masonandrewmann/drum_machine/documentation:todo/Drum Machine Footprints.xlsx

Part | Footprint | LCSC
47u
1u
10u
4u7
220u
