masonandrewmann/drum_machine/harware_design/DrumMachineControlBoard/borderSVG2n/inPXXX__TEST2__DrumMachineControlBoard-brd_.dxf

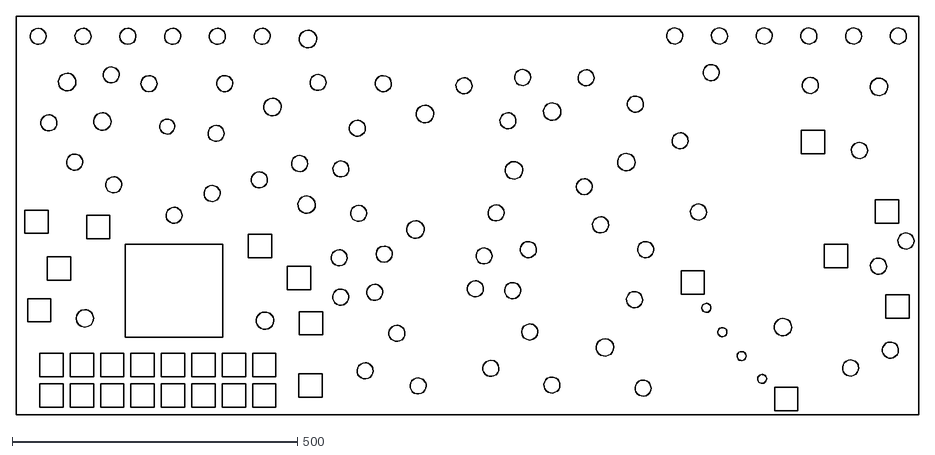
[picture p1: CAD file, 2023-01-13]
harware_design/DrumMachineControlBoard/borderSVG2n/inPXXX__TEST2__DrumMachineControlBoard-brd_.dxf
1582.3 x 697.9
