masonandrewmann/drum_machine/harware_design/DrumMachineControlBoard/borderSVG2n/TEST3__DrumMachineControlBoard-brd_.dxf

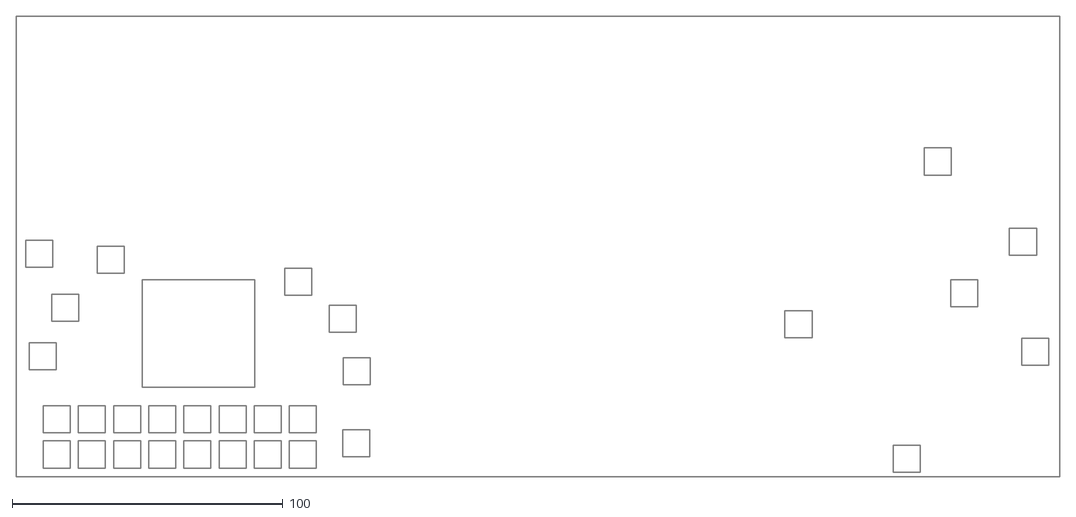
[picture p2: CAD file, 2023-01-13]
harware_design/DrumMachineControlBoard/borderSVG2n/TEST3__DrumMachineControlBoard-brd_.dxf
385.8 x 170.2
