masonandrewmann/drum_machine/harware_design/DrumMachineControlBoard/borderSVG2n/PXXX__TEST2__DrumMachineControlBoard-brd_.dxf

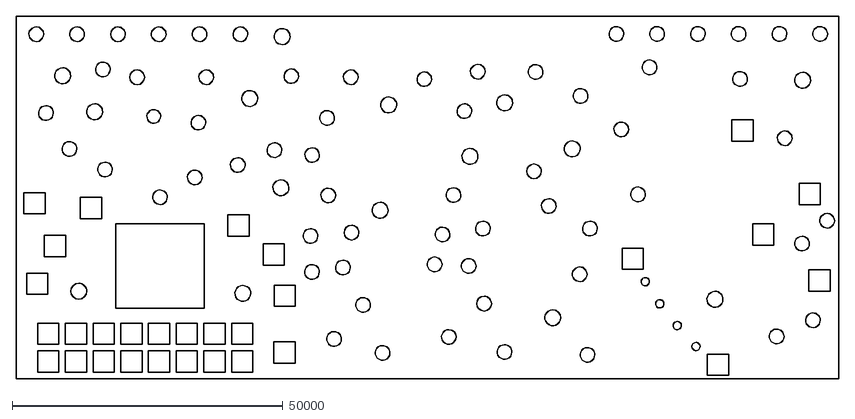
[picture p3: CAD file, 2023-01-13]
harware_design/DrumMachineControlBoard/borderSVG2n/PXXX__TEST2__DrumMachineControlBoard-brd_.dxf
151900.0 x 67003.0
