masonandrewmann/drum_machine/harware_design/DrumMachineControlBoard/borderSVG2n/mmmmTEST2__DrumMachineControlBoard-brd_.dxf

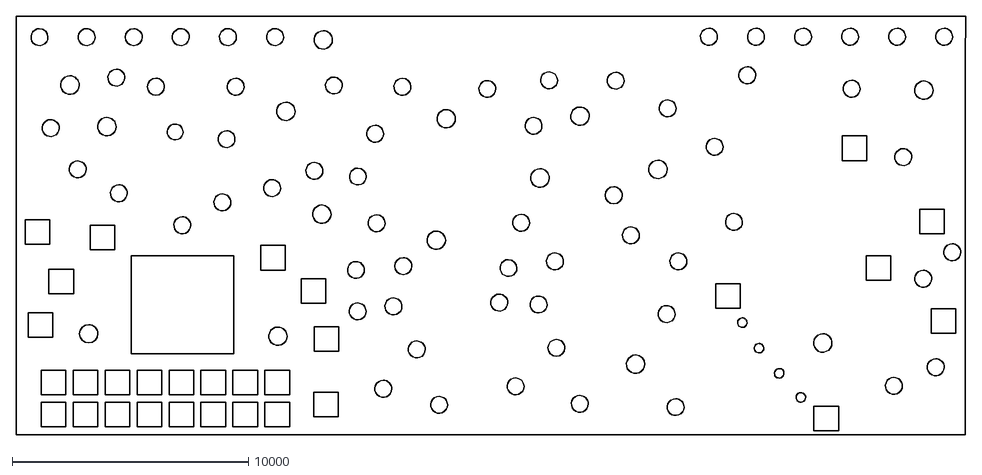
[picture p4: CAD file, 2023-01-13]
harware_design/DrumMachineControlBoard/borderSVG2n/mmmmTEST2__DrumMachineControlBoard-brd_.dxf
40190.2 x 17727.9
