masonandrewmann/drum_machine/harware_design/DrumMachineControlBoard/borderSVG2n/cmPXXX__TEST2__DrumMachineControlBoard-brd_.dxf

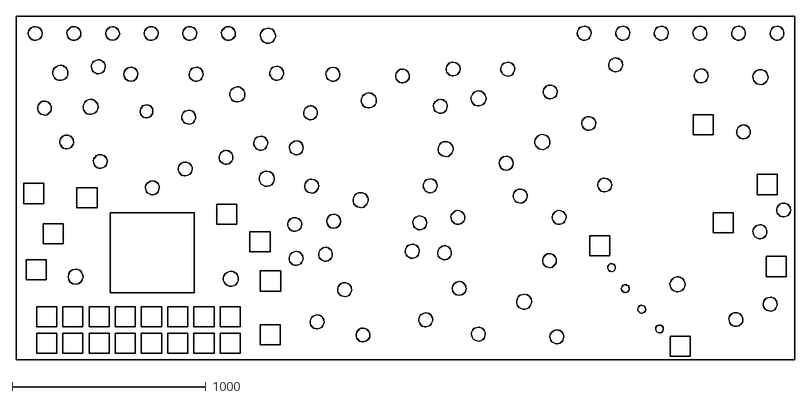
[picture p6: CAD file, 2023-01-13]
harware_design/DrumMachineControlBoard/borderSVG2n/cmPXXX__TEST2__DrumMachineControlBoard-brd_.dxf
4019.0 x 1772.8
