masonandrewmann/drum_machine/(list of files, cad)

Other CAD files:
harware_design/BassDrum_TR909/borderSVG/BassDrum_TR909-B_Mask.dxf
harware_design/TR909 Snare Drum/borderSVG/TR909 Snare Drum-B_Mask.dxf
harware_design/Triple Waveshaper - CGS/borderSVG/Triple Waveshaper - CGS-B_Mask.dxf
