masonandrewmann/drum_machine/documentation:todo/DRUM MACHINE KLUDGES AND ASSEMBLY NOTES .rtf

DRUM MACHINE KLUDGES AND ASSEMBLY NOTES

LCD SCREEN LED PIN IS WRONG - should be connected to GND rather than +3.3v
remove R177 and short pin 1 and 2 on the LCD pin header

LCD Screen mounting holes are too small for M3 screws
either use smaller screws or drill the holes bigger on the LCD screen board and control board

Pinout for 2N7000 mosfets in trigger output level shifters is wrong. pins 1 and 2 should be flipped
-just flip the mosfets upside down and bend their pins down when soldering

Trigger inputs are floating
-add 1M pulldown resistor soldered directly to jack pins

Getting audio output from shield
-need to solder wires from shield line out to input of mixer section

MIDI input
-theres capacitance in the line so pullup needs to be lower. replace R162 with a 220Ohm resistor
-optocoupler needs to pull up to 3.3v instead of 5v
-cut trace to 5v on R162 and addd a jumper to the closest 3.3v pad on the pot below it (square pad))

SNARE CONNECTIONS
-short pins W and 3 on tone pot

All volume knobs are baackwards
