masonandrewmann/drum_machine/documentation:todo/DRUM MACHINE CONTROL BOARD NOTES.rtf

DRUM MACHINE CONTROL BOARD NOTES

all trimmer style potentiometers have wrong footprint
-holes for side tabs are too small
-tabs on pots can be cut to size relatively easily

power connector next to barrel jack is wrong
-just solder it in backwards so tabs are to right on kicad board view
