masonandrewmann/drum_machine/documentation:todo/jumpers.rtf

cynare jumpers
noise/shim::: L - noise R - shim M - noise/shim
damper:::: harwire it ! - no pot - REMOVE
Decay::: L - dec1 R /M- dec23
env::: L-env3 M-env2 R-env1
freq::: L:-12 M-freqw R:+12
res:::: L-res1 M/R-res23
imp::: not doing anything maybe remove it?
switch: LP - top right HP - bottom left BP-bottomrightt COM-midleft

snare jumpers
level:::: L-lvl1 M/R-lvl3w
tune::: L-tune3 M-tuneW R-tune1
snap:::: L-snap1 MR-snap3w
tone:::: idk if its working

bass
volume:::: L-out1W MR-out3
atk:::: LM- atk1w R-atk3
dec:::: L-depth1 M-depthW R-depth3
tuneDep:::: L-tune MR-GND
tuneDec:::: LM-dec1W R-dec3
Dist::: LM-dist1W R-dist3
pitch:::: LM-pitch1W R-pitch3
