masonandrewmann/drum_machine/harware_design/Triple Waveshaper - CGS/tws.pdf

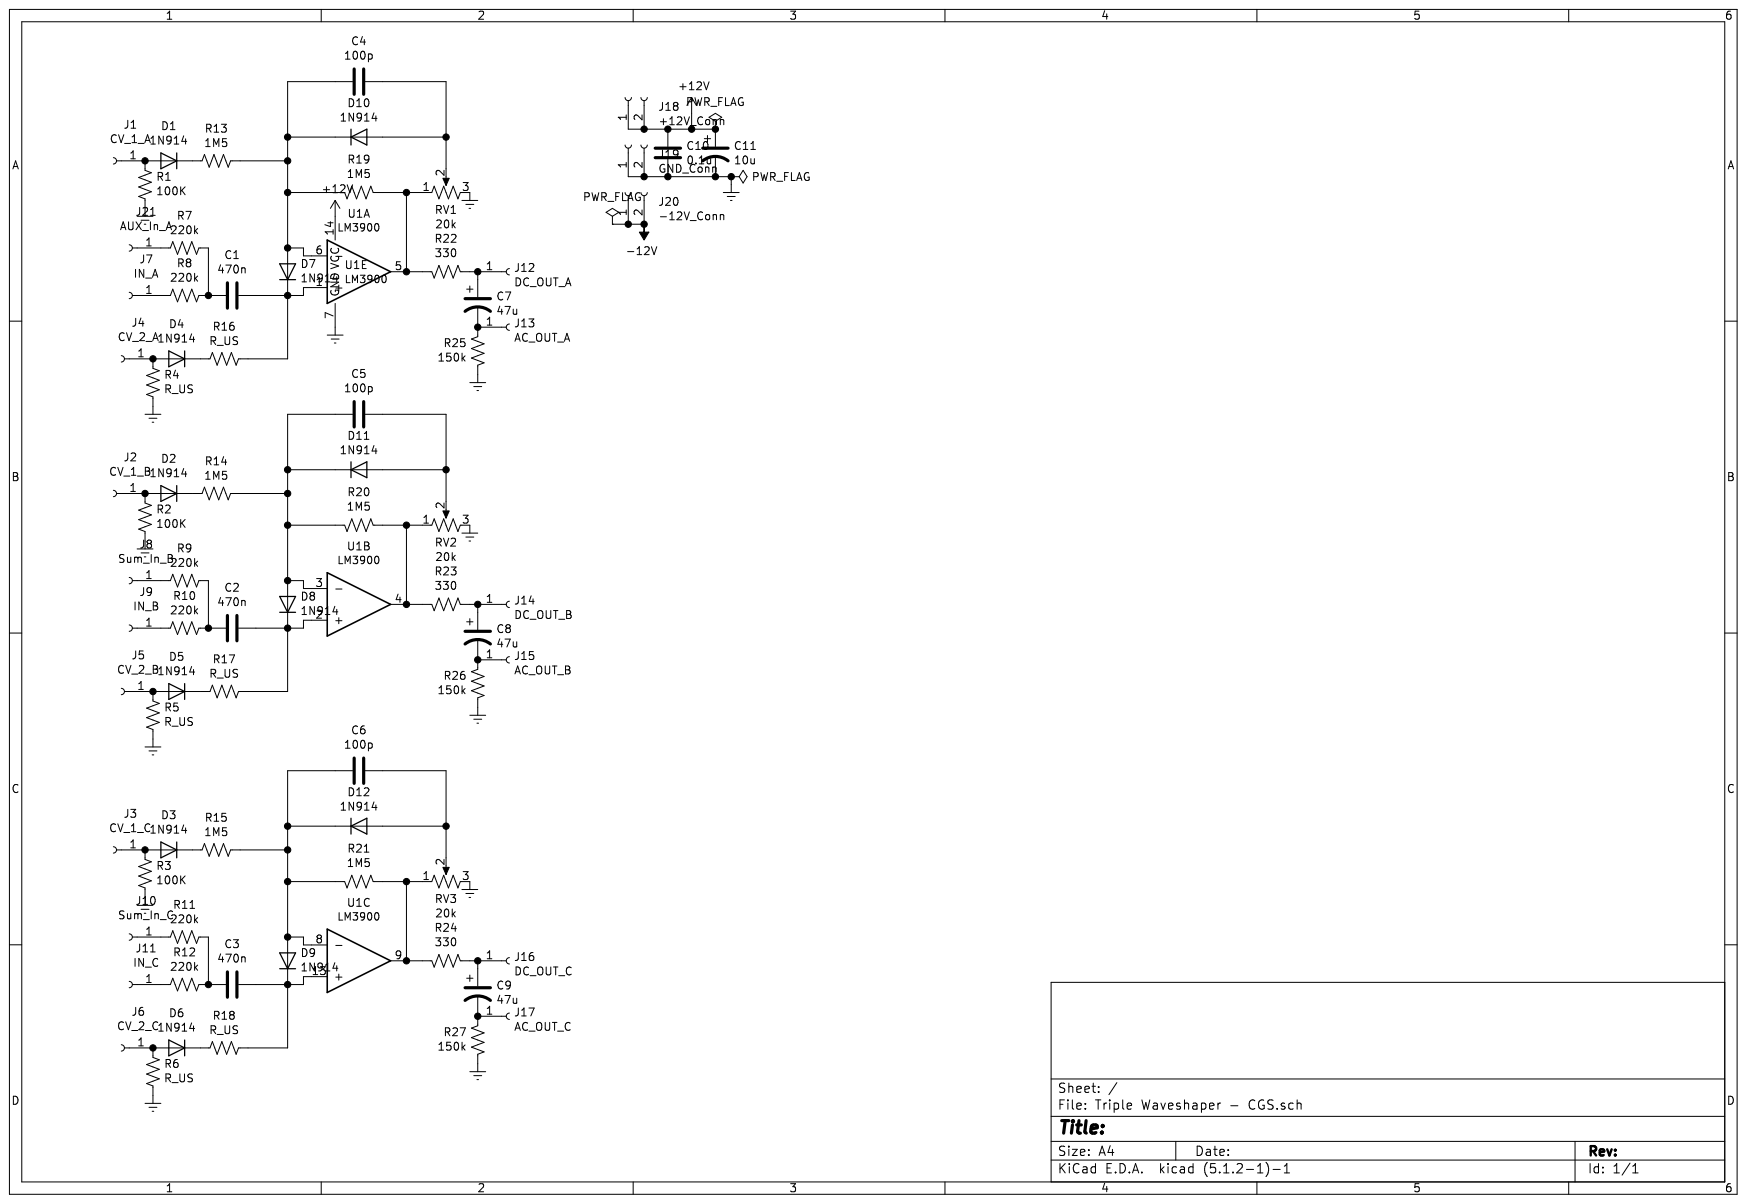
[picture p7: page 1]
