masonandrewmann/drum_machine/harware_design/ALTERNATEDrumMachinePower/borderSVG2/eeeeeffffff.pdf

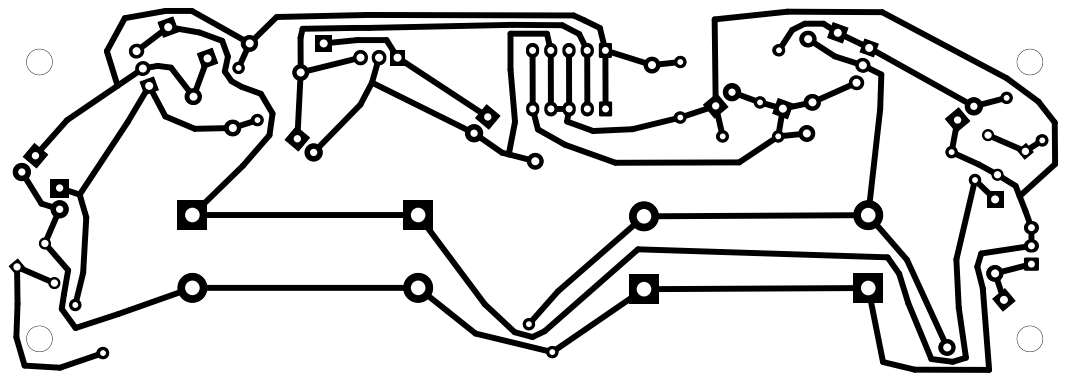
[picture p8: page 1]
