masonandrewmann/drum_machine/harware_design/TR909 Snare Drum/TR909 Snare Drum.kicad_pcb

## KiCad design harware_design/TR909 Snare Drum/TR909 Snare Drum.kicad_pcb (2023-02-01)

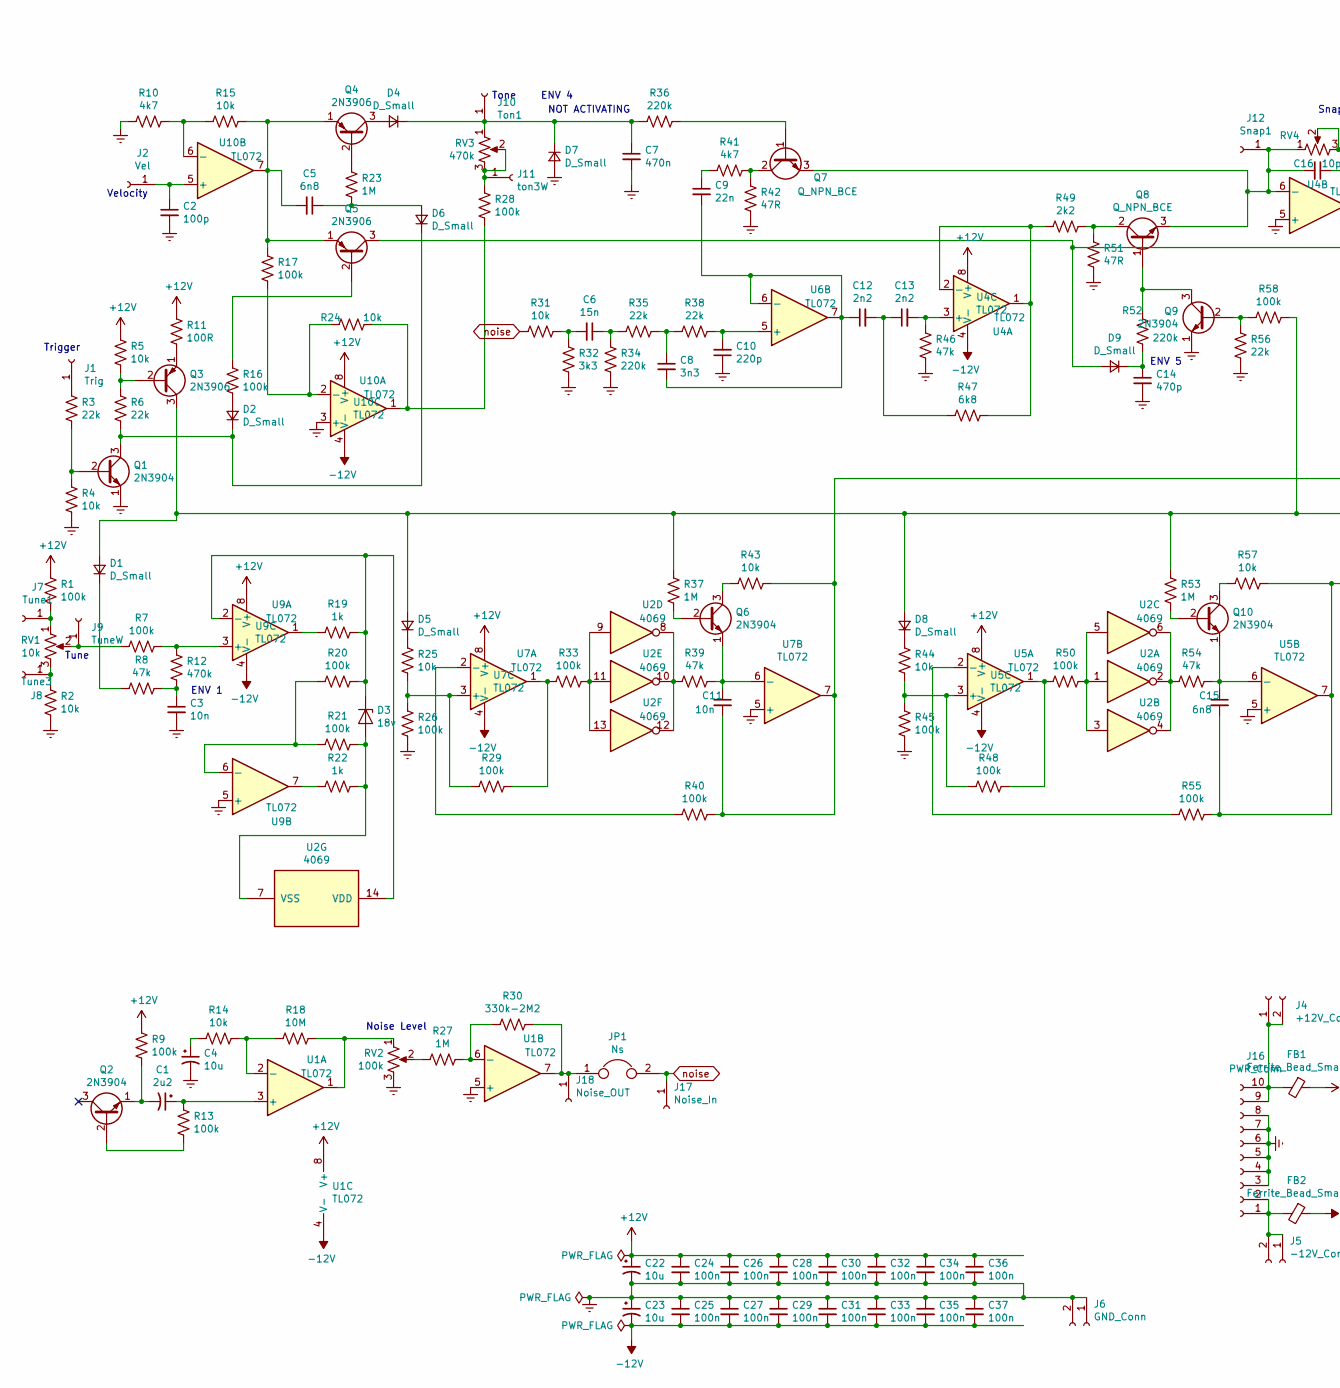
[picture p9: schematic TR909 Snare Drum.sch, part in row 1, column 1]

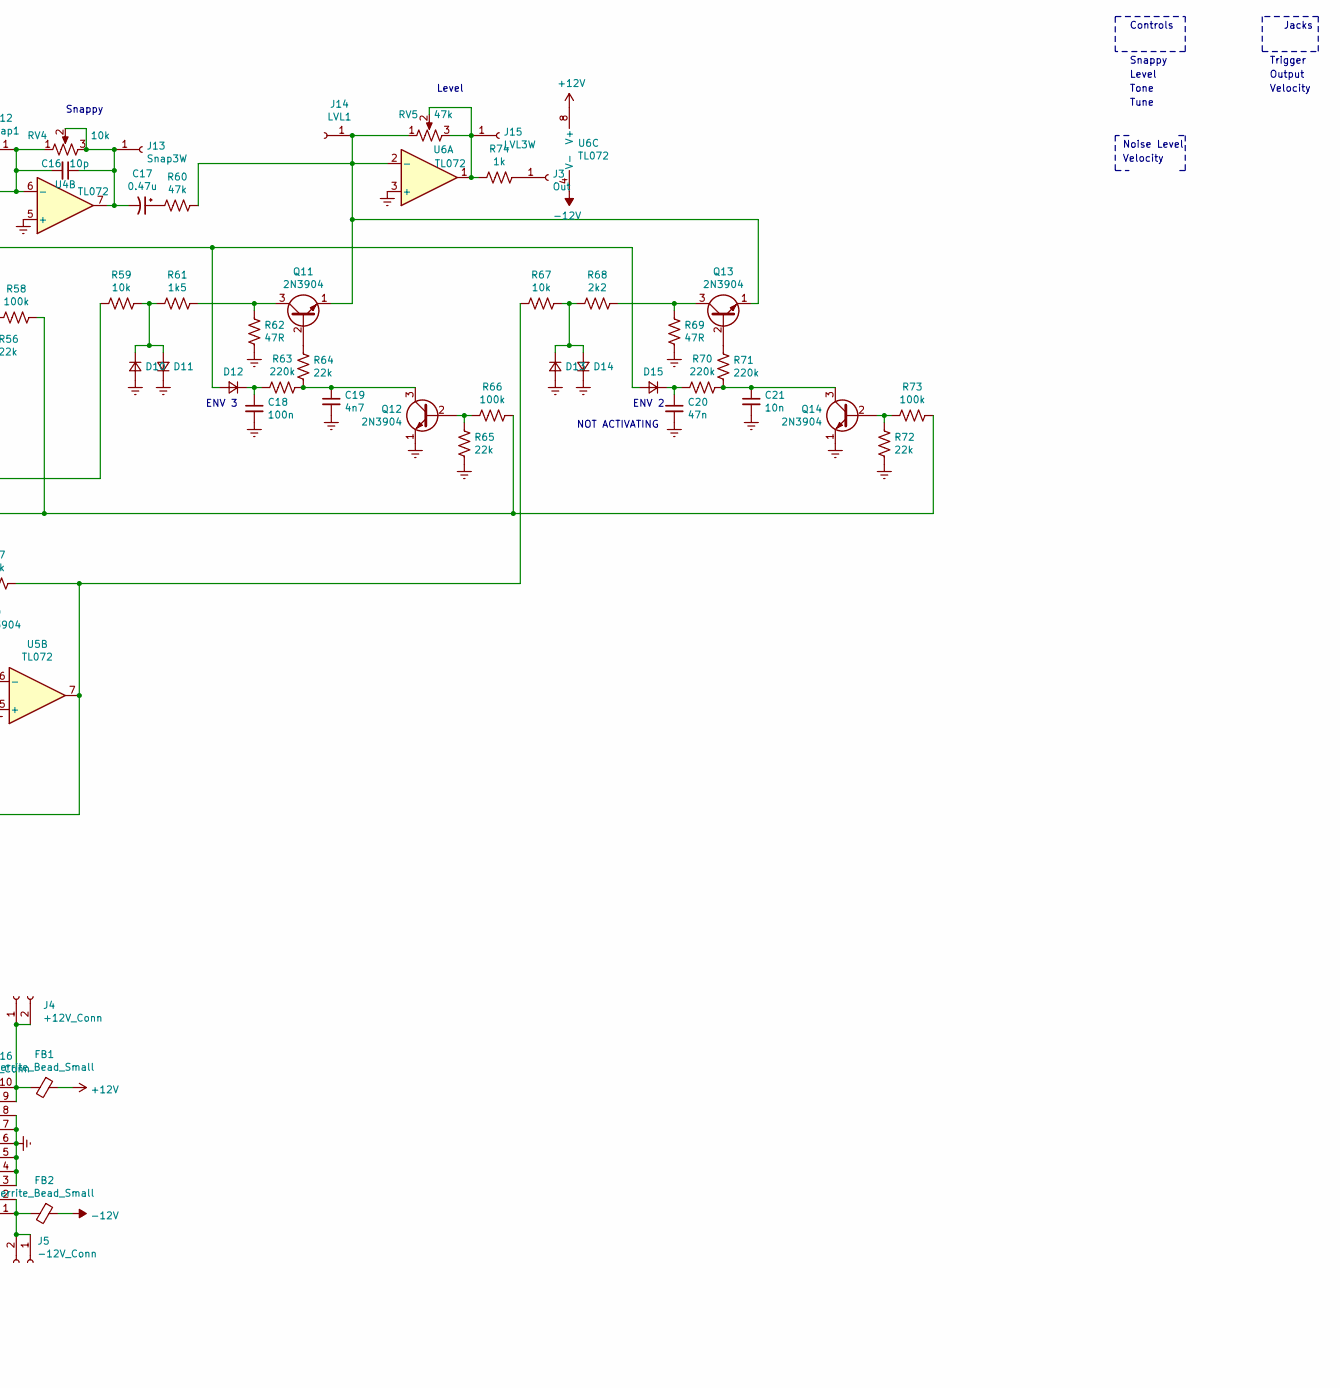
[picture p10: schematic TR909 Snare Drum.sch, part in row 1, column 2]

Parts:
C1: 2u2; C_0805_2012Metric_Pad1.15x1.40mm_HandSolder
C2: 100p; C_0603_1608Metric_Pad1.05x0.95mm_HandSolder
C3, C11, C21: 10n; C_0603_1608Metric_Pad1.05x0.95mm_HandSolder
C4, C22, C23: 10u; CP_Elec_5x5.4
C5, C15: 6n8; C_0603_1608Metric_Pad1.05x0.95mm_HandSolder
C6: 15n; C_0603_1608Metric_Pad1.05x0.95mm_HandSolder
C7: 470n; C_0603_1608Metric_Pad1.05x0.95mm_HandSolder
C8: 3n3; C_0603_1608Metric_Pad1.05x0.95mm_HandSolder
C9: 22n; C_0603_1608Metric_Pad1.05x0.95mm_HandSolder
C10: 220p; C_0603_1608Metric_Pad1.05x0.95mm_HandSolder
C12, C13: 2n2; C_0603_1608Metric_Pad1.05x0.95mm_HandSolder
C14: 470p; C_0603_1608Metric_Pad1.05x0.95mm_HandSolder
C16: 10p; C_0603_1608Metric_Pad1.05x0.95mm_HandSolder
C17: 0.47u; C_0603_1608Metric_Pad1.05x0.95mm_HandSolder
C18, C24, C25, C26, C27, C28, C29, C30, C31, C32, C33, C34, C35, C36, C37: 100n; C_0603_1608Metric_Pad1.05x0.95mm_HandSolder
C19: 4n7; C_0603_1608Metric_Pad1.05x0.95mm_HandSolder
C20: 47n; C_0603_1608Metric_Pad1.05x0.95mm_HandSolder
D1, D2, D4, D5, D6, D7, D8, D9, D10, D11, D12, D13, D14, D15: D_Small; D_SOD-323_HandSoldering
D3: 18v; D_T-1_P5.08mm_Horizontal
FB1, FB2: Ferrite_Bead_Small; L_Axial_L7.0mm_D3.3mm_P2.54mm_Vertical_Fastron_MICC
J1: Trig; SolderWirePad_1x01_Drill1mm
J2: Vel; SolderWirePad_1x01_Drill1mm
J3: Out; SolderWirePad_1x01_Drill1mm
J4: +12V_Conn; SolderWirePad_1x02_P3.81mm_Drill1mm
J5: -12V_Conn; SolderWirePad_1x02_P3.81mm_Drill1mm
J6: GND_Conn; SolderWirePad_1x02_P3.81mm_Drill1mm
J7: Tune1; SolderWirePad_1x01_Drill1mm
J8: Tune3; SolderWirePad_1x01_Drill1mm
J9: TuneW; SolderWirePad_1x01_Drill1mm
J10: Ton1; SolderWirePad_1x01_Drill1mm
J11: ton3W; SolderWirePad_1x01_Drill1mm
J12: Snap1; SolderWirePad_1x01_Drill1mm
J13: Snap3W; SolderWirePad_1x01_Drill1mm
J14: LVL1; SolderWirePad_1x01_Drill1mm
J15: LVL3W; SolderWirePad_1x01_Drill1mm
J16: PWR_Conn; IDC-Header_2x05_P2.54mm_Vertical
J17: Noise_In; SolderWirePad_1x01_Drill1mm
J18: Noise_OUT; SolderWirePad_1x01_Drill1mm
JP1: Ns; SolderJumper-2_P1.3mm_Open_RoundedPad1.0x1.5mm
Q1, Q2, Q6, Q9, Q10, Q11, Q12, Q13, Q14: 2N3904; TSOT-23_HandSoldering
Q3, Q4, Q5: 2N3906; TSOT-23_HandSoldering
Q7, Q8: Q_NPN_BCE; SolderWirePad_1x03_P3.81mm_Drill1.2mm
R1, R7, R9, R13, R16, R17, R20, R21, R26, R28, R29, R33, R40, R45, R48, R50, R55, R58, R66, R73: 100k; R_0603_1608Metric_Pad1.05x0.95mm_HandSolder
R2, R4, R5, R14, R15, R24, R25, R31, R43, R44, R57, R59, R67: 10k; R_0603_1608Metric_Pad1.05x0.95mm_HandSolder
R3, R6, R35, R38, R56, R64, R65, R72: 22k; R_0603_1608Metric_Pad1.05x0.95mm_HandSolder
R8, R39, R46, R54, R60: 47k; R_0603_1608Metric_Pad1.05x0.95mm_HandSolder
R10, R41: 4k7; R_0603_1608Metric_Pad1.05x0.95mm_HandSolder
R11: 100R; R_0603_1608Metric_Pad1.05x0.95mm_HandSolder
R12: 470k; R_0603_1608Metric_Pad1.05x0.95mm_HandSolder
R18: 10M; R_0603_1608Metric_Pad1.05x0.95mm_HandSolder
R19, R22, R74: 1k; R_0603_1608Metric_Pad1.05x0.95mm_HandSolder
R23, R27, R37, R53: 1M; R_0603_1608Metric_Pad1.05x0.95mm_HandSolder
R30: 330k-2M2; R_Axial_DIN0207_L6.3mm_D2.5mm_P7.62mm_Horizontal
R32: 3k3; R_0603_1608Metric_Pad1.05x0.95mm_HandSolder
R34, R36, R52, R63, R70, R71: 220k; R_0603_1608Metric_Pad1.05x0.95mm_HandSolder
R42, R51, R62, R69: 47R; R_0603_1608Metric_Pad1.05x0.95mm_HandSolder
R47: 6k8; R_0603_1608Metric_Pad1.05x0.95mm_HandSolder
R49, R68: 2k2; R_0603_1608Metric_Pad1.05x0.95mm_HandSolder
R61: 1k5; R_0603_1608Metric_Pad1.05x0.95mm_HandSolder
RV1, RV4: 10k; Potentiometer_Runtron_RM-065_Vertical
RV2: 100k; Potentiometer_Runtron_RM-065_Vertical
RV3: 470k; Potentiometer_Runtron_RM-065_Vertical
RV5: 47k; Potentiometer_Runtron_RM-065_Vertical
U1, U4, U5, U6, U7, U9, U10: TL072; SOIC-8_3.9x4.9mm_P1.27mm
U2: 4069; SOIC-14_3.9x8.7mm_P1.27mm

Connections:
+12V: C22.1, C24.1, C26.1, C28.1, C30.1, C32.1, C34.1, C36.1, FB1.1, R1.1, R5.2, R9.1, R11.2, U1.8 (V+), U4.8 (V+), U5.8 (V+), U6.8 (V+), U7.8 (V+), U9.8 (V+), U10.8 (V+)
-12V: C23.2, C25.2, C27.2, C29.2, C31.2, C33.2, C35.2, C37.2, FB2.1, U1.4 (V-), U4.4 (V-), U5.4 (V-), U6.4 (V-), U7.4 (V-), U9.4 (V-), U10.4 (V-)
Earth: C2.2, C3.2, C4.2, C7.2, C10.1, C14.2, C18.2, C19.2, C20.2, C21.2, C22.2, C23.1, C24.2, C25.1, C26.2, C27.1, C28.2, C29.1, C30.2, C31.1, C32.2, C33.1, C34.2, C35.1, C36.2, C37.1, D7.2 (A), D10.2 (A), D11.1 (K), D13.2 (A), D14.1 (K), J6.1, J6.2, J16.3, J16.4, J16.5, J16.6, J16.7, J16.8, Q1.1 (E), Q9.1 (E), Q12.1 (E), Q14.1 (E), R2.2, R4.1, R10.2, R26.2, R32.1, R34.1, R42.2, R45.2, R46.2, R51.1, R56.1, R62.2, R65.2, R69.2, R72.2, RV2.3, U1.5 (+), U4.5 (+), U5.5 (+), U6.3 (+), U7.5 (+), U9.5 (+), U10.3 (+)
unnamed: C1.1, R13.1, U1.3 (+)
unnamed: C1.2, Q2.1 (E), R9.2
unnamed: C2.1, J2.1, U10.5 (+)
unnamed: C3.1, R8.2, R12.2
unnamed: C4.1, R14.2
unnamed: C5.1, D6.2 (A), R23.1
unnamed: C5.2, Q4.1 (E), Q5.1 (E), R15.1, R17.2, U10.7
unnamed: C6.1, R34.2, R35.1
unnamed: C6.2, R31.1, R32.2
unnamed: C7.1, D4.1 (K), D7.1 (K), J10.1, R36.1, RV3.1
unnamed: C8.1, R35.2, R38.1
unnamed: C9.1, R41.1
unnamed: C10.2, R38.2, U6.5 (+)
unnamed: C11.1, Q6.1 (E), R39.2, U7.6 (-)
unnamed: C11.2, R40.2, R43.1, R59.1, U7.7
unnamed: C8.2, C9.2, C12.1, U6.6 (-), U6.7
unnamed: C12.2, C13.1, R47.1
unnamed: C13.2, R46.1, U4.3 (+)
unnamed: C14.1, D9.1 (K), R52.1
unnamed: C15.1, Q10.1 (E), R54.2, U5.6 (-)
unnamed: C15.2, R55.2, R57.1, R67.1, U5.7
unnamed: C16.1, C17.2, J13.1, RV4.2, RV4.3, U4.7
unnamed: C16.2, J12.1, Q7.3 (E), Q8.3 (E), RV4.1, U4.6 (-)
unnamed: C17.1, R60.2
unnamed: C18.1, D12.1 (K), R63.2
unnamed: C19.1, Q12.3 (C), R63.1, R64.2
unnamed: C20.1, D15.1 (K), R70.2
unnamed: C21.1, Q14.3 (C), R70.1, R71.2
unnamed: D1.1 (K), R8.1
unnamed: D1.2 (A), D5.2 (A), D8.2 (A), Q3.3 (C), R37.1, R53.1, R58.2, R66.1, R73.1
unnamed: D2.1 (K), D6.1 (K), Q1.3 (C), R6.1
unnamed: D2.2 (A), R16.1
unnamed: D3.1 (K), R19.2, R20.2, U2.14 (VDD), U9.2 (-)
unnamed: D3.2 (A), R21.2, R22.2, U2.7 (VSS)
unnamed: D4.2 (A), Q4.3 (C)
unnamed: D5.1 (K), R25.1
unnamed: D8.1 (K), R44.1
unnamed: D10.1 (K), D11.2 (A), R59.2, R61.1
unnamed: D9.2 (A), D12.2 (A), D15.2 (A), Q5.3 (C)
unnamed: D13.1 (K), D14.2 (A), R67.2, R68.1
unnamed: FB1.2, J4.1, J4.2, J16.9, J16.10
unnamed: FB2.2, J5.1, J5.2, J16.1, J16.2
unnamed: J1.1, R3.2
unnamed: J3.1, R74.2
unnamed: J7.1, R1.2, RV1.1
unnamed: J8.1, R2.1, RV1.3
unnamed: J9.1, R7.1, RV1.2
unnamed: J11.1, R28.2, RV3.2, RV3.3
unnamed: J14.1, Q11.1 (E), Q13.1 (E), R60.1, RV5.1, U6.2 (-)
unnamed: J15.1, R74.1, RV5.2, RV5.3, U6.1
unnamed: J18.1, JP1.1, R30.1, U1.7
unnamed: Q1.2 (B), R3.1, R4.2
unnamed: Q2.2 (B), R13.2
unnamed: Q3.1 (E), R11.1
unnamed: Q3.2 (B), R5.1, R6.2
unnamed: Q4.2 (B), R23.2
unnamed: Q5.2 (B), R16.2
unnamed: Q6.2 (B), R37.2
unnamed: Q6.3 (C), R43.2
unnamed: Q7.1 (B), R36.2
unnamed: Q7.2 (C), R41.2, R42.1
unnamed: Q8.1 (B), Q9.3 (C), R52.2
unnamed: Q8.2 (C), R49.1, R51.2
unnamed: Q9.2 (B), R56.2, R58.1
unnamed: Q10.2 (B), R53.2
unnamed: Q10.3 (C), R57.2
unnamed: Q11.2 (B), R64.1
unnamed: Q11.3 (C), R61.2, R62.1
unnamed: Q12.2 (B), R65.1, R66.2
unnamed: Q13.2 (B), R71.1
unnamed: Q13.3 (C), R68.2, R69.1
unnamed: Q14.2 (B), R72.1, R73.2
unnamed: R10.1, R15.2, U10.6 (-)
unnamed: R7.2, R12.1, U9.3 (+)
unnamed: R14.1, R18.2, U1.2 (-)
unnamed: R17.1, R24.1, U10.2 (-)
unnamed: R18.1, RV2.1, U1.1
unnamed: R19.1, U9.1
unnamed: R20.1, R21.1, U9.6 (-)
unnamed: R22.1, U9.7
unnamed: R24.2, R28.1, U10.1
unnamed: R25.2, R26.1, R29.1, U7.3 (+)
unnamed: R27.1, R30.2, U1.6 (-)
unnamed: R27.2, RV2.2
unnamed: R29.2, R33.1, U7.1
unnamed: R33.2, U2.9, U2.11, U2.13
unnamed: R39.1, U2.8, U2.10, U2.12
unnamed: R40.1, U7.2 (-)
unnamed: R44.2, R45.1, R48.1, U5.3 (+)
unnamed: R47.2, R49.2, U4.1, U4.2 (-)
unnamed: R48.2, R50.1, U5.1
unnamed: R50.2, U2.1, U2.3, U2.5
unnamed: R54.1, U2.2, U2.4, U2.6
unnamed: R55.1, U5.2 (-)
noise: J17.1, JP1.2, R31.2

Notes on the sheet:
Velocity
Trigger
Tone
Noise Level
Tune
Snappy
Level
Controls
Jacks
Output
ENV 4
ENV 1
ENV 5
ENV 3
ENV 2
NOT ACTIVATING

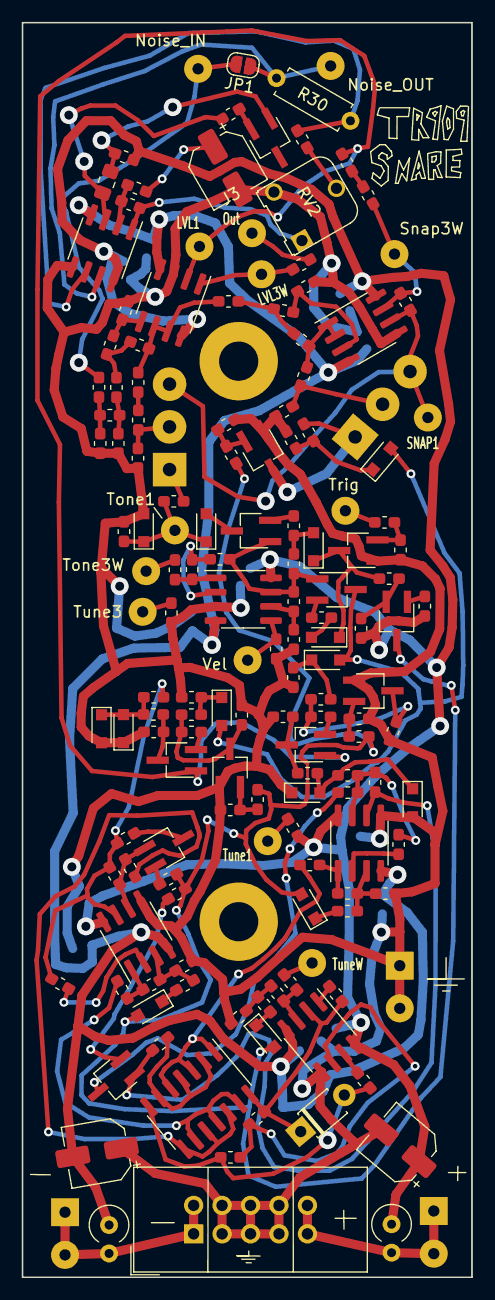
[picture p11: board TR909 Snare Drum.kicad_pcb from above]

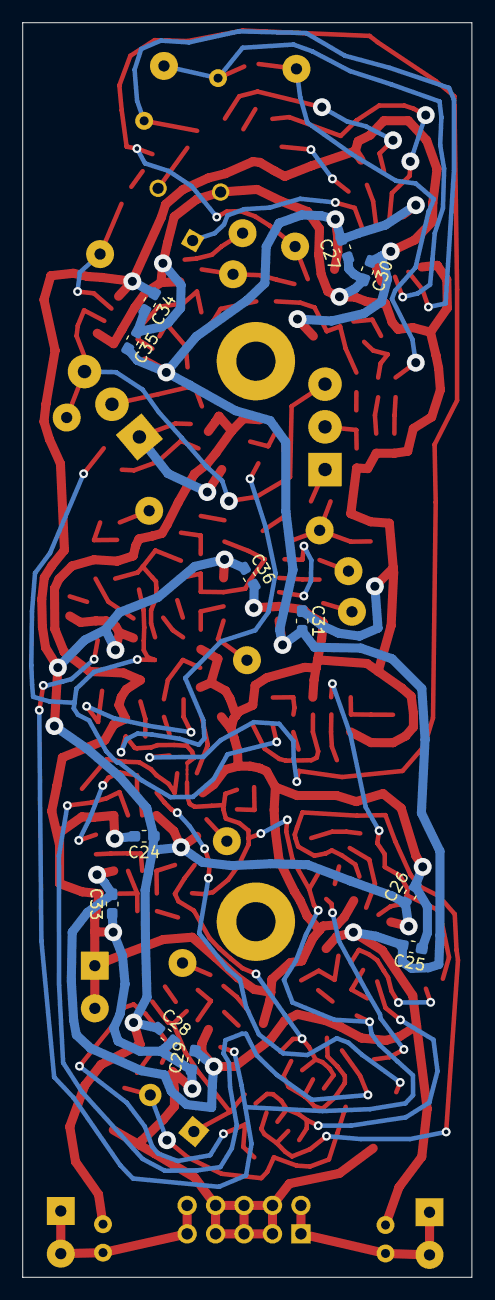
[picture p12: board TR909 Snare Drum.kicad_pcb from below]

Board: 2 copper layers, 40.1 x 112.0 mm, 168 parts (12 on the bottom side), 98 nets.
