masonandrewmann/drum_machine/harware_design/BassDrum_TR909/BassDrum_TR909.kicad_pcb

## KiCad design harware_design/BassDrum_TR909/BassDrum_TR909.kicad_pcb (2023-02-01)

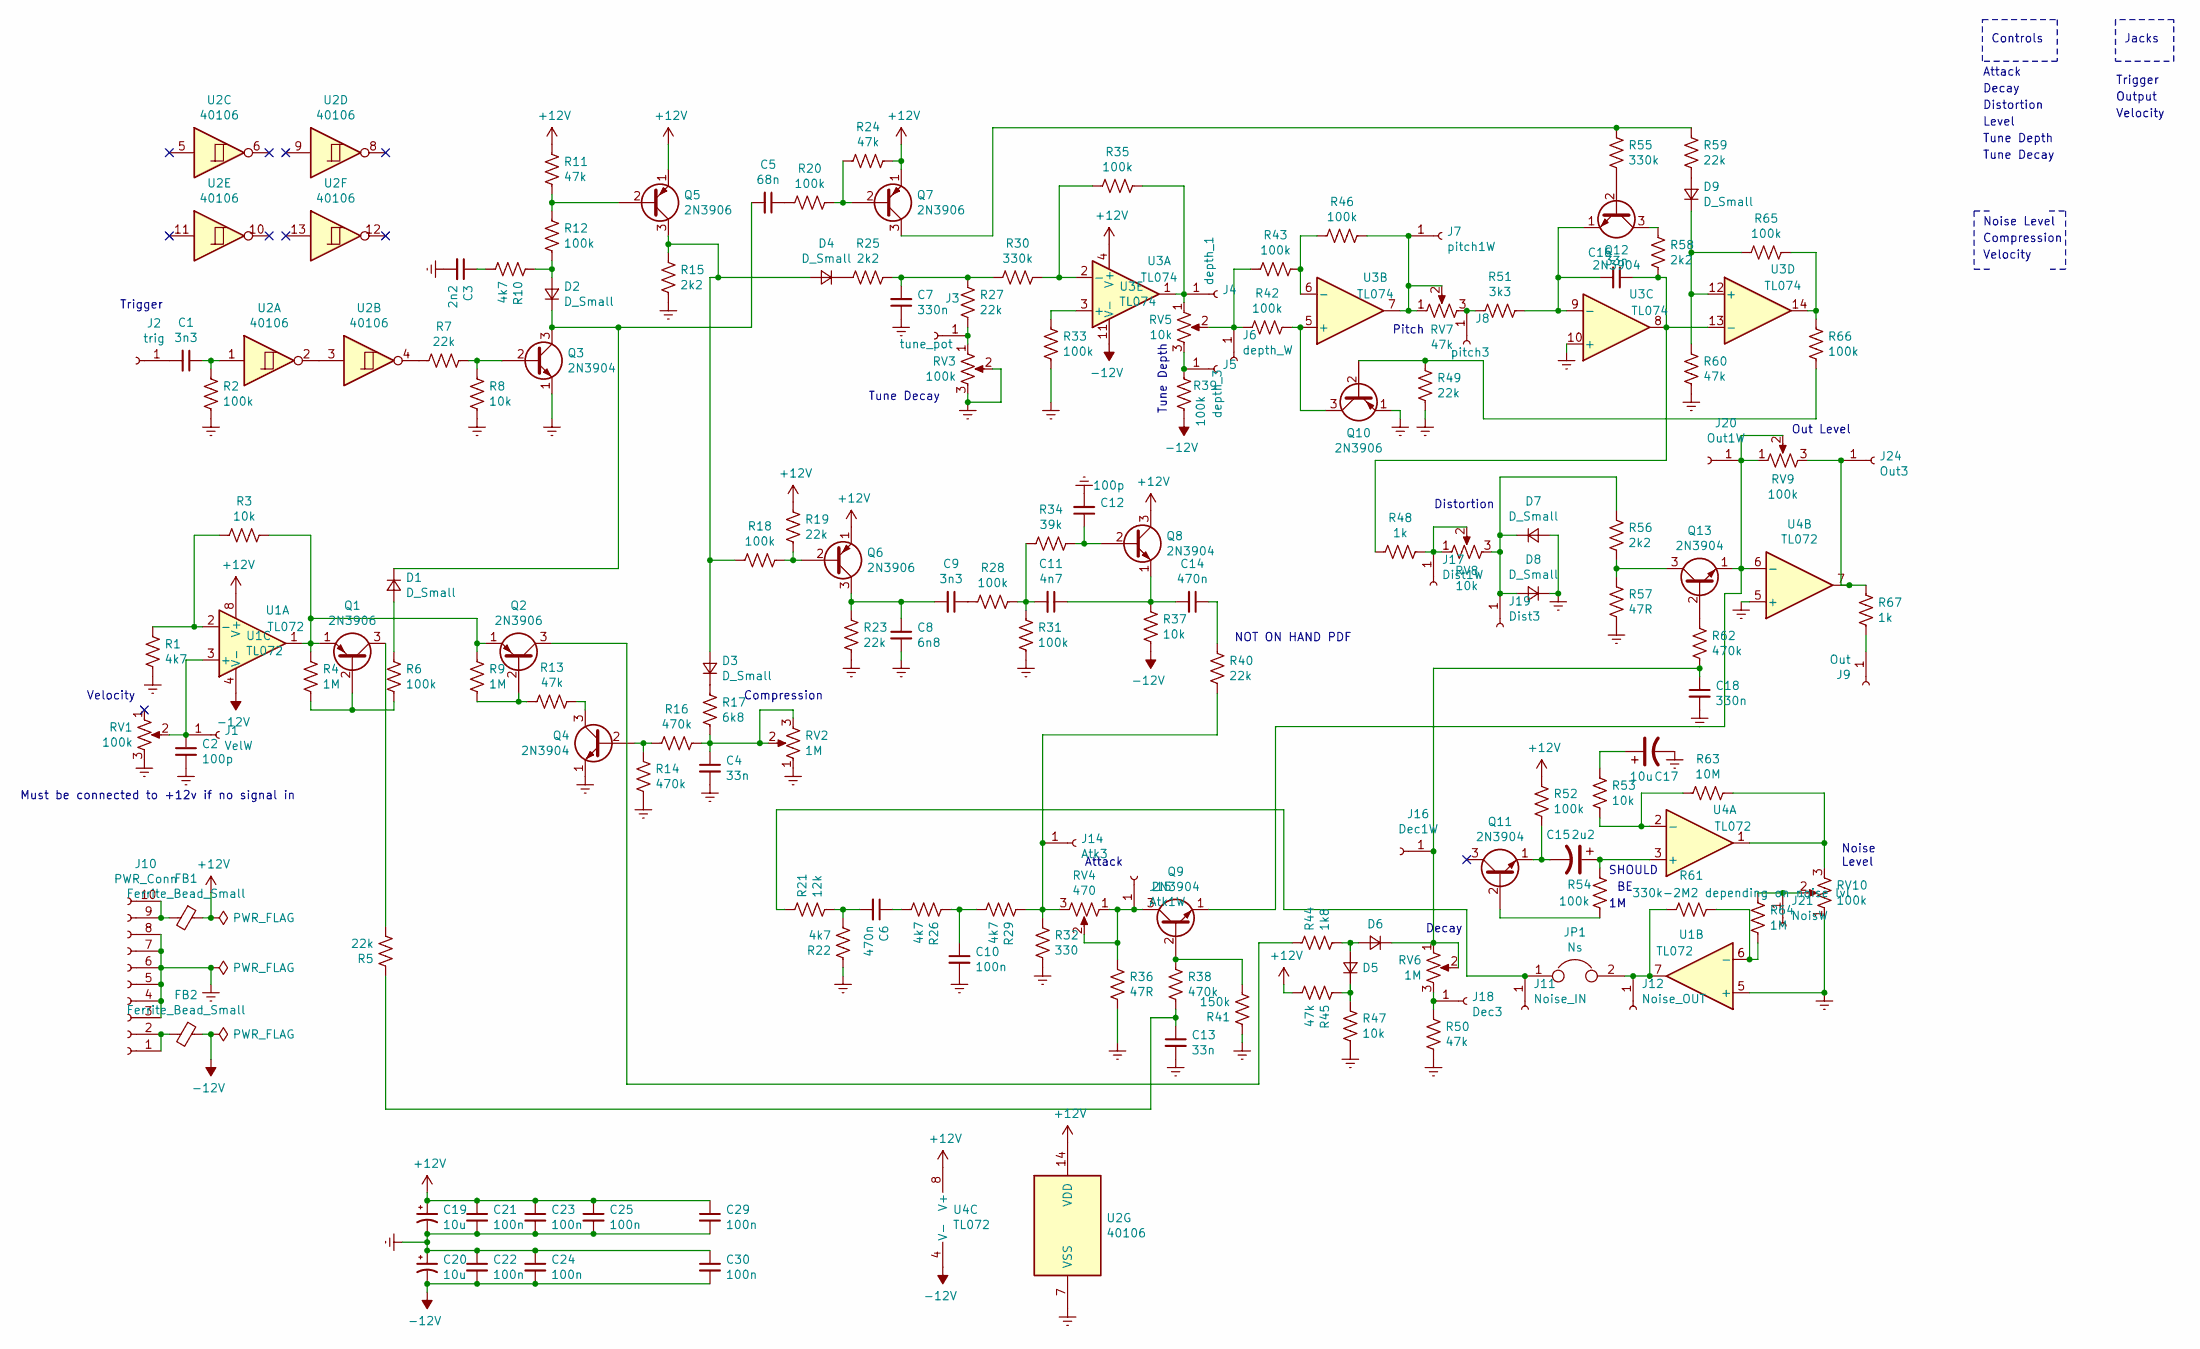
[picture p13: schematic BassDrum_TR909.sch]

Parts:
C1, C9: 3n3; C_0603_1608Metric_Pad1.05x0.95mm_HandSolder
C2, C12: 100p; C_0603_1608Metric_Pad1.05x0.95mm_HandSolder
C3: 2n2; C_0603_1608Metric_Pad1.05x0.95mm_HandSolder
C4, C13, C16: 33n; C_0603_1608Metric_Pad1.05x0.95mm_HandSolder
C5: 68n; C_0603_1608Metric_Pad1.05x0.95mm_HandSolder
C6, C14: 470n; C_0603_1608Metric_Pad1.05x0.95mm_HandSolder
C7, C18: 330n; C_0603_1608Metric_Pad1.05x0.95mm_HandSolder
C8: 6n8; C_0603_1608Metric_Pad1.05x0.95mm_HandSolder
C10, C21, C22, C23, C24, C25, C29, C30: 100n; C_0603_1608Metric_Pad1.05x0.95mm_HandSolder
C11: 4n7; C_0603_1608Metric_Pad1.05x0.95mm_HandSolder
C15: 2u2; C_0603_1608Metric_Pad1.05x0.95mm_HandSolder
C17, C19, C20: 10u; CP_Elec_5x5.4
D1, D2, D3, D4, D5, D6, D7, D8, D9: D_Small; D_SOD-323
FB1, FB2: Ferrite_Bead_Small; L_Axial_L7.0mm_D3.3mm_P2.54mm_Vertical_Fastron_MICC
J1: VelW; SolderWirePad_1x01_Drill1mm
J2: trig; SolderWirePad_1x01_Drill1mm
J3: tune_pot; SolderWirePad_1x01_Drill1mm
J4: depth_1; SolderWirePad_1x01_Drill1mm
J5: depth_3; SolderWirePad_1x01_Drill1mm
J6: depth_W; SolderWirePad_1x01_Drill1mm
J7: pitch1W; SolderWirePad_1x01_Drill1mm
J8: pitch3; SolderWirePad_1x01_Drill1mm
J9: Out; SolderWirePad_1x01_Drill1mm
J10: PWR_Conn; IDC-Header_2x05_P2.54mm_Vertical
J11: Noise_IN; SolderWirePad_1x01_Drill1mm
J12: Noise_OUT; SolderWirePad_1x01_Drill1mm
J14: Atk3; SolderWirePad_1x01_Drill1mm
J15: Atk1W; SolderWirePad_1x01_Drill1mm
J16: Dec1W; SolderWirePad_1x01_Drill1mm
J17: Dist1W; SolderWirePad_1x01_Drill1mm
J18: Dec3; SolderWirePad_1x01_Drill1mm
J19: Dist3; SolderWirePad_1x01_Drill1mm
J20: Out1W; SolderWirePad_1x01_Drill1mm
J21: NoisW; SolderWirePad_1x01_Drill1mm
J24: Out3; SolderWirePad_1x01_Drill1mm
JP1: Ns; SolderJumper-2_P1.3mm_Open_RoundedPad1.0x1.5mm
Q1, Q2, Q5, Q6, Q7, Q10: 2N3906; TSOT-23_HandSoldering
Q3, Q4, Q8, Q9, Q11, Q12, Q13: 2N3904; TSOT-23_HandSoldering
R1, R10, R22, R26, R29: 4k7; R_0603_1608Metric_Pad1.05x0.95mm_HandSolder
R2, R6, R12, R18, R20, R28, R31, R33, R35, R39, R42, R43, R46, R52, R54, R65, R66: 100k; R_0603_1608Metric_Pad1.05x0.95mm_HandSolder
R3, R8, R37, R47, R53: 10k; R_0603_1608Metric_Pad1.05x0.95mm_HandSolder
R4, R9, R64: 1M; R_0603_1608Metric_Pad1.05x0.95mm_HandSolder
R5, R7, R19, R23, R27, R40, R49, R59: 22k; R_0603_1608Metric_Pad1.05x0.95mm_HandSolder
R11, R13, R24, R45, R50, R60: 47k; R_0603_1608Metric_Pad1.05x0.95mm_HandSolder
R14, R16, R38, R62: 470k; R_0603_1608Metric_Pad1.05x0.95mm_HandSolder
R15, R25, R56, R58: 2k2; R_0603_1608Metric_Pad1.05x0.95mm_HandSolder
R17: 6k8; R_0603_1608Metric_Pad1.05x0.95mm_HandSolder
R21: 12k; R_0603_1608Metric_Pad1.05x0.95mm_HandSolder
R30, R55: 330k; R_0603_1608Metric_Pad1.05x0.95mm_HandSolder
R32: 330; R_0603_1608Metric_Pad1.05x0.95mm_HandSolder
R34: 39k; R_0603_1608Metric_Pad1.05x0.95mm_HandSolder
R36, R57: 47R; R_0603_1608Metric_Pad1.05x0.95mm_HandSolder
R41: 150k; R_0603_1608Metric_Pad1.05x0.95mm_HandSolder
R44: 1k8; R_0603_1608Metric_Pad1.05x0.95mm_HandSolder
R48, R67: 1k; R_0603_1608Metric_Pad1.05x0.95mm_HandSolder
R51: 3k3; R_0603_1608Metric_Pad1.05x0.95mm_HandSolder
R61: 330k-2M2 depending on noise lvl; R_Axial_DIN0207_L6.3mm_D2.5mm_P7.62mm_Horizontal
R63: 10M; R_0603_1608Metric_Pad1.05x0.95mm_HandSolder
RV1, RV3, RV9: 100k
RV2: 1M; Potentiometer_Runtron_RM-065_Vertical
RV4: 470
RV5, RV8: 10k
RV6: 1M
RV7: 47k
RV10: 100k; Potentiometer_Runtron_RM-065_Vertical
U1, U4: TL072; SOIC-8_3.9x4.9mm_P1.27mm
U2: 40106; SOIC-14_3.9x8.7mm_P1.27mm
U3: TL074; SOIC-14_3.9x8.7mm_P1.27mm

Connections:
+12V: C19.1, C21.1, C23.1, C25.1, C29.1, FB1.1, Q5.1 (E), Q6.1 (E), Q7.1 (E), Q8.3 (C), R11.2, R19.2, R24.2, R45.2, R52.2, U1.8 (V+), U2.14 (VDD), U3.4 (V+), U4.8 (V+)
-12V: C20.2, C22.2, C24.2, C30.2, FB2.1, R37.2, R39.1, U1.4 (V-), U3.11 (V-), U4.4 (V-)
Earth: C2.2, C3.2, C4.2, C7.1, C8.2, C10.2, C12.2, C13.2, C17.2, C18.2, C19.2, C20.1, C21.2, C22.1, C23.2, C24.1, C25.2, C29.2, C30.1, D7.2 (A), D8.1 (K), J10.3, J10.4, J10.5, J10.6, J10.7, J10.8, Q3.1 (E), Q4.1 (E), Q10.1 (E), R1.1, R2.1, R8.1, R14.2, R15.1, R22.1, R23.1, R31.2, R32.2, R33.1, R36.2, R41.1, R47.2, R49.2, R50.2, R57.2, R60.2, RV1.3, RV2.1, RV3.2, RV3.3, RV10.1, U1.5 (+), U2.7 (VSS), U3.10 (+), U4.5 (+)
unnamed: C1.1, R2.2, U2.1
unnamed: C1.2, J2.1
unnamed: C2.1, J1.1, RV1.2, U1.3 (+)
unnamed: C3.1, R10.1
unnamed: C4.1, R16.1, R17.1, RV2.2, RV2.3
unnamed: C5.1, R20.1
unnamed: C5.2, D1.1 (K), D2.1 (K), Q3.3 (C)
unnamed: C6.1, R26.2
unnamed: C6.2, R21.2, R22.2
unnamed: C7.2, R25.2, R27.1, R30.2
unnamed: C8.1, C9.2, Q6.3 (C), R23.2
unnamed: C9.1, R28.1
unnamed: C10.1, R26.1, R29.2
unnamed: C11.1, C14.2, Q8.1 (E), R37.1
unnamed: C11.2, R28.2, R31.1, R34.1
unnamed: C12.1, Q8.2 (B), R34.2
unnamed: C13.1, R5.1, R38.2
unnamed: C14.1, R40.1
unnamed: C15.1, R54.2, U4.3 (+)
unnamed: C15.2, Q11.1 (E), R52.1
unnamed: C16.1, R48.1, R58.2, U3.8, U3.13 (-)
unnamed: C16.2, Q12.1 (E), R51.2, U3.9 (-)
unnamed: C17.1, R53.2
unnamed: C18.1, D6.1 (K), J16.1, R62.2, RV6.1, RV6.2
unnamed: D1.2 (A), R6.2
unnamed: D2.2 (A), R10.2, R12.1
unnamed: D3.1 (K), R17.2
unnamed: D3.2 (A), D4.2 (A), Q5.3 (C), R15.2, R18.2
unnamed: D4.1 (K), R25.1
unnamed: D5.1 (K), R45.1, R47.1
unnamed: D5.2 (A), D6.2 (A), R44.2
unnamed: D7.1 (K), D8.2 (A), J19.1, R56.1, RV8.3
unnamed: D9.1 (K), R60.1, R65.2, U3.12 (+)
unnamed: D9.2 (A), R59.2
unnamed: FB1.2, J10.9, J10.10
unnamed: FB2.2, J10.1, J10.2
unnamed: J3.1, R27.2, RV3.1
unnamed: J4.1, R35.1, RV5.1, U3.1
unnamed: J5.1, R39.2, RV5.3
unnamed: J6.1, R42.1, R43.1, RV5.2
unnamed: J7.1, R46.2, RV7.1, RV7.2, U3.7
unnamed: J8.1, R51.1, RV7.3
unnamed: J9.1, R67.2
unnamed: J11.1, JP1.1, R21.1
unnamed: J12.1, JP1.2, R61.1, U1.7
unnamed: J14.1, R29.1, R32.1, R40.2, RV4.3
unnamed: J15.1, Q9.3 (C), R36.1, RV4.1, RV4.2
unnamed: J17.1, R48.2, RV8.1, RV8.2
unnamed: J18.1, R50.1, RV6.3
unnamed: J20.1, Q9.1 (E), Q13.1 (E), RV9.1, RV9.2, U4.6 (-)
unnamed: J21.1, R64.2, RV10.2
unnamed: J24.1, R67.1, RV9.3, U4.7
unnamed: Q1.1 (E), Q2.1 (E), R3.1, R4.2, R9.2, U1.1
unnamed: Q1.2 (B), R4.1, R6.1
unnamed: Q1.3 (C), R5.2
unnamed: Q2.2 (B), R9.1, R13.1
unnamed: Q2.3 (C), R44.1
unnamed: Q3.2 (B), R7.1, R8.2
unnamed: Q4.2 (B), R14.1, R16.2
unnamed: Q4.3 (C), R13.2
unnamed: Q5.2 (B), R11.1, R12.2
unnamed: Q6.2 (B), R18.1, R19.1
unnamed: Q7.2 (B), R20.2, R24.1
unnamed: Q7.3 (C), R55.1, R59.1
unnamed: Q9.2 (B), R38.1, R41.2
unnamed: Q10.2 (B), R49.1, R66.1
unnamed: Q10.3 (C), R42.2, U3.5 (+)
unnamed: Q11.2 (B), R54.1
unnamed: Q12.2 (B), R55.2
unnamed: Q12.3 (C), R58.1
unnamed: Q13.2 (B), R62.1
unnamed: Q13.3 (C), R56.2, R57.1
unnamed: R1.2, R3.2, U1.2 (-)
unnamed: R7.2, U2.4
unnamed: R30.1, R35.2, U3.2 (-)
unnamed: R33.2, U3.3 (+)
unnamed: R43.2, R46.1, U3.6 (-)
unnamed: R53.1, R63.2, U4.2 (-)
unnamed: R61.2, R64.1, U1.6 (-)
unnamed: R63.1, RV10.3, U4.1
unnamed: R65.1, R66.2, U3.14
unnamed: U2.2, U2.3

Notes on the sheet:
Tune Decay
Tune Depth
Pitch
Distortion
Out Level
Compression
Attack
Decay
Noise Level
Velocity
Trigger
Must be connected to +12v if no signal in
NOT ON HAND PDF
Controls
Attack
Decay
Distortion
Level
Tune Decay
Noise Level
Jacks
Output
SHOULD

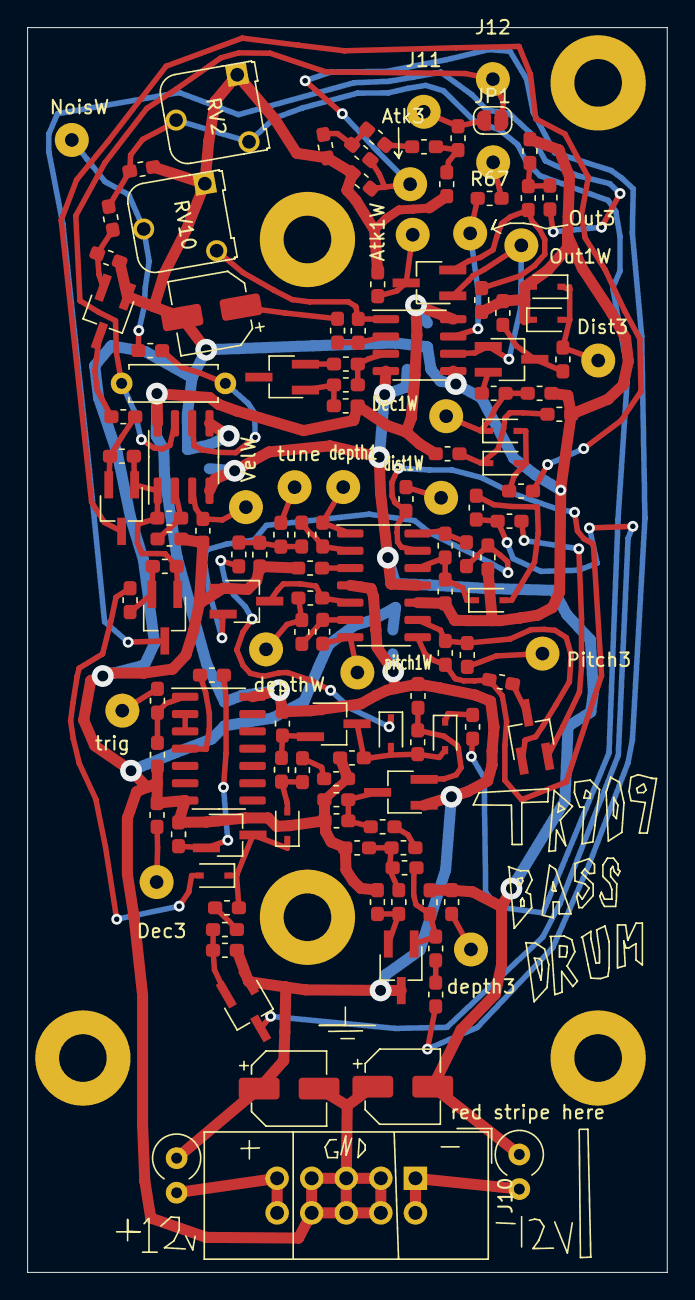
[picture p14: board BassDrum_TR909.kicad_pcb from above]

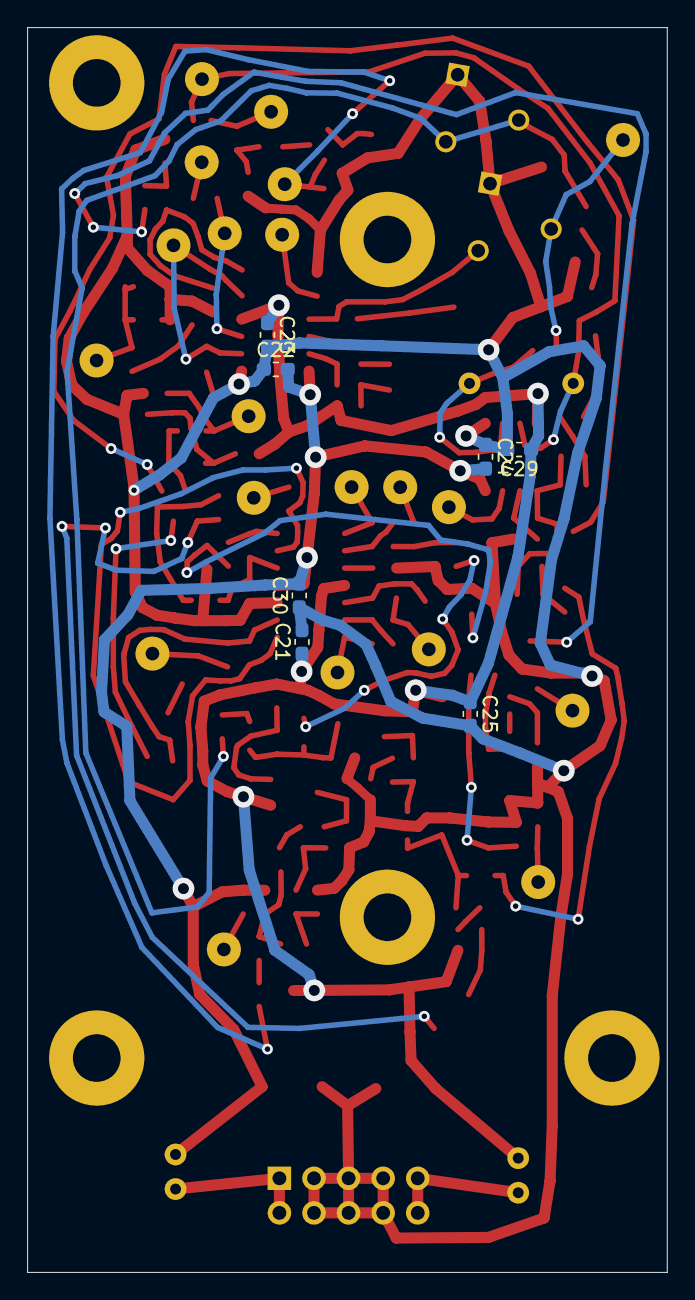
[picture p15: board BassDrum_TR909.kicad_pcb from below]

Board: 2 copper layers, 47.0 x 91.4 mm, 146 parts (7 on the bottom side), 85 nets.
