masonandrewmann/drum_machine/harware_design/Triple Waveshaper - CGS/Triple Waveshaper - CGS.kicad_pcb

## KiCad design harware_design/Triple Waveshaper - CGS/Triple Waveshaper - CGS.kicad_pcb (2023-02-01)

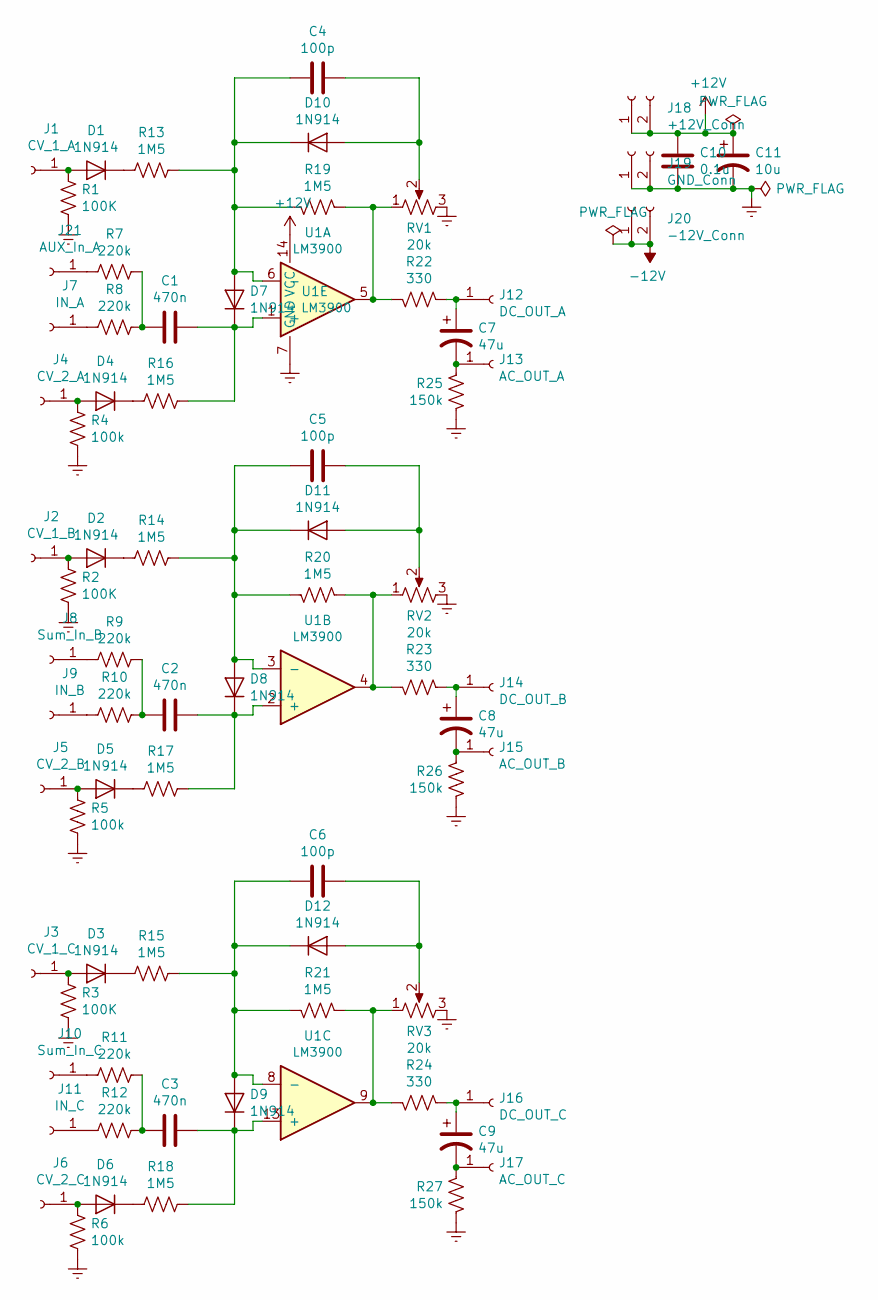
[picture p16: schematic Triple Waveshaper - CGS.sch]

Parts:
C1, C2, C3: 470n; C_Rect_L7.0mm_W2.5mm_P5.00mm
C4, C5, C6: 100p; C_Rect_L7.0mm_W2.5mm_P5.00mm
C7, C8, C9: 47u; CP_Radial_D4.0mm_P2.00mm
C10: 0.1u; C_Rect_L7.0mm_W2.5mm_P5.00mm
C11: 10u; CP_Radial_D4.0mm_P2.00mm
D1, D2, D3, D4, D5, D6, D7, D8, D9, D10, D11, D12: 1N914; D_T-1_P5.08mm_Horizontal
J1: CV_1_A; SolderWirePad_1x01_Drill1mm
J2: CV_1_B; SolderWirePad_1x01_Drill1mm
J3: CV_1_C; SolderWirePad_1x01_Drill1mm
J4: CV_2_A; SolderWirePad_1x01_Drill1mm
J5: CV_2_B; SolderWirePad_1x01_Drill1mm
J6: CV_2_C; SolderWirePad_1x01_Drill1mm
J7: IN_A; SolderWirePad_1x01_Drill1mm
J8: Sum_In_B; SolderWirePad_1x01_Drill1mm
J9: IN_B; SolderWirePad_1x01_Drill1mm
J10: Sum_In_C; SolderWirePad_1x01_Drill1mm
J11: IN_C; SolderWirePad_1x01_Drill1mm
J12: DC_OUT_A; SolderWirePad_1x01_Drill1mm
J13: AC_OUT_A; SolderWirePad_1x01_Drill1mm
J14: DC_OUT_B; SolderWirePad_1x01_Drill1mm
J15: AC_OUT_B; SolderWirePad_1x01_Drill1mm
J16: DC_OUT_C; SolderWirePad_1x01_Drill1mm
J17: AC_OUT_C; SolderWirePad_1x01_Drill1mm
J18: +12V_Conn; SolderWirePad_1x02_P3.81mm_Drill1mm
J19: GND_Conn; SolderWirePad_1x02_P3.81mm_Drill1mm
J20: -12V_Conn; SolderWirePad_1x02_P3.81mm_Drill1mm
J21: AUX_In_A; SolderWirePad_1x01_Drill1mm
R1, R2, R3: 100K; R_Axial_DIN0207_L6.3mm_D2.5mm_P7.62mm_Horizontal
R4, R5, R6: 100k; R_Axial_DIN0207_L6.3mm_D2.5mm_P7.62mm_Horizontal
R7, R8, R9, R10, R11, R12: 220k; R_Axial_DIN0207_L6.3mm_D2.5mm_P7.62mm_Horizontal
R13, R14, R15, R16, R17, R18, R19, R20, R21: 1M5; R_Axial_DIN0207_L6.3mm_D2.5mm_P7.62mm_Horizontal
R22, R23, R24: 330; R_Axial_DIN0207_L6.3mm_D2.5mm_P7.62mm_Horizontal
R25, R26, R27: 150k; R_Axial_DIN0207_L6.3mm_D2.5mm_P7.62mm_Horizontal
RV1, RV2, RV3: 20k; Potentiometer_Runtron_RM-065_Vertical
U1: LM3900; DIP-14_W7.62mm_Socket

Connections:
+12V: C10.1, C11.1, J18.1, J18.2, U1.14 (VCC)
-12V: J20.1, J20.2
Earth: C10.2, C11.2, J19.1, J19.2, R1.1, R2.1, R3.1, R4.1, R5.1, R6.1, R25.1, R26.1, R27.1, RV1.3, RV2.3, RV3.3, U1.7 (GND)
unnamed: C1.1, R7.1, R8.1
unnamed: C1.2, D7.1 (K), R16.1, U1.1 (+)
unnamed: C2.1, R9.1, R10.1
unnamed: C2.2, D8.1 (K), R17.1, U1.2 (+)
unnamed: C3.1, R11.1, R12.1
unnamed: C3.2, D9.1 (K), R18.1, U1.13 (+)
unnamed: C4.1, D7.2 (A), D10.1 (K), R13.1, R19.2, U1.6 (-)
unnamed: C4.2, D10.2 (A), RV1.2
unnamed: C5.1, D8.2 (A), D11.1 (K), R14.1, R20.2, U1.3 (-)
unnamed: C5.2, D11.2 (A), RV2.2
unnamed: C6.1, D9.2 (A), D12.1 (K), R15.1, R21.2, U1.8 (-)
unnamed: C6.2, D12.2 (A), RV3.2
unnamed: C7.1, J12.1, R22.1
unnamed: C7.2, J13.1, R25.2
unnamed: C8.1, J14.1, R23.1
unnamed: C8.2, J15.1, R26.2
unnamed: C9.1, J16.1, R24.1
unnamed: C9.2, J17.1, R27.2
unnamed: D1.1 (K), R13.2
unnamed: D1.2 (A), J1.1, R1.2
unnamed: D2.1 (K), R14.2
unnamed: D2.2 (A), J2.1, R2.2
unnamed: D3.1 (K), R15.2
unnamed: D3.2 (A), J3.1, R3.2
unnamed: D4.1 (K), R16.2
unnamed: D4.2 (A), J4.1, R4.2
unnamed: D5.1 (K), R17.2
unnamed: D5.2 (A), J5.1, R5.2
unnamed: D6.1 (K), R18.2
unnamed: D6.2 (A), J6.1, R6.2
unnamed: J7.1, R8.2
unnamed: J8.1, R9.2
unnamed: J9.1, R10.2
unnamed: J10.1, R11.2
unnamed: J11.1, R12.2
unnamed: J21.1, R7.2
unnamed: R19.1, R22.2, RV1.1, U1.5
unnamed: R20.1, R23.2, RV2.1, U1.4
unnamed: R21.1, R24.2, RV3.1, U1.9
