masonandrewmann/drum_machine/harware_design/Triple Waveshaper - CGS/Triple Waveshaper - CGS.kicad_pcb

## KiCad design harware_design/Triple Waveshaper - CGS/Triple Waveshaper - CGS.kicad_pcb (continued)

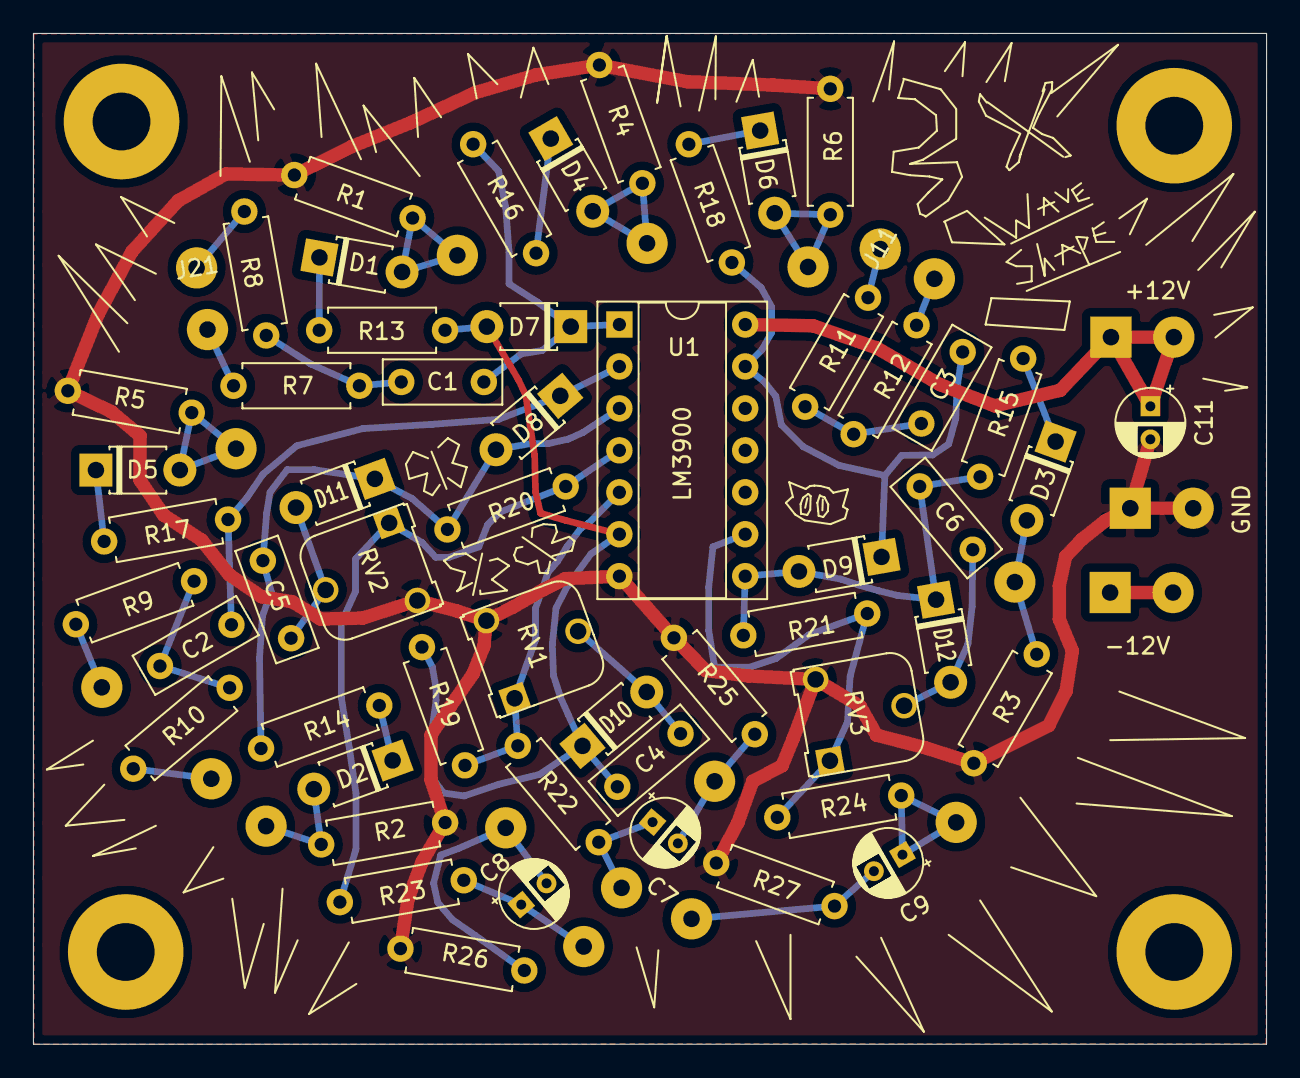
[picture p17: board Triple Waveshaper - CGS.kicad_pcb from above]

Board: 2 copper layers, 74.7 x 61.2 mm, 74 parts (0 on the bottom side), 42 nets.
