masonandrewmann/drum_machine/harware_design/DrumMachineControlBoard/DrumMachineControlBoard.kicad_pcb

## KiCad design harware_design/DrumMachineControlBoard/DrumMachineControlBoard.kicad_pcb (2023-01-25)

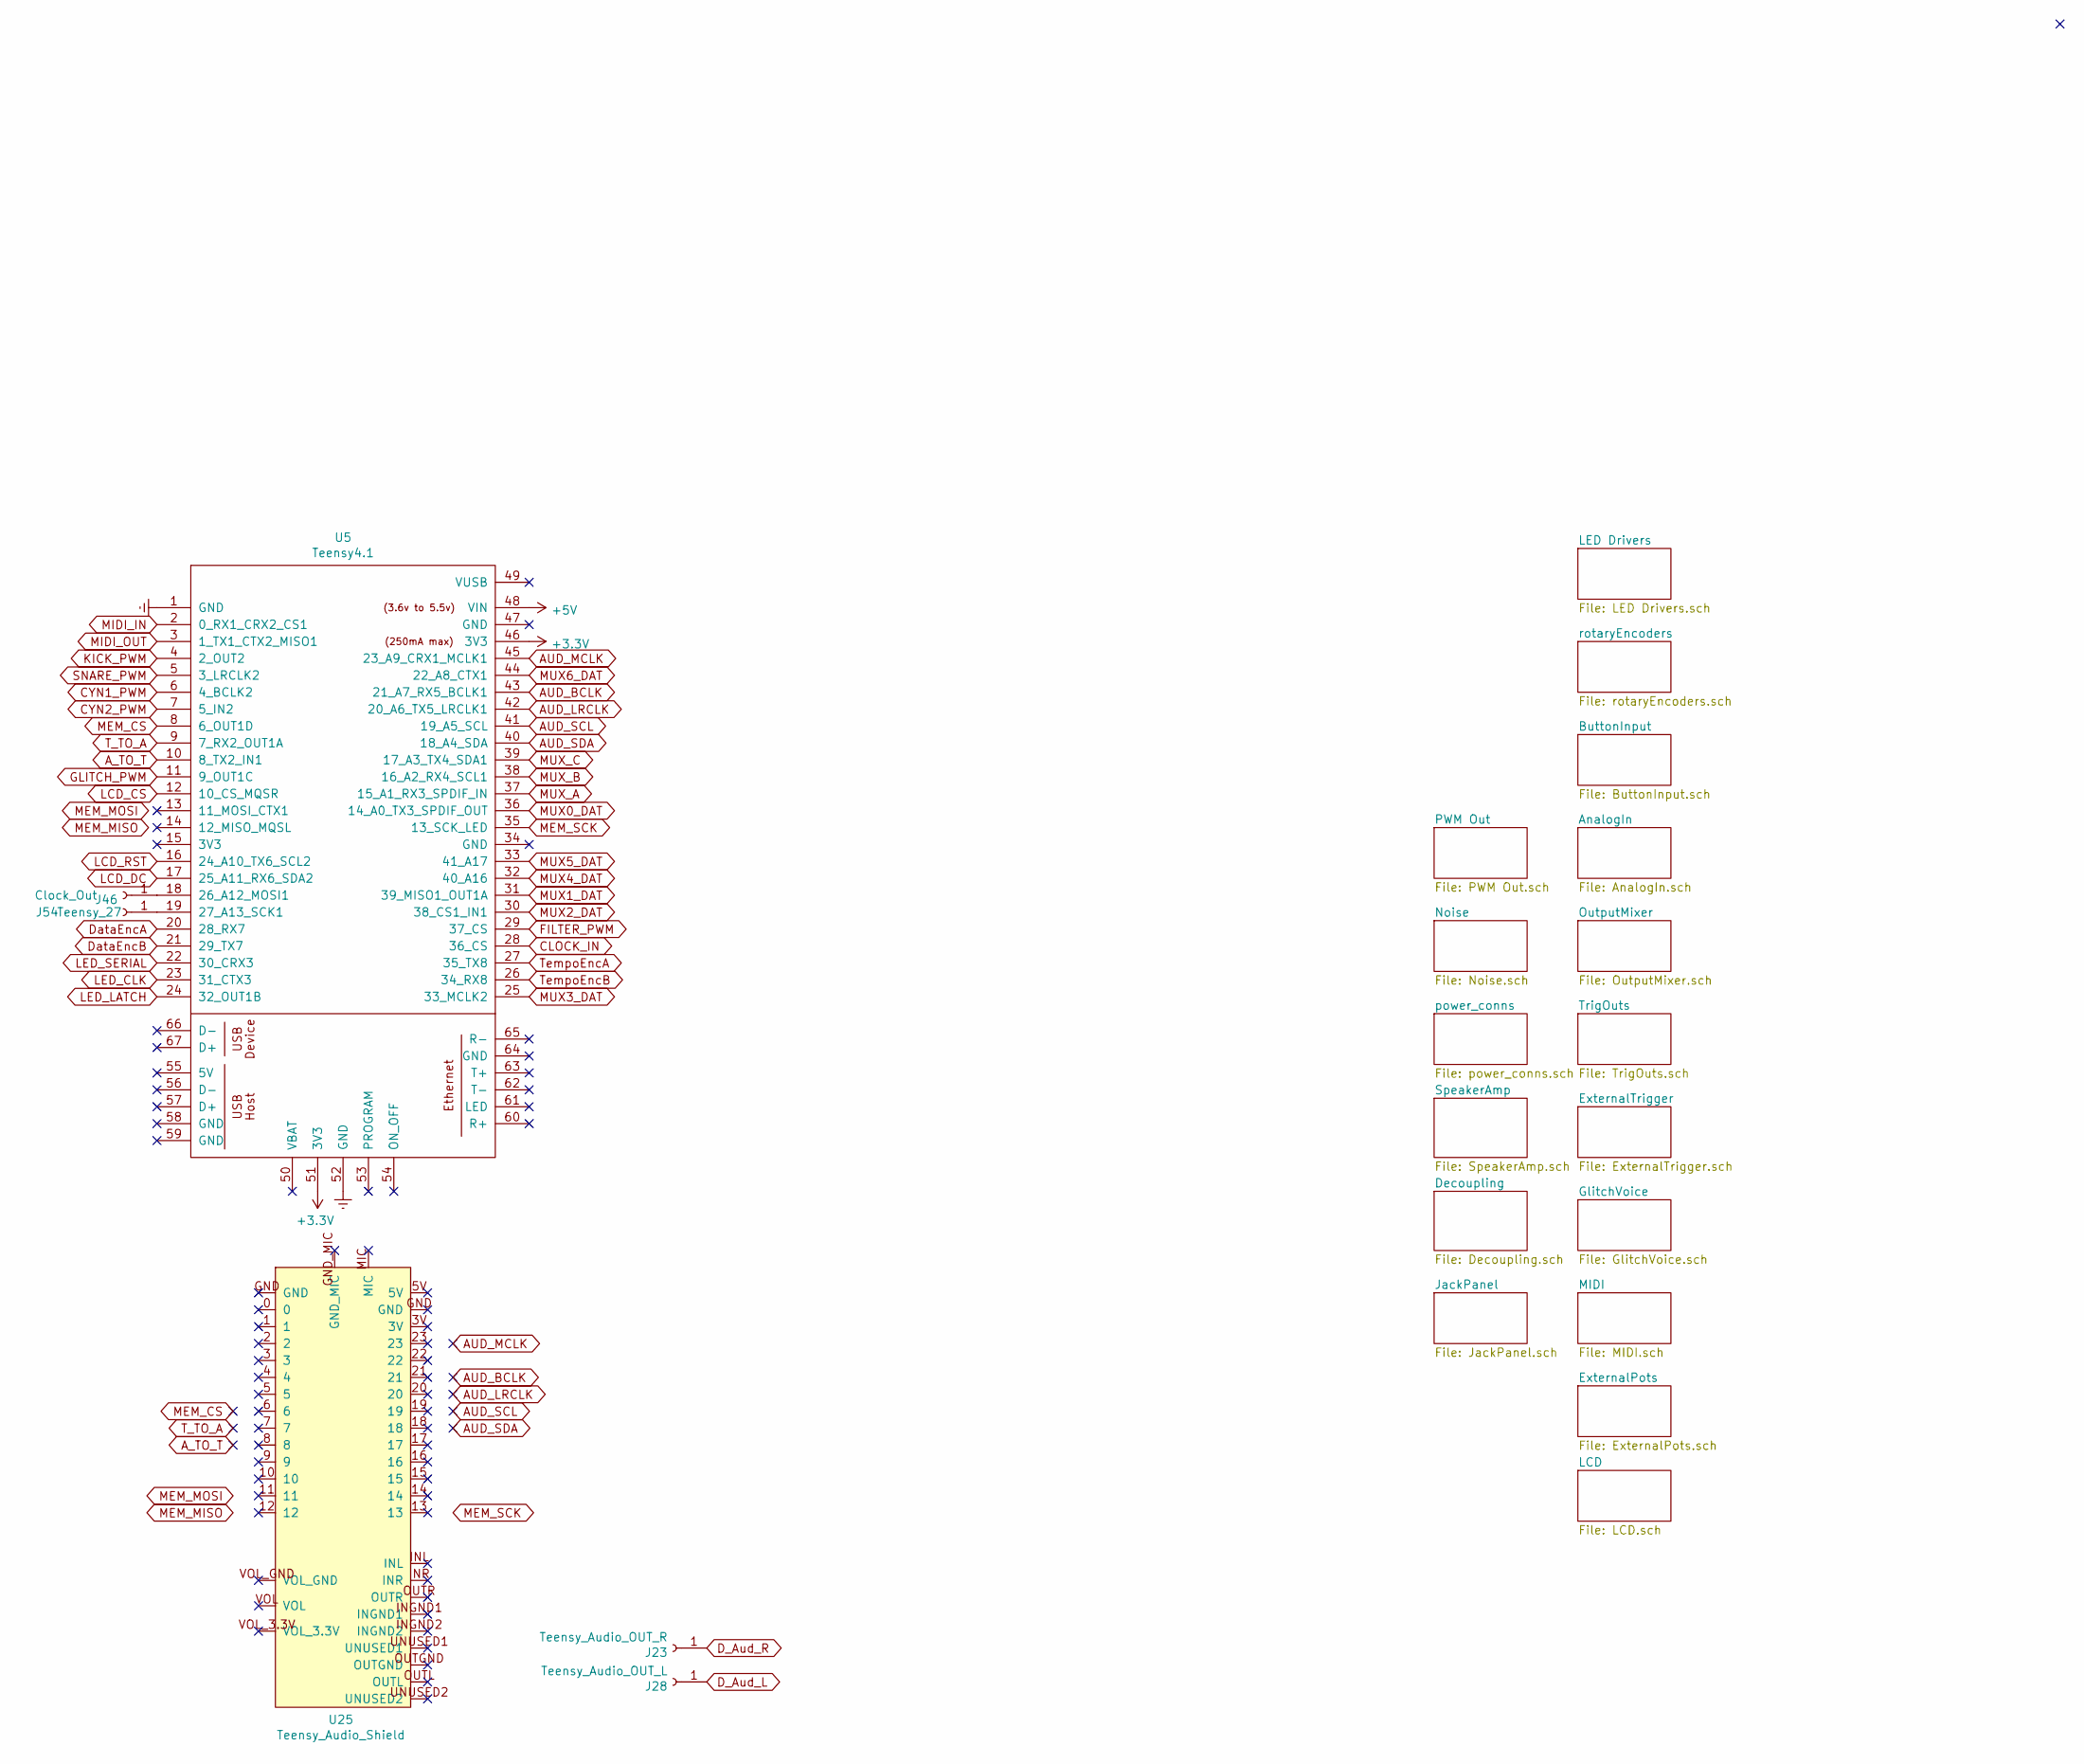
[picture p18: schematic DrumMachineControlBoard.sch]

Parts:
J23: Teensy_Audio_OUT_R; SolderWirePad_1x01_Drill1mm
J28: Teensy_Audio_OUT_L; SolderWirePad_1x01_Drill1mm
J46: Clock_Out; SolderWirePad_1x01_Drill1mm
J54: Teensy_27; SolderWirePad_1x01_Drill1mm
U5: Teensy4.1; Teensy41
U25: Teensy_Audio_Shield

Connections:
+3V3: U5.46 (3V3), U5.51 (3V3); also elsewhere on the board
+5V: U5.48 (VIN); also elsewhere on the board
AUD_BCLK: U5.43 (21_A7_RX5_BCLK1)
AUD_LRCLK: U5.42 (20_A6_TX5_LRCLK1)
AUD_MCLK: U5.45 (23_A9_CRX1_MCLK1)
AUD_SCL: U5.41 (19_A5_SCL)
AUD_SDA: U5.40 (18_A4_SDA)
A_TO_T: U5.10 (8_TX2_IN1)
CLOCK_IN: U5.28 (36_CS); also elsewhere on the board
CYN1_PWM: U5.6 (4_BCLK2); also elsewhere on the board
CYN2_PWM: U5.7 (5_IN2); also elsewhere on the board
D_Aud_L: J28.1; also elsewhere on the board
D_Aud_R: J23.1; also elsewhere on the board
DataEncA: U5.20 (28_RX7); also elsewhere on the board
DataEncB: U5.21 (29_TX7); also elsewhere on the board
Earth: U5.1 (GND), U5.52 (GND); also elsewhere on the board
FILTER_PWM: U5.29 (37_CS); also elsewhere on the board
GLITCH_PWM: U5.11 (9_OUT1C); also elsewhere on the board
KICK_PWM: U5.4 (2_OUT2); also elsewhere on the board
LCD_CS: U5.12 (10_CS_MQSR); also elsewhere on the board
LCD_DC: U5.17 (25_A11_RX6_SDA2); also elsewhere on the board
LCD_RST: U5.16 (24_A10_TX6_SCL2); also elsewhere on the board
LED_CLK: U5.23 (31_CTX3); also elsewhere on the board
LED_LATCH: U5.24 (32_OUT1B); also elsewhere on the board
LED_SERIAL: U5.22 (30_CRX3); also elsewhere on the board
MEM_CS: U5.8 (6_OUT1D)
MEM_SCK: U5.35 (13_SCK_LED); also elsewhere on the board
MIDI_IN: U5.2 (0_RX1_CRX2_CS1); also elsewhere on the board
MIDI_OUT: U5.3 (1_TX1_CTX2_MISO1); also elsewhere on the board
MUX0_DAT: U5.36 (14_A0_TX3_SPDIF_OUT); also elsewhere on the board
MUX1_DAT: U5.31 (39_MISO1_OUT1A); also elsewhere on the board
MUX2_DAT: U5.30 (38_CS1_IN1); also elsewhere on the board
MUX3_DAT: U5.25 (33_MCLK2); also elsewhere on the board
MUX4_DAT: U5.32 (40_A16); also elsewhere on the board
MUX5_DAT: U5.33 (41_A17); also elsewhere on the board
MUX6_DAT: U5.44 (22_A8_CTX1); also elsewhere on the board
MUX_A: U5.37 (15_A1_RX3_SPDIF_IN); also elsewhere on the board
MUX_B: U5.38 (16_A2_RX4_SCL1); also elsewhere on the board
MUX_C: U5.39 (17_A3_TX4_SDA1); also elsewhere on the board
unnamed: J46.1, U5.18 (26_A12_MOSI1)
unnamed: J54.1, U5.19 (27_A13_SCK1)
SNARE_PWM: U5.5 (3_LRCLK2); also elsewhere on the board
T_TO_A: U5.9 (7_RX2_OUT1A)
TempoEncA: U5.27 (35_TX8); also elsewhere on the board
TempoEncB: U5.26 (34_RX8); also elsewhere on the board

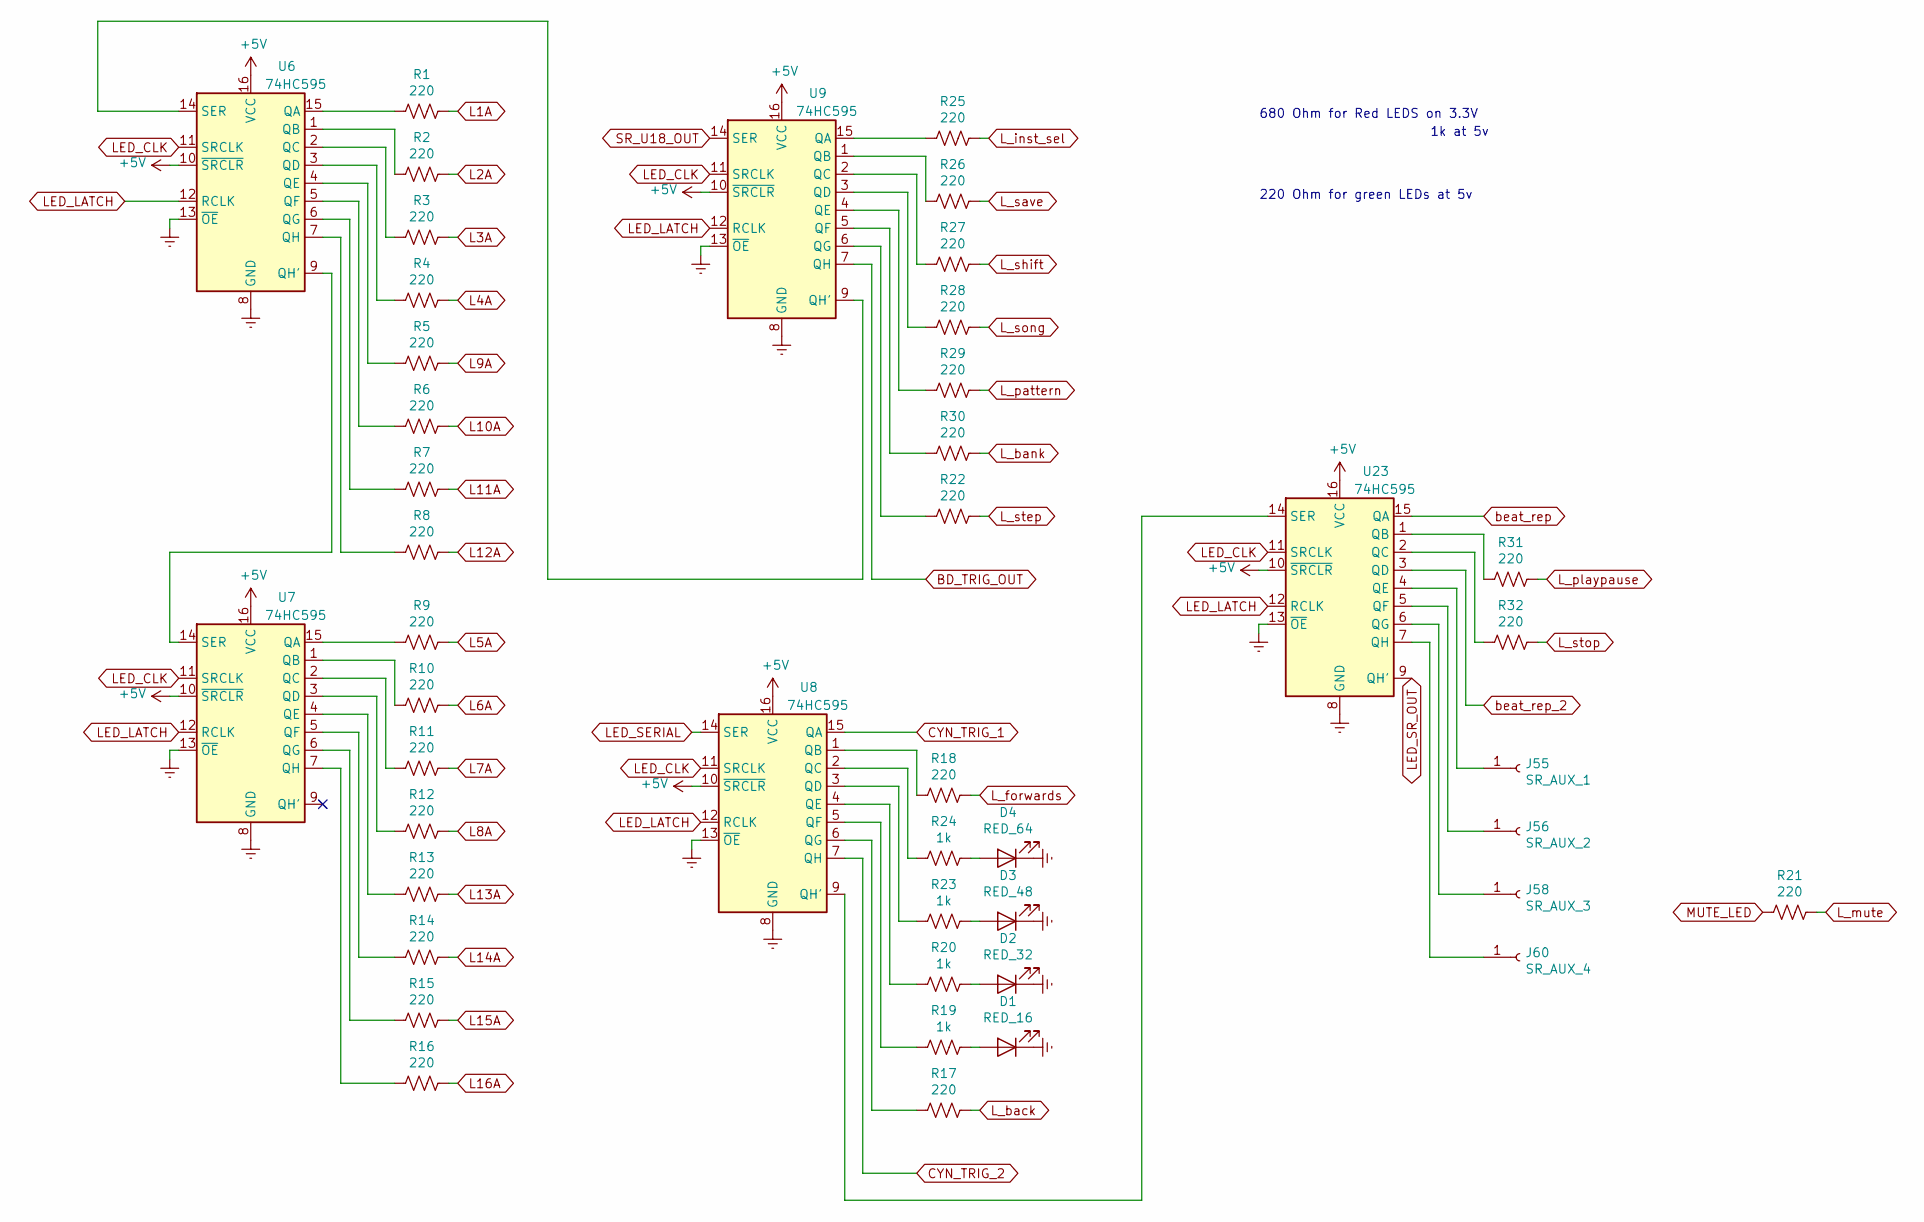
[picture p19: schematic LED Drivers.sch]

Parts:
D1: RED_16; LED_D3.0mm
D2: RED_32; LED_D3.0mm
D3: RED_48; LED_D3.0mm
D4: RED_64; LED_D3.0mm
J55: SR_AUX_1; SolderWirePad_1x01_Drill1mm
J56: SR_AUX_2; SolderWirePad_1x01_Drill1mm
J58: SR_AUX_3; SolderWirePad_1x01_Drill1mm
J60: SR_AUX_4; SolderWirePad_1x01_Drill1mm
R1, R2, R3, R4, R5, R6, R7, R8, R9, R10, R11, R12, R13, R14, R15, R16, R17, R18, R21, R22, R25, R26, R27, R28, R29, R30, R31, R32: 220; R_0603_1608Metric_Pad1.05x0.95mm_HandSolder
R19, R20, R23, R24: 1k; R_0603_1608Metric_Pad1.05x0.95mm_HandSolder
U6, U7, U8, U9, U23: 74HC595; SOIC-16_3.9x9.9mm_P1.27mm

Connections:
+5V: U6.10 (~SRCLR), U6.16 (VCC), U7.10 (~SRCLR), U7.16 (VCC), U8.10 (~SRCLR), U8.16 (VCC), U9.10 (~SRCLR), U9.16 (VCC), U23.10 (~SRCLR), U23.16 (VCC); also elsewhere on the board
BD_TRIG_OUT: U9.7 (QH); also elsewhere on the board
CYN_TRIG_1: U8.15 (QA); also elsewhere on the board
CYN_TRIG_2: U8.7 (QH); also elsewhere on the board
Earth: D1.1 (K), D2.1 (K), D3.1 (K), D4.1 (K), U6.8 (GND), U6.13 (~OE), U7.8 (GND), U7.13 (~OE), U8.8 (GND), U8.13 (~OE), U9.8 (GND), U9.13 (~OE), U23.8 (GND), U23.13 (~OE); also elsewhere on the board
L1A: R1.1; also elsewhere on the board
L2A: R2.1; also elsewhere on the board
L3A: R3.1; also elsewhere on the board
L4A: R4.1; also elsewhere on the board
L5A: R9.1; also elsewhere on the board
L6A: R10.1; also elsewhere on the board
L7A: R11.1; also elsewhere on the board
L8A: R12.1; also elsewhere on the board
L9A: R5.1; also elsewhere on the board
L10A: R6.1; also elsewhere on the board
L11A: R7.1; also elsewhere on the board
L12A: R8.1; also elsewhere on the board
L13A: R13.1; also elsewhere on the board
L14A: R14.1; also elsewhere on the board
L15A: R15.1; also elsewhere on the board
L16A: R16.1; also elsewhere on the board
LED_CLK: U6.11 (SRCLK), U7.11 (SRCLK), U8.11 (SRCLK), U9.11 (SRCLK), U23.11 (SRCLK); also elsewhere on the board
LED_LATCH: U6.12 (RCLK), U7.12 (RCLK), U8.12 (RCLK), U9.12 (RCLK), U23.12 (RCLK); also elsewhere on the board
LED_SERIAL: U8.14 (SER); also elsewhere on the board
LED_SR_OUT: U23.9 (QH'); also elsewhere on the board
L_back: R17.1; also elsewhere on the board
L_bank: R30.1; also elsewhere on the board
L_forwards: R18.1; also elsewhere on the board
L_inst_sel: R25.1; also elsewhere on the board
L_mute: R21.1; also elsewhere on the board
L_pattern: R29.1; also elsewhere on the board
L_playpause: R31.1; also elsewhere on the board
L_save: R26.1; also elsewhere on the board
L_shift: R27.1; also elsewhere on the board
L_song: R28.1; also elsewhere on the board
L_step: R22.1; also elsewhere on the board
L_stop: R32.1; also elsewhere on the board
MUTE_LED: R21.2; also elsewhere on the board
unnamed: D1.2 (A), R19.1
unnamed: D2.2 (A), R20.1
unnamed: D3.2 (A), R23.1
unnamed: D4.2 (A), R24.1
unnamed: J55.1, U23.4 (QE)
unnamed: J56.1, U23.5 (QF)
unnamed: J58.1, U23.6 (QG)
unnamed: J60.1, U23.7 (QH)
unnamed: R1.2, U6.15 (QA)
unnamed: R2.2, U6.1 (QB)
unnamed: R3.2, U6.2 (QC)
unnamed: R4.2, U6.3 (QD)
unnamed: R5.2, U6.4 (QE)
unnamed: R6.2, U6.5 (QF)
unnamed: R7.2, U6.6 (QG)
unnamed: R8.2, U6.7 (QH)
unnamed: R9.2, U7.15 (QA)
unnamed: R10.2, U7.1 (QB)
unnamed: R11.2, U7.2 (QC)
unnamed: R12.2, U7.3 (QD)
unnamed: R13.2, U7.4 (QE)
unnamed: R14.2, U7.5 (QF)
unnamed: R15.2, U7.6 (QG)
unnamed: R16.2, U7.7 (QH)
unnamed: R17.2, U8.6 (QG)
unnamed: R18.2, U8.1 (QB)
unnamed: R19.2, U8.5 (QF)
unnamed: R20.2, U8.4 (QE)
unnamed: R22.2, U9.6 (QG)
unnamed: R23.2, U8.3 (QD)
unnamed: R24.2, U8.2 (QC)
unnamed: R25.2, U9.15 (QA)
unnamed: R26.2, U9.1 (QB)
unnamed: R27.2, U9.2 (QC)
unnamed: R28.2, U9.3 (QD)
unnamed: R29.2, U9.4 (QE)
unnamed: R30.2, U9.5 (QF)
unnamed: R31.2, U23.1 (QB)
unnamed: R32.2, U23.2 (QC)
unnamed: U6.9 (QH'), U7.14 (SER)
unnamed: U6.14 (SER), U9.9 (QH')
unnamed: U8.9 (QH'), U23.14 (SER)
SR_U18_OUT: U9.14 (SER); also elsewhere on the board
beat_rep: U23.15 (QA); also elsewhere on the board
beat_rep_2: U23.3 (QD); also elsewhere on the board

Notes on the sheet:
680 Ohm for Red LEDS on 3.3V
1k at 5v
220 Ohm for green LEDs at 5v

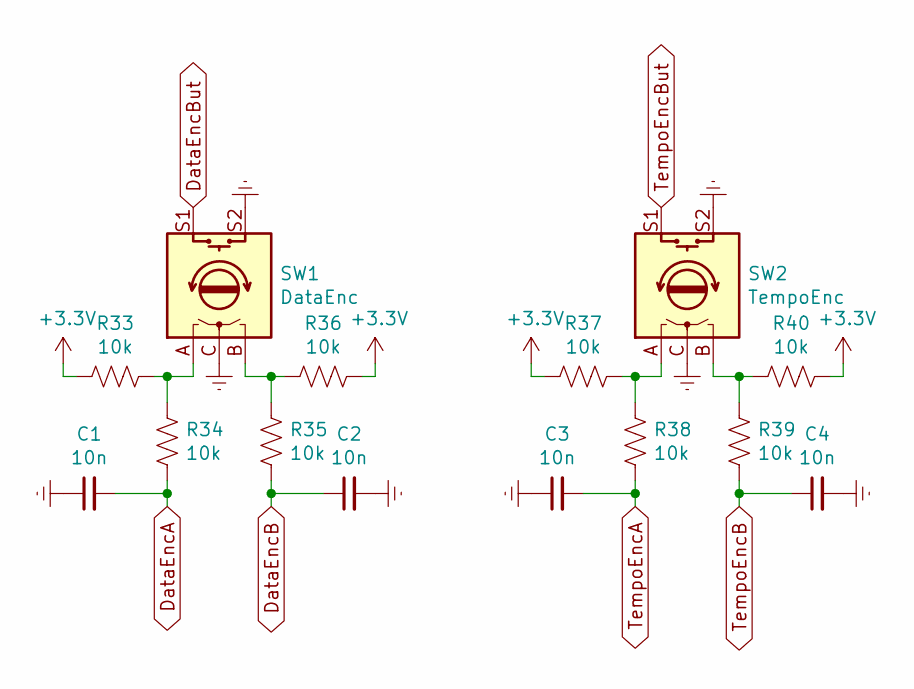
[picture p20: schematic rotaryEncoders.sch]

Parts:
C1, C2, C3, C4: 10n; C_0603_1608Metric_Pad1.05x0.95mm_HandSolder
R33, R34, R35, R36, R37, R38, R39, R40: 10k; R_0603_1608Metric_Pad1.05x0.95mm_HandSolder
SW1: DataEnc; RotaryEncoder_Alps_EC11E-Switch_Vertical_H20mm
SW2: TempoEnc; RotaryEncoder_Alps_EC11E-Switch_Vertical_H20mm

Connections:
+3V3: R33.2, R36.1, R37.2, R40.1; also elsewhere on the board
DataEncA: C1.2, R34.1; also elsewhere on the board
DataEncB: C2.1, R35.1; also elsewhere on the board
DataEncBut: SW1.S1; also elsewhere on the board
Earth: C1.1, C2.2, C3.1, C4.2, SW1.C, SW1.S2, SW2.C, SW2.S2; also elsewhere on the board
unnamed: R33.1, R34.2, SW1.A
unnamed: R35.2, R36.2, SW1.B
unnamed: R37.1, R38.2, SW2.A
unnamed: R39.2, R40.2, SW2.B
TempoEncA: C3.2, R38.1; also elsewhere on the board
TempoEncB: C4.1, R39.1; also elsewhere on the board
TempoEncBut: SW2.S1; also elsewhere on the board

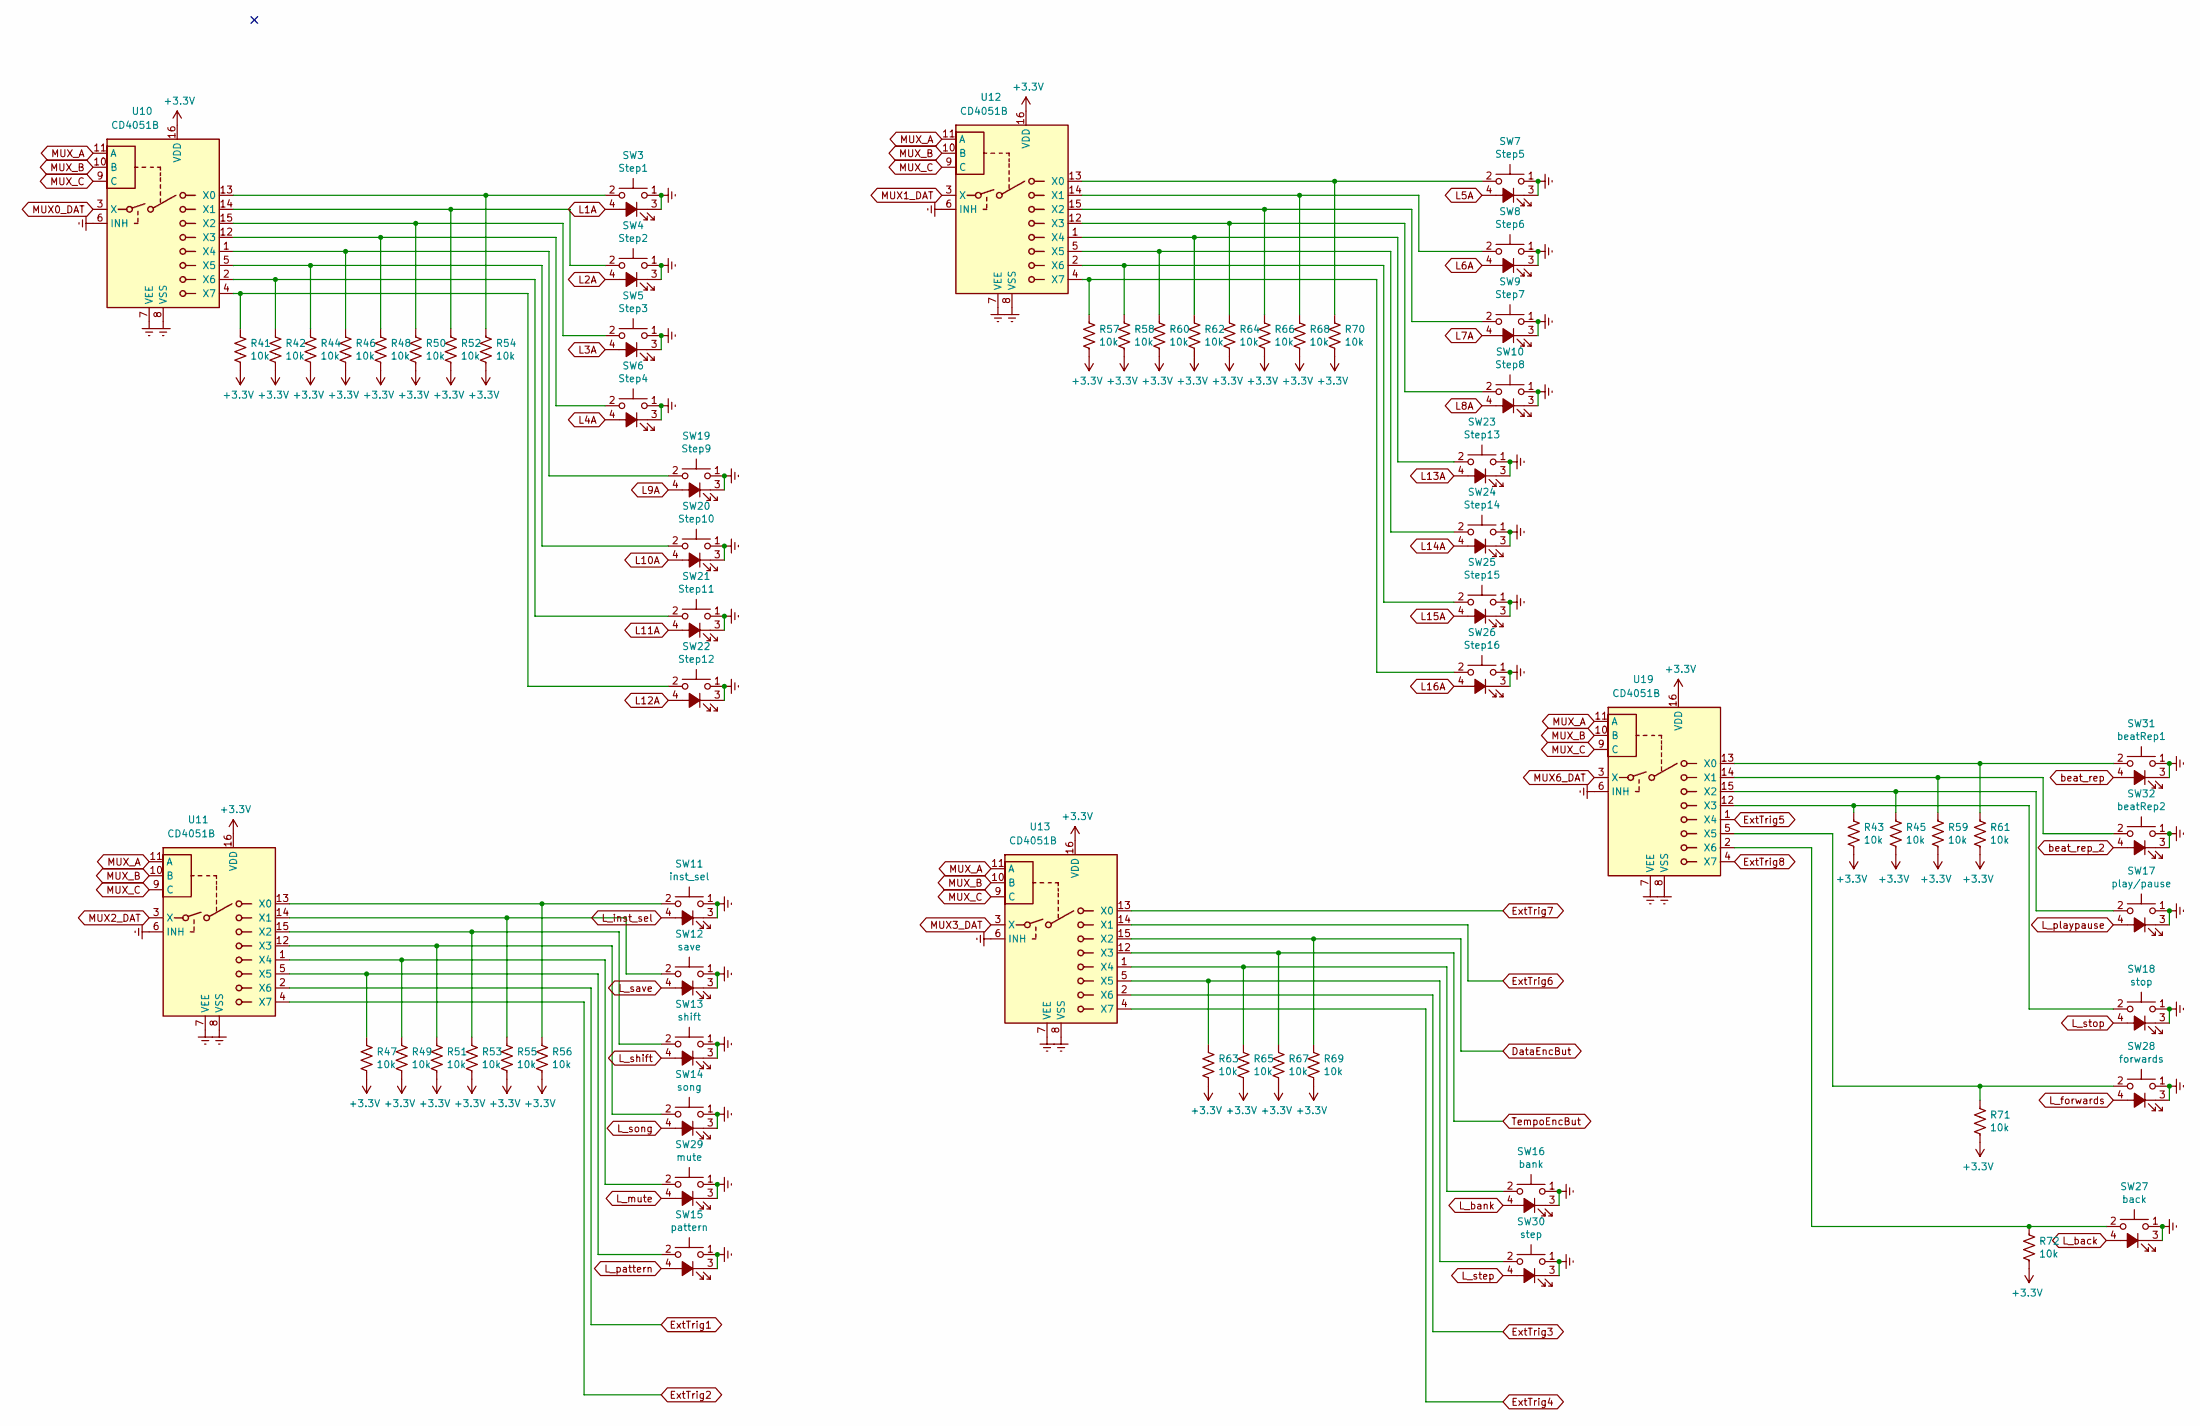
[picture p21: schematic ButtonInput.sch]

Parts:
R41, R42, R43, R44, R45, R46, R47, R48, R49, R50, R51, R52, R53, R54, R55, R56, R57, R58, R59, R60, R61, R62, R63, R64, R65, R66, R67, R68, R69, R70, R71, R72: 10k; R_0603_1608Metric_Pad1.05x0.95mm_HandSolder
SW3: Step1; CFPB-1CC-5G9
SW4: Step2; CFPB-1CC-5G9
SW5: Step3; CFPB-1CC-5G9
SW6: Step4; CFPB-1CC-5G9
SW7: Step5; CFPB-1CC-5G9
SW8: Step6; CFPB-1CC-5G9
SW9: Step7; CFPB-1CC-5G9
SW10: Step8; CFPB-1CC-5G9
SW11: inst_sel; CFPB-1CC-5G9
SW12: save; CFPB-1CC-5G9
SW13: shift; CFPB-1CC-5G9
SW14: song; CFPB-1CC-5G9
SW15: pattern; CFPB-1CC-5G9
SW16: bank; CFPB-1CC-5G9
SW17: play/pause; CFPB-1CC-5G9
SW18: stop; CFPB-1CC-5G9
SW19: Step9; CFPB-1CC-5G9
SW20: Step10; CFPB-1CC-5G9
SW21: Step11; CFPB-1CC-5G9
SW22: Step12; CFPB-1CC-5G9
SW23: Step13; CFPB-1CC-5G9
SW24: Step14; CFPB-1CC-5G9
SW25: Step15; CFPB-1CC-5G9
SW26: Step16; CFPB-1CC-5G9
SW27: back; CFPB-1CC-5G9
SW28: forwards; CFPB-1CC-5G9
SW29: mute; CFPB-1CC-5G9
SW30: step; CFPB-1CC-5G9
SW31: beatRep1; CFPB-1CC-5G9
SW32: beatRep2; CFPB-1CC-5G9
U10, U11, U12, U13, U19: CD4051B; SOIC-16_3.9x9.9mm_P1.27mm

Connections:
+3V3: R41.1, R42.1, R43.1, R44.1, R45.1, R46.1, R47.1, R48.1, R49.1, R50.1, R51.1, R52.1, R53.1, R54.1, R55.1, R56.1, R57.1, R58.1, R59.1, R60.1, R61.1, R62.1, R63.1, R64.1, R65.1, R66.1, R67.1, R68.1, R69.1, R70.1, R71.1, R72.1, U10.16 (VDD), U11.16 (VDD), U12.16 (VDD), U13.16 (VDD), U19.16 (VDD); also elsewhere on the board
DataEncBut: R69.2, U13.15 (X2); also elsewhere on the board
Earth: SW3.1, SW3.3 (K), SW4.1, SW4.3 (K), SW5.1, SW5.3 (K), SW6.1, SW6.3 (K), SW7.1, SW7.3 (K), SW8.1, SW8.3 (K), SW9.1, SW9.3 (K), SW10.1, SW10.3 (K), SW11.1, SW11.3 (K), SW12.1, SW12.3 (K), SW13.1, SW13.3 (K), SW14.1, SW14.3 (K), SW15.1, SW15.3 (K), SW16.1, SW16.3 (K), SW17.1, SW17.3 (K), SW18.1, SW18.3 (K), SW19.1, SW19.3 (K), SW20.1, SW20.3 (K), SW21.1, SW21.3 (K), SW22.1, SW22.3 (K), SW23.1, SW23.3 (K), SW24.1, SW24.3 (K), SW25.1, SW25.3 (K), SW26.1, SW26.3 (K), SW27.1, SW27.3 (K), SW28.1, SW28.3 (K), SW29.1, SW29.3 (K), SW30.1, SW30.3 (K), SW31.1, SW31.3 (K), SW32.1, SW32.3 (K), U10.6 (INH), U10.7 (VEE), U10.8 (VSS), U11.6 (INH), U11.7 (VEE), U11.8 (VSS), U12.6 (INH), U12.7 (VEE), U12.8 (VSS), U13.6 (INH), U13.7 (VEE), U13.8 (VSS), U19.6 (INH), U19.7 (VEE), U19.8 (VSS); also elsewhere on the board
ExtTrig1: U11.2 (X6); also elsewhere on the board
ExtTrig2: U11.4 (X7); also elsewhere on the board
ExtTrig3: U13.2 (X6); also elsewhere on the board
ExtTrig4: U13.4 (X7); also elsewhere on the board
ExtTrig5: U19.1 (X4); also elsewhere on the board
ExtTrig6: U13.14 (X1); also elsewhere on the board
ExtTrig7: U13.13 (X0); also elsewhere on the board
ExtTrig8: U19.4 (X7); also elsewhere on the board
L1A: SW3.4 (A); also elsewhere on the board
L2A: SW4.4 (A); also elsewhere on the board
L3A: SW5.4 (A); also elsewhere on the board
L4A: SW6.4 (A); also elsewhere on the board
L5A: SW7.4 (A); also elsewhere on the board
L6A: SW8.4 (A); also elsewhere on the board
L7A: SW9.4 (A); also elsewhere on the board
L8A: SW10.4 (A); also elsewhere on the board
L9A: SW19.4 (A); also elsewhere on the board
L10A: SW20.4 (A); also elsewhere on the board
L11A: SW21.4 (A); also elsewhere on the board
L12A: SW22.4 (A); also elsewhere on the board
L13A: SW23.4 (A); also elsewhere on the board
L14A: SW24.4 (A); also elsewhere on the board
L15A: SW25.4 (A); also elsewhere on the board
L16A: SW26.4 (A); also elsewhere on the board
L_back: SW27.4 (A); also elsewhere on the board
L_bank: SW16.4 (A); also elsewhere on the board
L_forwards: SW28.4 (A); also elsewhere on the board
L_inst_sel: SW11.4 (A); also elsewhere on the board
L_mute: SW29.4 (A); also elsewhere on the board
L_pattern: SW15.4 (A); also elsewhere on the board
L_playpause: SW17.4 (A); also elsewhere on the board
L_save: SW12.4 (A); also elsewhere on the board
L_shift: SW13.4 (A); also elsewhere on the board
L_song: SW14.4 (A); also elsewhere on the board
L_step: SW30.4 (A); also elsewhere on the board
L_stop: SW18.4 (A); also elsewhere on the board
MUX0_DAT: U10.3 (X); also elsewhere on the board
MUX1_DAT: U12.3 (X); also elsewhere on the board
MUX2_DAT: U11.3 (X); also elsewhere on the board
MUX3_DAT: U13.3 (X); also elsewhere on the board
MUX6_DAT: U19.3 (X); also elsewhere on the board
MUX_A: U10.11 (A), U11.11 (A), U12.11 (A), U13.11 (A), U19.11 (A); also elsewhere on the board
MUX_B: U10.10 (B), U11.10 (B), U12.10 (B), U13.10 (B), U19.10 (B); also elsewhere on the board
MUX_C: U10.9 (C), U11.9 (C), U12.9 (C), U13.9 (C), U19.9 (C); also elsewhere on the board
unnamed: R41.2, SW22.2, U10.4 (X7)
unnamed: R42.2, SW21.2, U10.2 (X6)
unnamed: R43.2, SW18.2, U19.12 (X3)
unnamed: R44.2, SW20.2, U10.5 (X5)
unnamed: R45.2, SW17.2, U19.15 (X2)
unnamed: R46.2, SW19.2, U10.1 (X4)
unnamed: R47.2, SW15.2, U11.5 (X5)
unnamed: R48.2, SW6.2, U10.12 (X3)
unnamed: R49.2, SW29.2, U11.1 (X4)
unnamed: R50.2, SW5.2, U10.15 (X2)
unnamed: R51.2, SW14.2, U11.12 (X3)
unnamed: R52.2, SW4.2, U10.14 (X1)
unnamed: R53.2, SW13.2, U11.15 (X2)
unnamed: R54.2, SW3.2, U10.13 (X0)
unnamed: R55.2, SW12.2, U11.14 (X1)
unnamed: R56.2, SW11.2, U11.13 (X0)
unnamed: R57.2, SW26.2, U12.4 (X7)
unnamed: R58.2, SW25.2, U12.2 (X6)
unnamed: R59.2, SW32.2, U19.14 (X1)
unnamed: R60.2, SW24.2, U12.5 (X5)
unnamed: R61.2, SW31.2, U19.13 (X0)
unnamed: R62.2, SW23.2, U12.1 (X4)
unnamed: R63.2, SW30.2, U13.5 (X5)
unnamed: R64.2, SW10.2, U12.12 (X3)
unnamed: R65.2, SW16.2, U13.1 (X4)
unnamed: R66.2, SW9.2, U12.15 (X2)
unnamed: R68.2, SW8.2, U12.14 (X1)
unnamed: R70.2, SW7.2, U12.13 (X0)
unnamed: R71.2, SW28.2, U19.5 (X5)
unnamed: R72.2, SW27.2, U19.2 (X6)
TempoEncBut: R67.2, U13.12 (X3); also elsewhere on the board
beat_rep: SW31.4 (A); also elsewhere on the board
beat_rep_2: SW32.4 (A); also elsewhere on the board

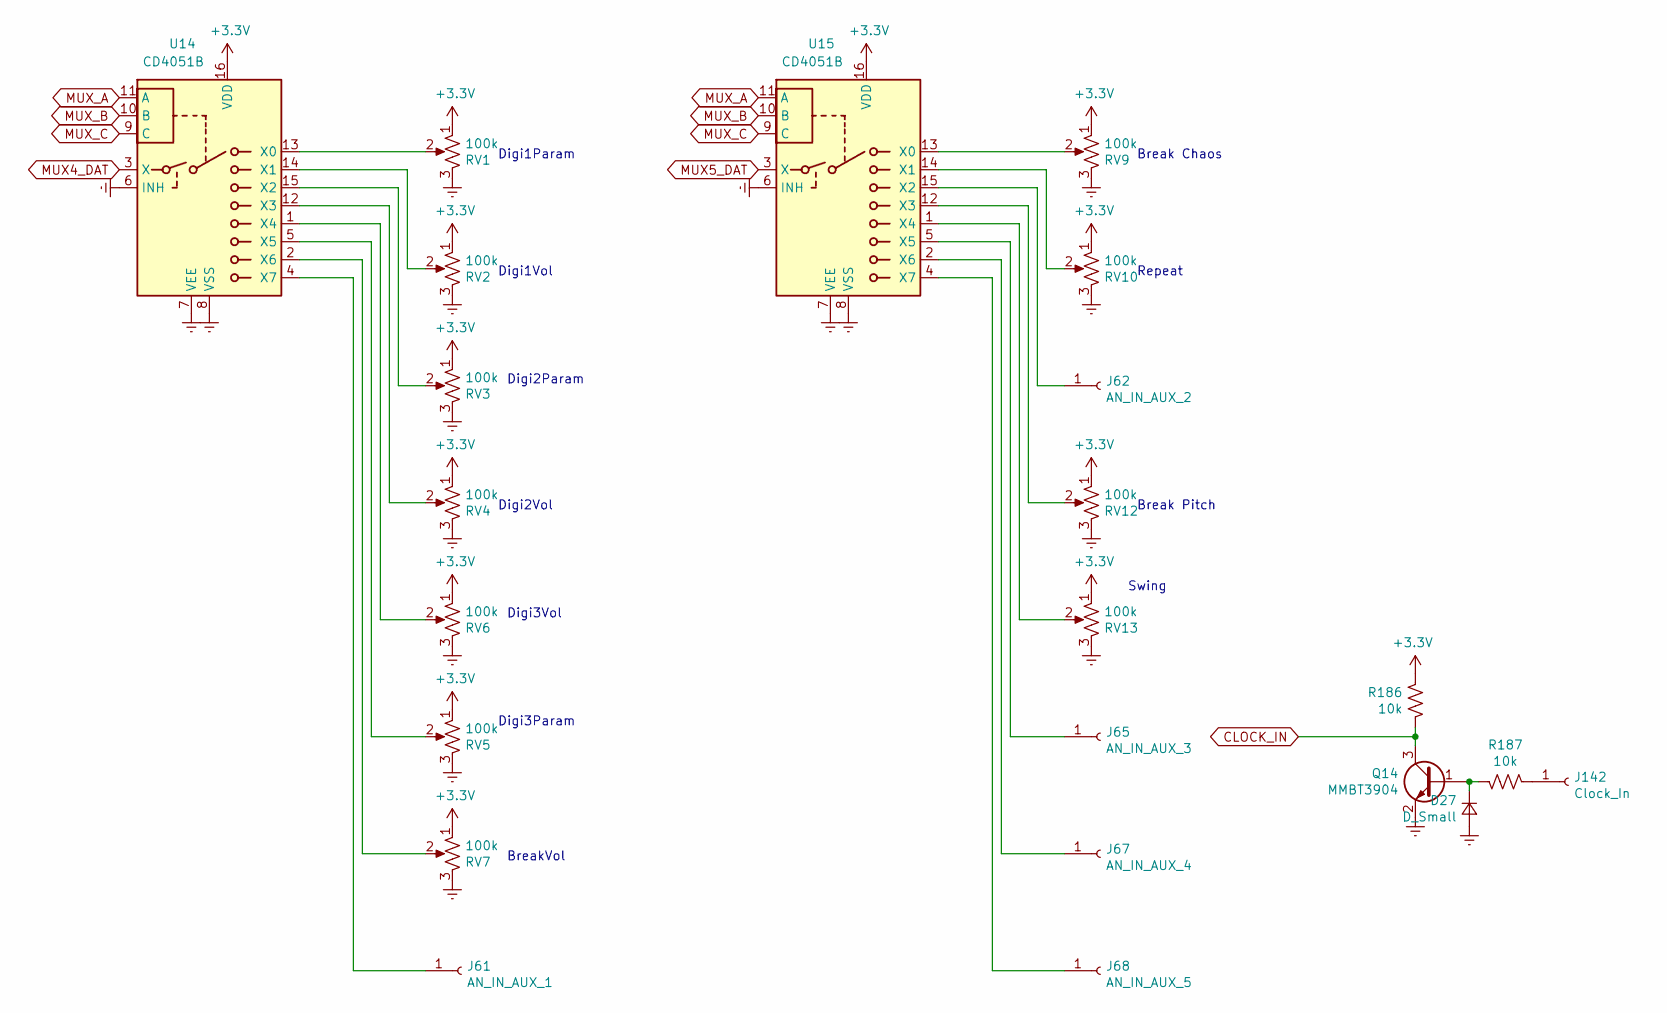
[picture p22: schematic AnalogIn.sch]

Parts:
D27: D_Small; D_SOD-123
J61: AN_IN_AUX_1; SolderWirePad_1x01_Drill1mm
J62: AN_IN_AUX_2; SolderWirePad_1x01_Drill1mm
J65: AN_IN_AUX_3; SolderWirePad_1x01_Drill1mm
J67: AN_IN_AUX_4; SolderWirePad_1x01_Drill1mm
J68: AN_IN_AUX_5; SolderWirePad_1x01_Drill1mm
J142: Clock_In; SolderWirePad_1x01_Drill1mm
Q14: MMBT3904; SOT-23
R186, R187: 10k; R_0603_1608Metric_Pad1.05x0.95mm_HandSolder
RV1, RV2, RV3, RV4, RV5, RV6, RV7, RV9, RV10, RV12, RV13: 100k; masonsPotentiometer_Alpha_RD901F-40-00D_Single_Vertical
U14, U15: CD4051B; SOIC-16_3.9x9.9mm_P1.27mm

Connections:
+3V3: R186.2, RV1.1, RV2.1, RV3.1, RV4.1, RV5.1, RV6.1, RV7.1, RV9.1, RV10.1, RV12.1, RV13.1, U14.16 (VDD), U15.16 (VDD); also elsewhere on the board
CLOCK_IN: Q14.3 (C), R186.1; also elsewhere on the board
Earth: D27.2 (A), Q14.2 (E), RV1.3, RV2.3, RV3.3, RV4.3, RV5.3, RV6.3, RV7.3, RV9.3, RV10.3, RV12.3, RV13.3, U14.6 (INH), U14.7 (VEE), U14.8 (VSS), U15.6 (INH), U15.7 (VEE), U15.8 (VSS); also elsewhere on the board
MUX4_DAT: U14.3 (X); also elsewhere on the board
MUX5_DAT: U15.3 (X); also elsewhere on the board
MUX_A: U14.11 (A), U15.11 (A); also elsewhere on the board
MUX_B: U14.10 (B), U15.10 (B); also elsewhere on the board
MUX_C: U14.9 (C), U15.9 (C); also elsewhere on the board
unnamed: D27.1 (K), Q14.1 (B), R187.1
unnamed: J61.1, U14.4 (X7)
unnamed: J62.1, U15.15 (X2)
unnamed: J65.1, U15.5 (X5)
unnamed: J67.1, U15.2 (X6)
unnamed: J68.1, U15.4 (X7)
unnamed: J142.1, R187.2
unnamed: RV1.2, U14.13 (X0)
unnamed: RV2.2, U14.14 (X1)
unnamed: RV3.2, U14.15 (X2)
unnamed: RV4.2, U14.12 (X3)
unnamed: RV5.2, U14.5 (X5)
unnamed: RV6.2, U14.1 (X4)
unnamed: RV7.2, U14.2 (X6)
unnamed: RV9.2, U15.13 (X0)
unnamed: RV10.2, U15.14 (X1)
unnamed: RV12.2, U15.12 (X3)
unnamed: RV13.2, U15.1 (X4)

Notes on the sheet:
Digi1Param
Digi2Param
Digi3Param
Digi1Vol
Digi2Vol
Digi3Vol
BreakVol
Break Chaos
Repeat
Break Pitch
Swing
