masonandrewmann/drum_machine/harware_design/DrumMachineControlBoard/DrumMachineControlBoard.kicad_pcb

## KiCad design harware_design/DrumMachineControlBoard/DrumMachineControlBoard.kicad_pcb (continued)

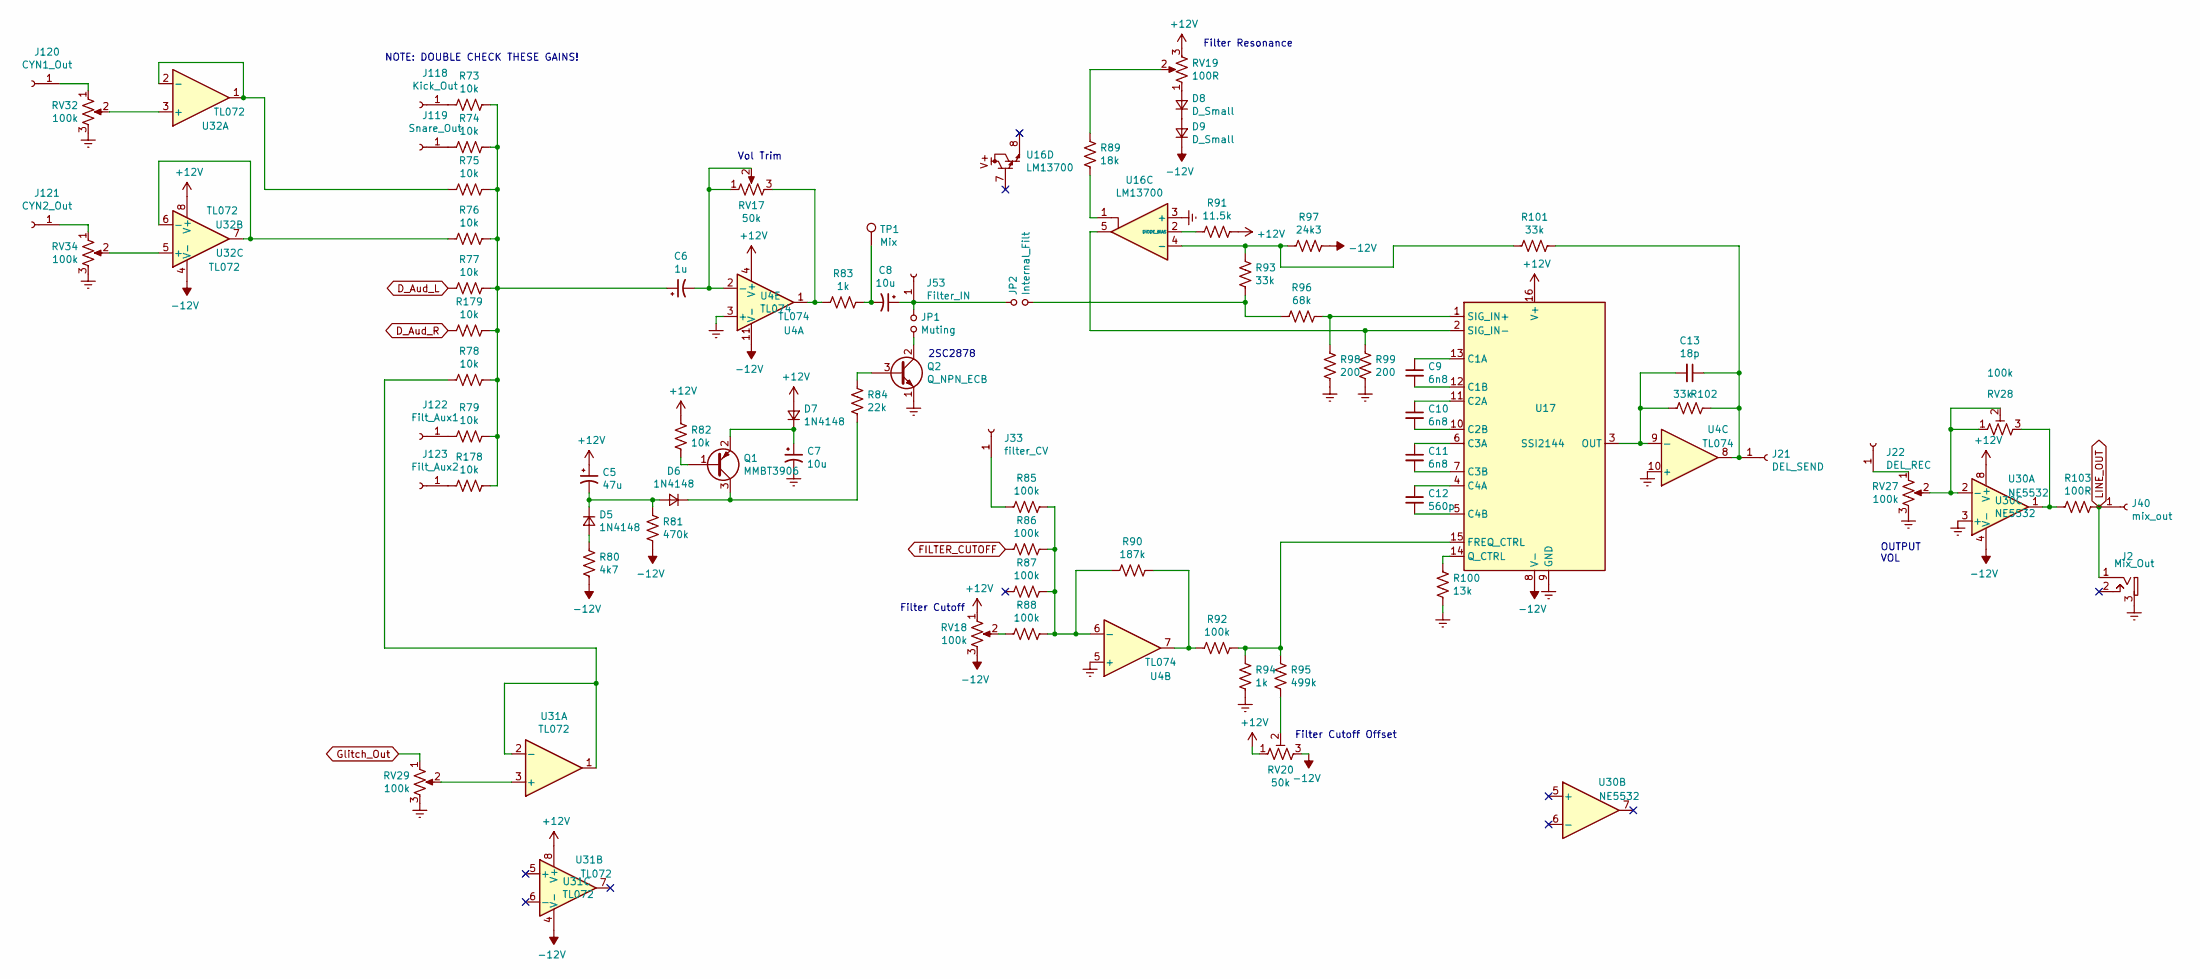
[picture p23: schematic OutputMixer.sch]

Parts:
C5: 47u; CP_Elec_8x6.2
C6: 1u; CP_Elec_4x4.5
C7, C8: 10u; CP_Elec_5x5.3
C9, C10, C11: 6n8; C_0603_1608Metric_Pad1.05x0.95mm_HandSolder
C12: 560p; C_0603_1608Metric_Pad1.05x0.95mm_HandSolder
C13: 18p; C_0603_1608Metric_Pad1.05x0.95mm_HandSolder
D5, D6, D7: 1N4148; D_SOD-123
D8, D9: D_Small; D_SOD-123
J2: Mix_Out; SolderWirePad_1x01_Drill1mm
J21: DEL_SEND; SolderWirePad_1x01_Drill1mm
J22: DEL_REC; SolderWirePad_1x01_Drill1mm
J33: filter_CV; SolderWirePad_1x01_Drill1mm
J40: mix_out; SolderWirePad_1x01_Drill1mm
J53: Filter_IN; SolderWirePad_1x01_Drill1mm
J118: Kick_Out; SolderWirePad_1x01_Drill1mm
J119: Snare_Out; SolderWirePad_1x01_Drill1mm
J120: CYN1_Out; SolderWirePad_1x01_Drill1mm
J121: CYN2_Out; SolderWirePad_1x01_Drill1mm
J122: Filt_Aux1; SolderWirePad_1x01_Drill1mm
J123: Filt_Aux2; SolderWirePad_1x01_Drill1mm
JP1: Muting; SolderJumper-2_P1.3mm_Open_RoundedPad1.0x1.5mm
JP2: Internal_Filt; SolderJumper-2_P1.3mm_Open_RoundedPad1.0x1.5mm
Q1: MMBT3906; SOT-23
Q2: Q_NPN_ECB; TO-92_Inline_Wide
R73, R74, R75, R76, R77, R78, R79, R82, R178, R179: 10k; R_0603_1608Metric_Pad1.05x0.95mm_HandSolder
R80: 4k7; R_0603_1608Metric_Pad1.05x0.95mm_HandSolder
R81: 470k; R_0603_1608Metric_Pad1.05x0.95mm_HandSolder
R83, R94: 1k; R_0603_1608Metric_Pad1.05x0.95mm_HandSolder
R84: 22k; R_0603_1608Metric_Pad1.05x0.95mm_HandSolder
R85, R86, R87, R88, R92: 100k; R_0603_1608Metric_Pad1.05x0.95mm_HandSolder
R89: 18k; R_0603_1608Metric_Pad1.05x0.95mm_HandSolder
R90: 187k; R_0603_1608Metric_Pad1.05x0.95mm_HandSolder
R91: 11.5k; R_0603_1608Metric_Pad1.05x0.95mm_HandSolder
R93, R101, R102: 33k; R_0603_1608Metric_Pad1.05x0.95mm_HandSolder
R95: 499k; R_0603_1608Metric_Pad1.05x0.95mm_HandSolder
R96: 68k; R_0603_1608Metric_Pad1.05x0.95mm_HandSolder
R97: 24k3; R_0603_1608Metric_Pad1.05x0.95mm_HandSolder
R98, R99: 200; R_0603_1608Metric_Pad1.05x0.95mm_HandSolder
R100: 13k; R_0603_1608Metric_Pad1.05x0.95mm_HandSolder
R103: 100R; R_0603_1608Metric_Pad1.05x0.95mm_HandSolder
RV17, RV20: 50k; Potentiometer_Runtron_RM-065_Vertical
RV18, RV27, RV29, RV32, RV34: 100k; masonsPotentiometer_Alpha_RD901F-40-00D_Single_Vertical
RV19: 100R; masonsPotentiometer_Alpha_RD901F-40-00D_Single_Vertical
RV28: 100k; Potentiometer_Runtron_RM-065_Vertical
TP1: Mix; TestPoint_Loop_D2.50mm_Drill1.0mm
U4: TL074; SOIC-14_3.9x8.7mm_P1.27mm
U16: LM13700; SOIC-16_3.9x9.9mm_P1.27mm
U17: SSI2144; SSOP-16_3.9x4.9mm_P0.635mm
U30: NE5532; DIP-8_W7.62mm_Socket
U31, U32: TL072; SOIC-8_3.9x4.9mm_P1.27mm

Connections:
+12V: C5.1, D7.2 (A), R82.2, R91.1, RV18.1, RV19.3, RV20.1, U4.4 (V+), U17.16 (V+), U30.8 (V+), U31.8 (V+), U32.8 (V+); also elsewhere on the board
-12V: D9.1 (K), R80.1, R81.1, R97.1, RV18.3, RV20.3, U4.11 (V-), U17.8 (V-), U30.4 (V-), U31.4 (V-), U32.4 (V-); also elsewhere on the board
D_Aud_L: R77.2; also elsewhere on the board
D_Aud_R: R179.2; also elsewhere on the board
Earth: C7.2, J2.3, Q2.1 (E), R94.1, R98.1, R99.1, R100.1, RV27.3, RV29.3, RV32.3, RV34.3, U4.3 (+), U4.5 (+), U4.10 (+), U16.3 (+), U17.9 (GND), U30.3 (+); also elsewhere on the board
FILTER_CUTOFF: R86.2; also elsewhere on the board
Glitch_Out: RV29.1; also elsewhere on the board
LINE_OUT: J2.1, J40.1, R103.1; also elsewhere on the board
unnamed: C5.2, D5.1 (K), D6.2 (A), R81.2
unnamed: C6.1, R73.1, R74.1, R75.1, R76.1, R77.1, R78.1, R79.1, R178.1, R179.1
unnamed: C6.2, RV17.1, RV17.2, U4.2 (-)
unnamed: C7.1, D7.1 (K), Q1.2 (E)
unnamed: C8.1, J53.1, JP1.1, JP2.1
unnamed: C8.2, R83.1, TP1.1
unnamed: C9.1, U17.13 (C1A)
unnamed: C9.2, U17.12 (C1B)
unnamed: C10.1, U17.11 (C2A)
unnamed: C10.2, U17.10 (C2B)
unnamed: C11.1, U17.6 (C3A)
unnamed: C11.2, U17.7 (C3B)
unnamed: C12.1, U17.4 (C4A)
unnamed: C12.2, U17.5 (C4B)
unnamed: C13.1, J21.1, R101.1, R102.2, U4.8
unnamed: C13.2, R102.1, U4.9 (-), U17.3 (OUT)
unnamed: D5.2 (A), R80.2
unnamed: D6.1 (K), Q1.3 (C), R84.1
unnamed: D8.1 (K), D9.2 (A)
unnamed: D8.2 (A), RV19.1
unnamed: J22.1, RV27.1
unnamed: J33.1, R85.2
unnamed: J118.1, R73.2
unnamed: J119.1, R74.2
unnamed: J120.1, RV32.1
unnamed: J121.1, RV34.1
unnamed: J122.1, R79.2
unnamed: J123.1, R178.2
unnamed: JP1.2, Q2.2 (C)
unnamed: JP2.2, R93.2, R96.1
unnamed: Q1.1 (B), R82.1
unnamed: Q2.3 (B), R84.2
unnamed: R75.2, U32.1, U32.2 (-)
unnamed: R76.2, U32.6 (-), U32.7
unnamed: R78.2, U31.1, U31.2 (-)
unnamed: R83.2, RV17.3, U4.1
unnamed: R85.1, R86.1, R87.1, R88.1, R90.2, U4.6 (-)
unnamed: R88.2, RV18.2
unnamed: R89.1, RV19.2
unnamed: R89.2, U16.1
unnamed: R90.1, R92.2, U4.7
unnamed: R91.2, U16.2 (DIODE_BIAS)
unnamed: R92.1, R94.2, R95.2, U17.15 (FREQ_CTRL)
unnamed: R95.1, RV20.2
unnamed: R96.2, R98.2, U17.1 (SIG_IN+)
unnamed: R99.2, U16.5, U17.2 (SIG_IN-)
unnamed: R100.2, U17.14 (Q_CTRL)
unnamed: R93.1, R97.2, R101.2, U16.4 (-)
unnamed: R103.2, RV28.3, U30.1
unnamed: RV27.2, RV28.1, RV28.2, U30.2 (-)
unnamed: RV29.2, U31.3 (+)
unnamed: RV32.2, U32.3 (+)
unnamed: RV34.2, U32.5 (+)

Notes on the sheet:
NOTE: DOUBLE CHECK THESE GAINS!
Filter Cutoff Offset
Filter Resonance
Filter Cutoff
Vol Trim
2SC2878
OUTPUT VOL

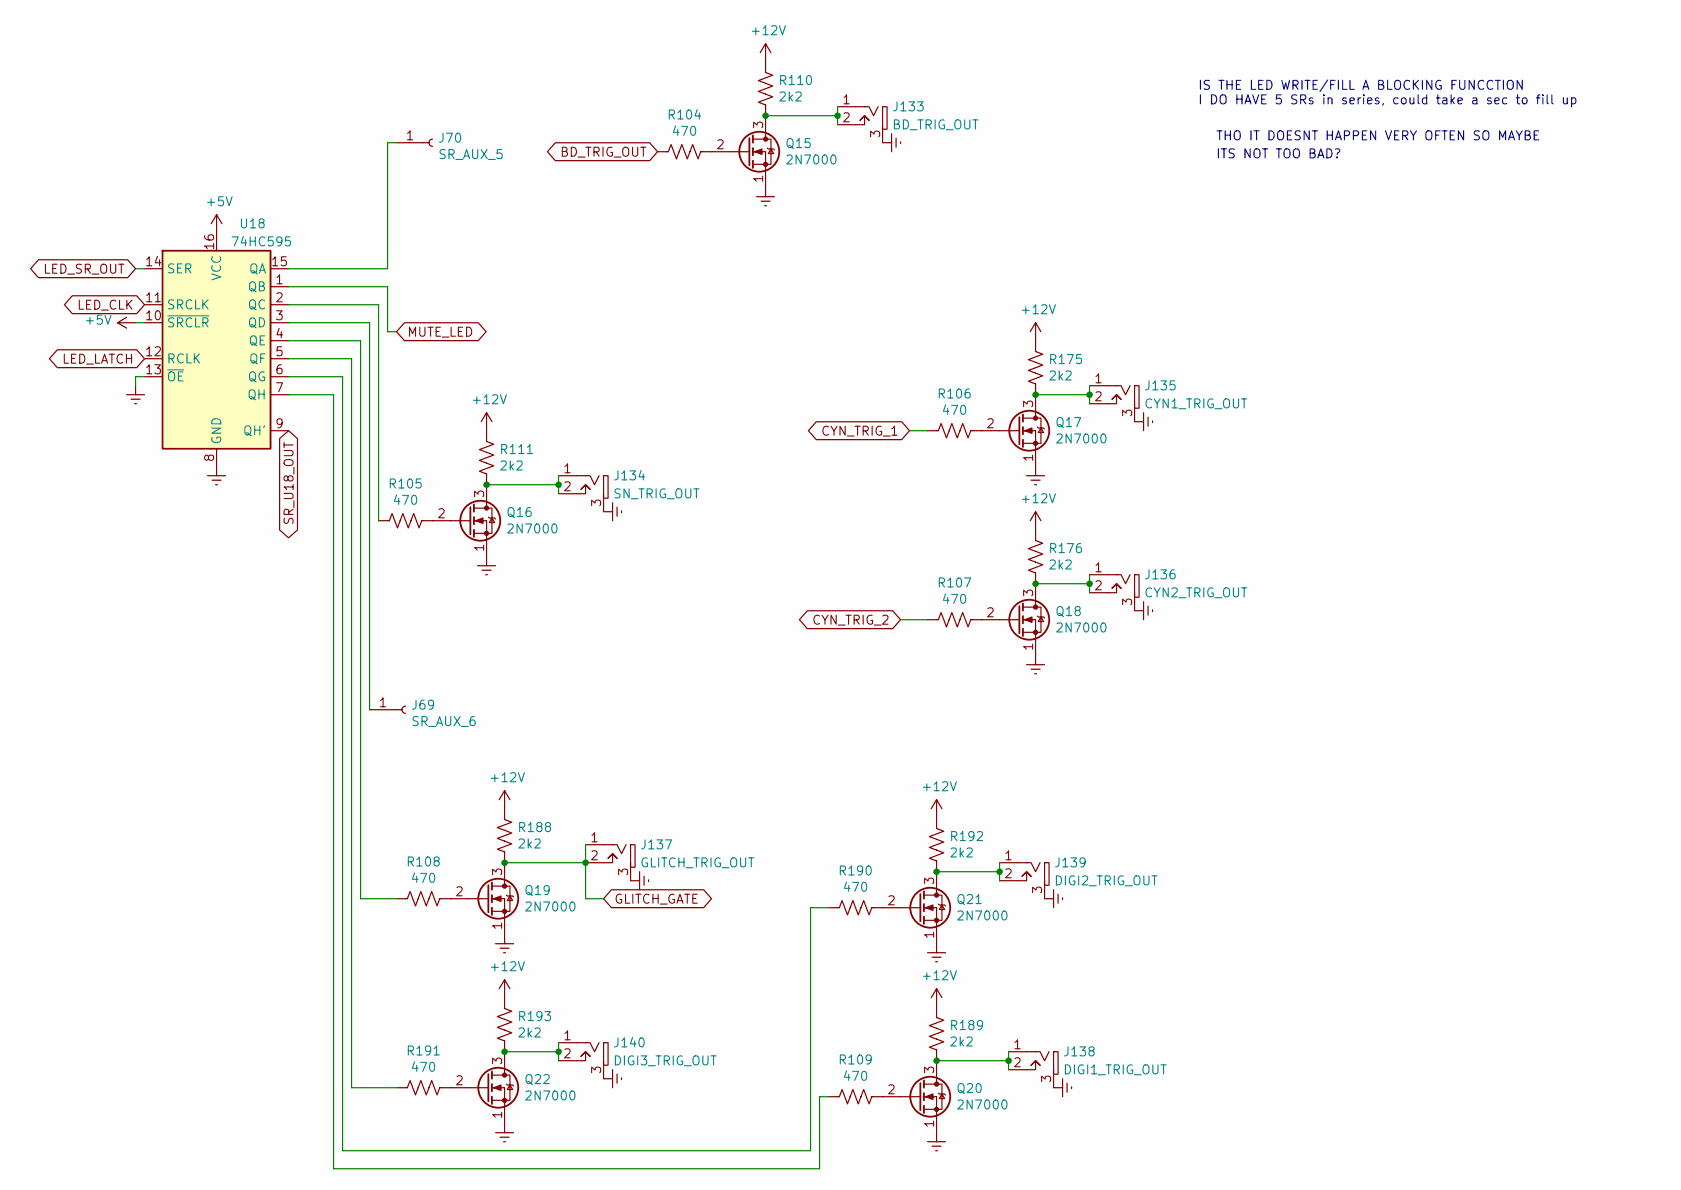
[picture p24: schematic TrigOuts.sch]

Parts:
J69: SR_AUX_6; SolderWirePad_1x01_Drill1mm
J70: SR_AUX_5; SolderWirePad_1x01_Drill1mm
J133: BD_TRIG_OUT; PJ301-BM
J134: SN_TRIG_OUT; PJ301-BM
J135: CYN1_TRIG_OUT; PJ301-BM
J136: CYN2_TRIG_OUT; PJ301-BM
J137: GLITCH_TRIG_OUT; PJ301-BM
J138: DIGI1_TRIG_OUT; PJ301-BM
J139: DIGI2_TRIG_OUT; PJ301-BM
J140: DIGI3_TRIG_OUT; PJ301-BM
Q15, Q16, Q17, Q18, Q19, Q20, Q21, Q22: 2N7000; SOT-23_Handsoldering
R104, R105, R106, R107, R108, R109, R190, R191: 470; R_0603_1608Metric_Pad1.05x0.95mm_HandSolder
R110, R111, R175, R176, R188, R189, R192, R193: 2k2; R_0603_1608Metric_Pad1.05x0.95mm_HandSolder
U18: 74HC595; SOIC-16_3.9x9.9mm_P1.27mm

Connections:
+5V: U18.10 (~SRCLR), U18.16 (VCC); also elsewhere on the board
+12V: R110.1, R111.1, R175.1, R176.1, R188.1, R189.1, R192.1, R193.1; also elsewhere on the board
BD_TRIG_OUT: R104.2; also elsewhere on the board
CYN_TRIG_1: R106.2; also elsewhere on the board
CYN_TRIG_2: R107.2; also elsewhere on the board
Earth: J133.3, J134.3, J135.3, J136.3, J137.3, J138.3, J139.3, J140.3, Q15.1 (S), Q16.1 (S), Q17.1 (S), Q18.1 (S), Q19.1 (S), Q20.1 (S), Q21.1 (S), Q22.1 (S), U18.8 (GND), U18.13 (~OE); also elsewhere on the board
GLITCH_GATE: J137.1, J137.2, Q19.3 (D), R188.2; also elsewhere on the board
LED_CLK: U18.11 (SRCLK); also elsewhere on the board
LED_LATCH: U18.12 (RCLK); also elsewhere on the board
LED_SR_OUT: U18.14 (SER); also elsewhere on the board
MUTE_LED: U18.1 (QB); also elsewhere on the board
unnamed: J69.1, U18.3 (QD)
unnamed: J70.1, U18.15 (QA)
unnamed: J133.1, J133.2, Q15.3 (D), R110.2
unnamed: J134.1, J134.2, Q16.3 (D), R111.2
unnamed: J135.1, J135.2, Q17.3 (D), R175.2
unnamed: J136.1, J136.2, Q18.3 (D), R176.2
unnamed: J138.1, J138.2, Q20.3 (D), R189.2
unnamed: J139.1, J139.2, Q21.3 (D), R192.2
unnamed: J140.1, J140.2, Q22.3 (D), R193.2
unnamed: Q15.2 (G), R104.1
unnamed: Q16.2 (G), R105.1
unnamed: Q17.2 (G), R106.1
unnamed: Q18.2 (G), R107.1
unnamed: Q19.2 (G), R108.1
unnamed: Q20.2 (G), R109.1
unnamed: Q21.2 (G), R190.1
unnamed: Q22.2 (G), R191.1
unnamed: R105.2, U18.2 (QC)
unnamed: R108.2, U18.4 (QE)
unnamed: R109.2, U18.7 (QH)
unnamed: R190.2, U18.6 (QG)
unnamed: R191.2, U18.5 (QF)
SR_U18_OUT: U18.9 (QH'); also elsewhere on the board

Notes on the sheet:
IS THE LED WRITE/FILL A BLOCKING FUNCCTION I DO HAVE 5 SRs in series, could take a sec to fill up
THO IT DOESNT HAPPEN VERY OFTEN SO MAYBE
ITS NOT TOO BAD?

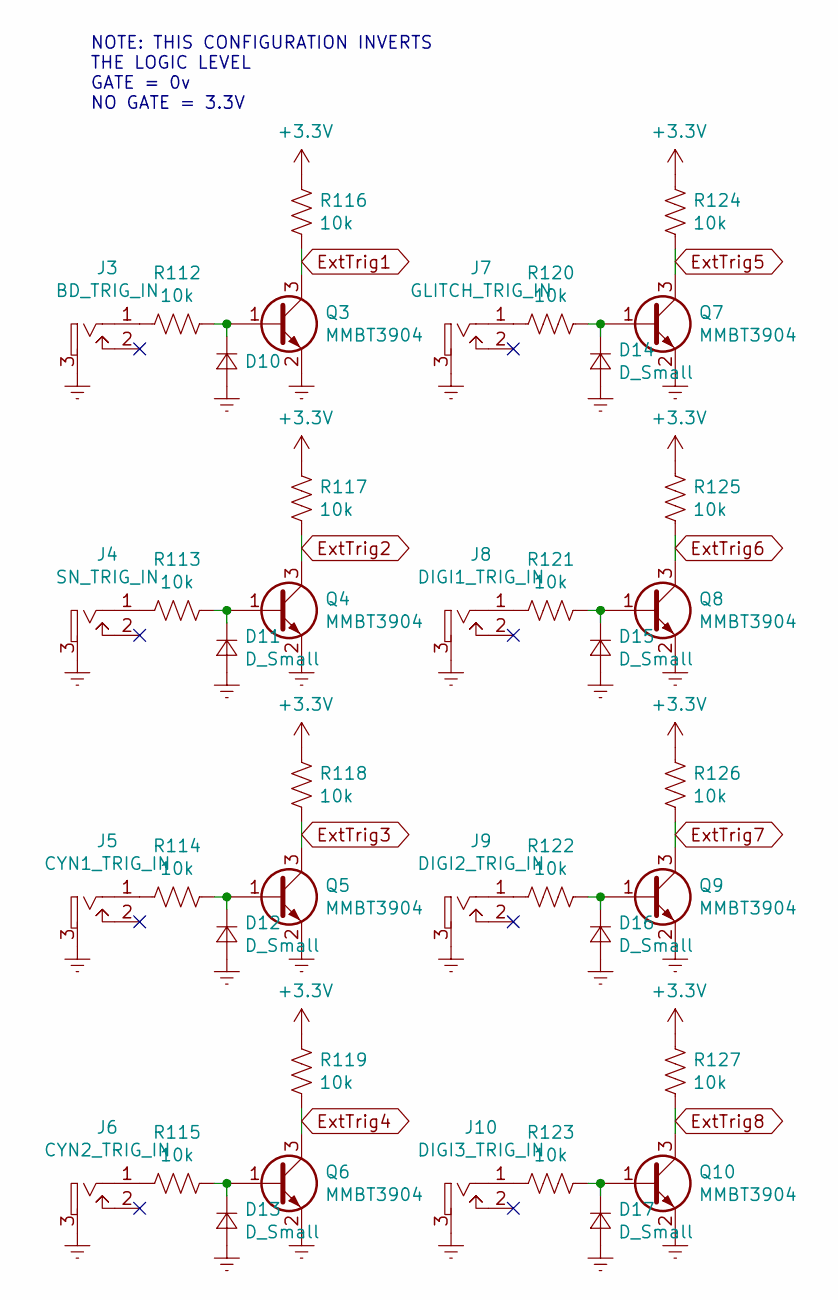
[picture p25: schematic ExternalTrigger.sch]

Parts:
D10, D11, D12, D13, D14, D15, D16, D17: D_Small; D_SOD-123
J3: BD_TRIG_IN; PJ301-BM
J4: SN_TRIG_IN; PJ301-BM
J5: CYN1_TRIG_IN; PJ301-BM
J6: CYN2_TRIG_IN; PJ301-BM
J7: GLITCH_TRIG_IN; PJ301-BM
J8: DIGI1_TRIG_IN; PJ301-BM
J9: DIGI2_TRIG_IN; PJ301-BM
J10: DIGI3_TRIG_IN; PJ301-BM
Q3, Q4, Q5, Q6, Q7, Q8, Q9, Q10: MMBT3904; SOT-23
R112, R113, R114, R115, R116, R117, R118, R119, R120, R121, R122, R123, R124, R125, R126, R127: 10k; R_0603_1608Metric_Pad1.05x0.95mm_HandSolder

Connections:
+3V3: R116.2, R117.2, R118.2, R119.2, R124.2, R125.2, R126.2, R127.2; also elsewhere on the board
Earth: D10.2 (A), D11.2 (A), D12.2 (A), D13.2 (A), D14.2 (A), D15.2 (A), D16.2 (A), D17.2 (A), J3.3, J4.3, J5.3, J6.3, J7.3, J8.3, J9.3, J10.3, Q3.2 (E), Q4.2 (E), Q5.2 (E), Q6.2 (E), Q7.2 (E), Q8.2 (E), Q9.2 (E), Q10.2 (E); also elsewhere on the board
ExtTrig1: Q3.3 (C), R116.1; also elsewhere on the board
ExtTrig2: Q4.3 (C), R117.1; also elsewhere on the board
ExtTrig3: Q5.3 (C), R118.1; also elsewhere on the board
ExtTrig4: Q6.3 (C), R119.1; also elsewhere on the board
ExtTrig5: Q7.3 (C), R124.1; also elsewhere on the board
ExtTrig6: Q8.3 (C), R125.1; also elsewhere on the board
ExtTrig7: Q9.3 (C), R126.1; also elsewhere on the board
ExtTrig8: Q10.3 (C), R127.1; also elsewhere on the board
unnamed: D10.1 (K), Q3.1 (B), R112.1
unnamed: D11.1 (K), Q4.1 (B), R113.1
unnamed: D12.1 (K), Q5.1 (B), R114.1
unnamed: D13.1 (K), Q6.1 (B), R115.1
unnamed: D14.1 (K), Q7.1 (B), R120.1
unnamed: D15.1 (K), Q8.1 (B), R121.1
unnamed: D16.1 (K), Q9.1 (B), R122.1
unnamed: D17.1 (K), Q10.1 (B), R123.1
unnamed: J3.1, R112.2
unnamed: J4.1, R113.2
unnamed: J5.1, R114.2
unnamed: J6.1, R115.2
unnamed: J7.1, R120.2
unnamed: J8.1, R121.2
unnamed: J9.1, R122.2
unnamed: J10.1, R123.2

Notes on the sheet:
NOTE: THIS CONFIGURATION INVERTS THE LOGIC LEVEL GATE = 0v NO GATE = 3.3V

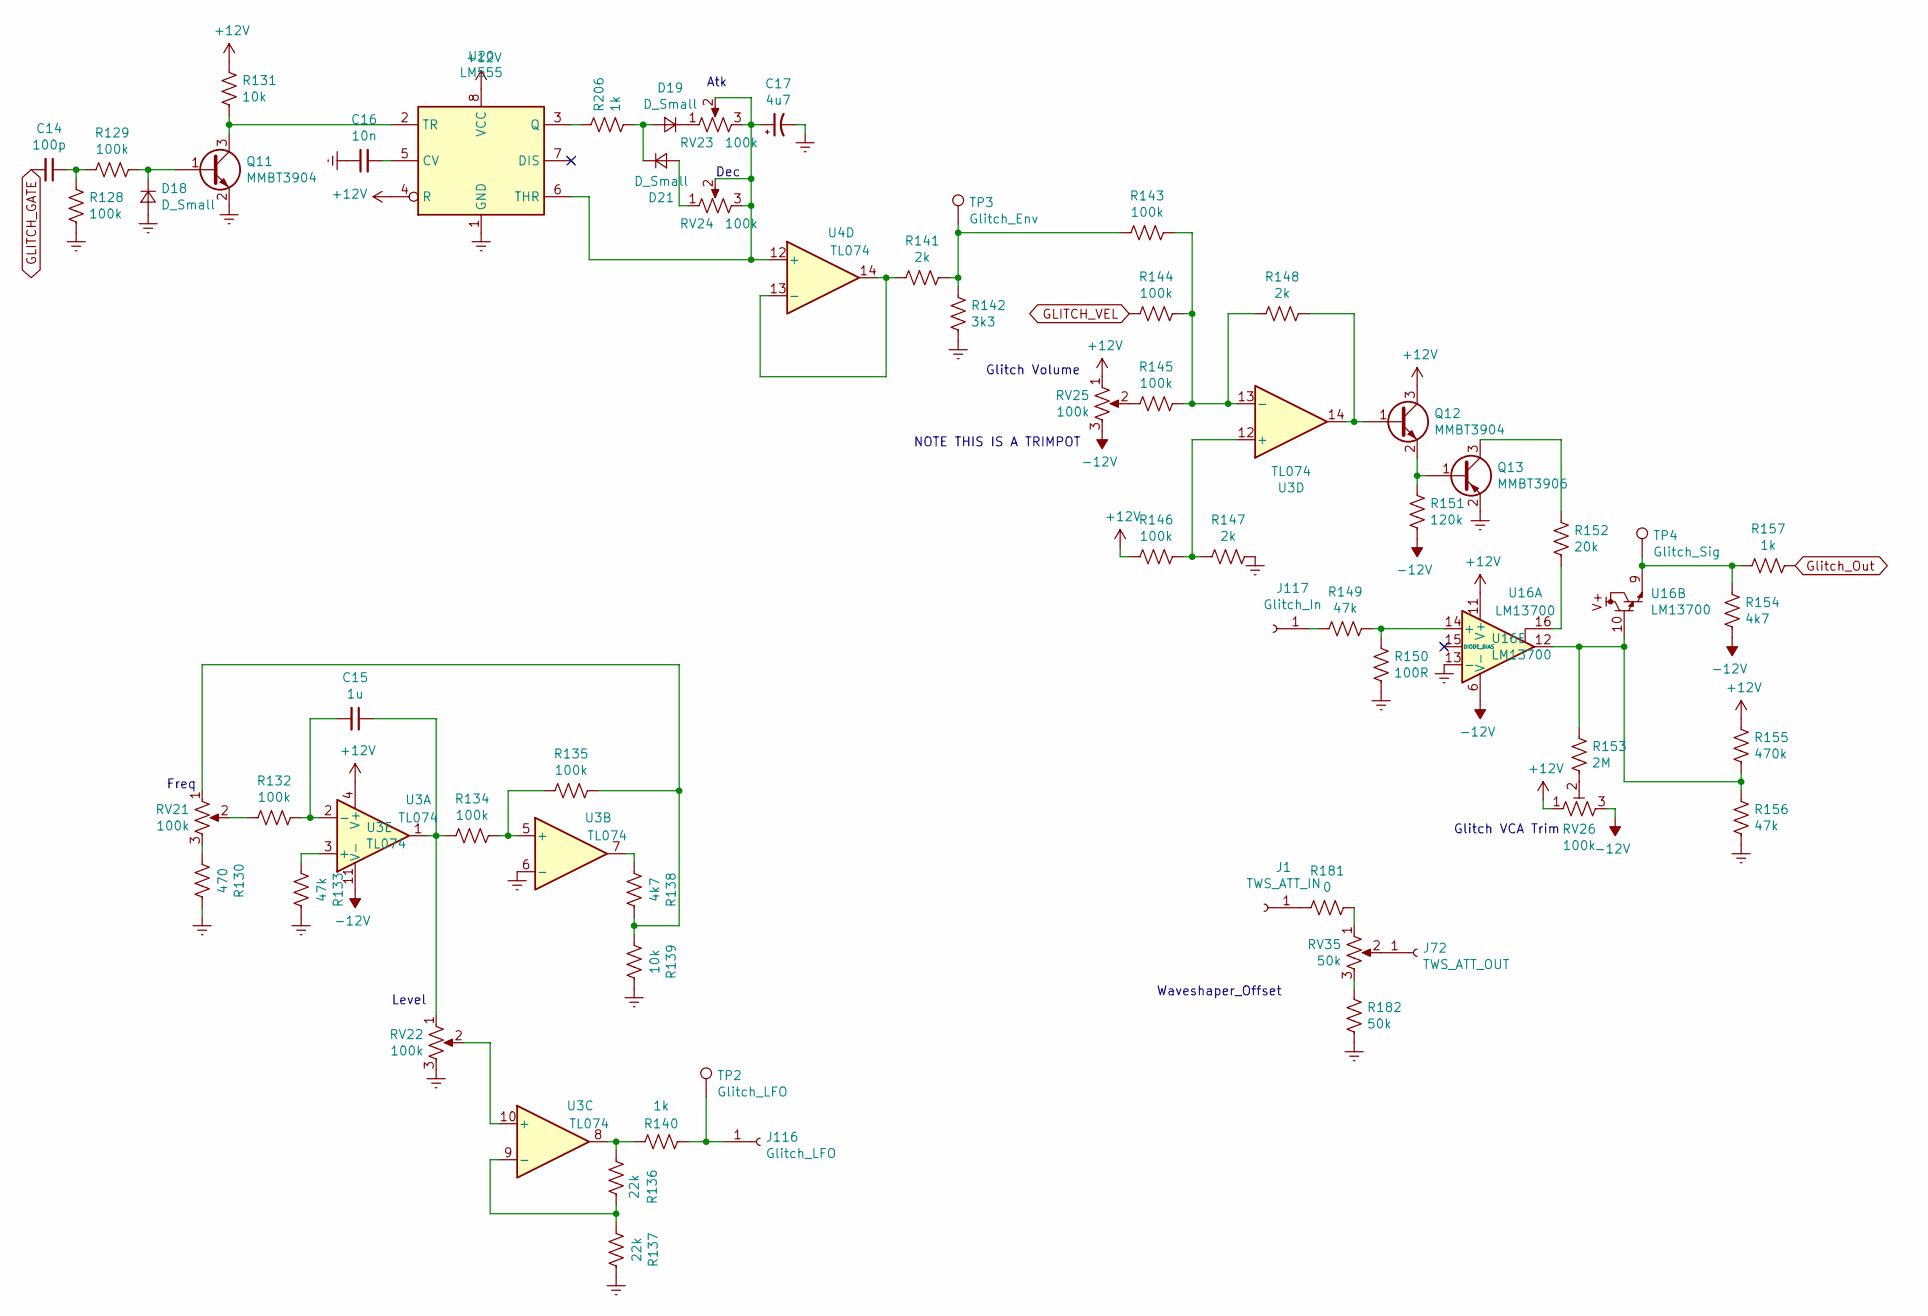
[picture p26: schematic GlitchVoice.sch]

Parts:
C14: 100p; C_0603_1608Metric_Pad1.05x0.95mm_HandSolder
C15: 1u; CP_Elec_4x4.5
C16: 10n; C_0603_1608Metric_Pad1.05x0.95mm_HandSolder
C17: 4u7; CP_Elec_4x4.5
D18, D19, D21: D_Small; D_SOD-123
J1: TWS_ATT_IN; SolderWirePad_1x01_Drill1mm
J72: TWS_ATT_OUT; SolderWirePad_1x01_Drill1mm
J116: Glitch_LFO; SolderWirePad_1x01_Drill1mm
J117: Glitch_In; SolderWirePad_1x01_Drill1mm
Q11, Q12: MMBT3904; SOT-23
Q13: MMBT3906; SOT-23
R128, R129, R132, R134, R135, R143, R144, R145, R146: 100k; R_0603_1608Metric_Pad1.05x0.95mm_HandSolder
R130: 470; R_0603_1608Metric_Pad1.05x0.95mm_HandSolder
R131, R139: 10k; R_0603_1608Metric_Pad1.05x0.95mm_HandSolder
R133, R149, R156: 47k; R_0603_1608Metric_Pad1.05x0.95mm_HandSolder
R136, R137: 22k; R_0603_1608Metric_Pad1.05x0.95mm_HandSolder
R138, R154: 4k7; R_0603_1608Metric_Pad1.05x0.95mm_HandSolder
R140, R157, R206: 1k; R_0603_1608Metric_Pad1.05x0.95mm_HandSolder
R141, R147, R148: 2k; R_0603_1608Metric_Pad1.05x0.95mm_HandSolder
R142: 3k3; R_0603_1608Metric_Pad1.05x0.95mm_HandSolder
R150: 100R; R_0603_1608Metric_Pad1.05x0.95mm_HandSolder
R151: 120k; R_0603_1608Metric_Pad1.05x0.95mm_HandSolder
R152: 20k; R_0603_1608Metric_Pad1.05x0.95mm_HandSolder
R153: 2M; R_0603_1608Metric_Pad1.05x0.95mm_HandSolder
R155: 470k; R_0603_1608Metric_Pad1.05x0.95mm_HandSolder
R181: 0; R_0603_1608Metric_Pad1.05x0.95mm_HandSolder
R182: 50k; R_0603_1608Metric_Pad1.05x0.95mm_HandSolder
RV21, RV22, RV23, RV24: 100k; masonsPotentiometer_Alpha_RD901F-40-00D_Single_Vertical
RV25, RV26: 100k; Potentiometer_Runtron_RM-065_Vertical
RV35: 50k; masonsPotentiometer_Alpha_RD901F-40-00D_Single_Vertical
TP2: Glitch_LFO; TestPoint_Loop_D2.50mm_Drill1.0mm
TP3: Glitch_Env; TestPoint_Loop_D2.50mm_Drill1.0mm
TP4: Glitch_Sig; TestPoint_Loop_D2.50mm_Drill1.0mm
U3, U4: TL074; SOIC-14_3.9x8.7mm_P1.27mm
U16: LM13700; SOIC-16_3.9x9.9mm_P1.27mm
U20: LM555; DIP-8_W7.62mm_Socket

Connections:
+12V: Q12.3 (C), R131.2, R146.2, R155.1, RV25.1, RV26.1, U3.4 (V+), U16.11 (V+), U20.4 (R), U20.8 (VCC); also elsewhere on the board
-12V: R151.2, R154.2, RV25.3, RV26.3, U3.11 (V-), U16.6 (V-); also elsewhere on the board
Earth: C16.1, C17.2, D18.2 (A), Q11.2 (E), Q13.2 (E), R128.2, R130.1, R133.1, R137.1, R139.1, R142.2, R147.1, R150.2, R156.2, R182.1, RV22.3, U3.6 (-), U16.13 (-), U20.1 (GND); also elsewhere on the board
GLITCH_GATE: C14.2; also elsewhere on the board
GLITCH_VEL: R144.2; also elsewhere on the board
Glitch_Out: R157.1; also elsewhere on the board
unnamed: C14.1, R128.1, R129.2
unnamed: C15.1, R134.2, RV22.1, U3.1
unnamed: C15.2, R132.1, U3.2 (-)
unnamed: C16.2, U20.5 (CV)
unnamed: C17.1, RV23.2, RV23.3, RV24.2, RV24.3, U4.12 (+), U20.6 (THR)
unnamed: D18.1 (K), Q11.1 (B), R129.1
unnamed: D19.1 (K), RV23.1
unnamed: D19.2 (A), D21.1 (K), R206.1
unnamed: D21.2 (A), RV24.1
unnamed: J1.1, R181.2
unnamed: J72.1, RV35.2
unnamed: J116.1, R140.2, TP2.1
unnamed: J117.1, R149.2
unnamed: Q11.3 (C), R131.1, U20.2 (TR)
unnamed: Q12.1 (B), R148.1, U3.14
unnamed: Q12.2 (E), Q13.1 (B), R151.1
unnamed: Q13.3 (C), R152.1
unnamed: R130.2, RV21.3
unnamed: R132.2, RV21.2
unnamed: R133.2, U3.3 (+)
unnamed: R134.1, R135.2, U3.5 (+)
unnamed: R135.1, R138.1, R139.2, RV21.1
unnamed: R136.1, R137.2, U3.9 (-)
unnamed: R136.2, R140.1, U3.8
unnamed: R138.2, U3.7
unnamed: R141.1, U4.13 (-), U4.14
unnamed: R141.2, R142.1, R143.2, TP3.1
unnamed: R143.1, R144.1, R145.1, R148.2, U3.13 (-)
unnamed: R145.2, RV25.2
unnamed: R146.1, R147.2, U3.12 (+)
unnamed: R149.1, R150.1, U16.14 (+)
unnamed: R152.2, U16.16
unnamed: R153.1, R155.2, R156.1, U16.10, U16.12
unnamed: R153.2, RV26.2
unnamed: R154.1, R157.2, TP4.1, U16.9
unnamed: R181.1, RV35.1
unnamed: R182.2, RV35.3
unnamed: R206.2, U20.3 (Q)
unnamed: RV22.2, U3.10 (+)

Notes on the sheet:
Glitch Volume
Glitch VCA Trim
Level
Freq
Atk
Dec
NOTE THIS IS A TRIMPOT
Waveshaper_Offset

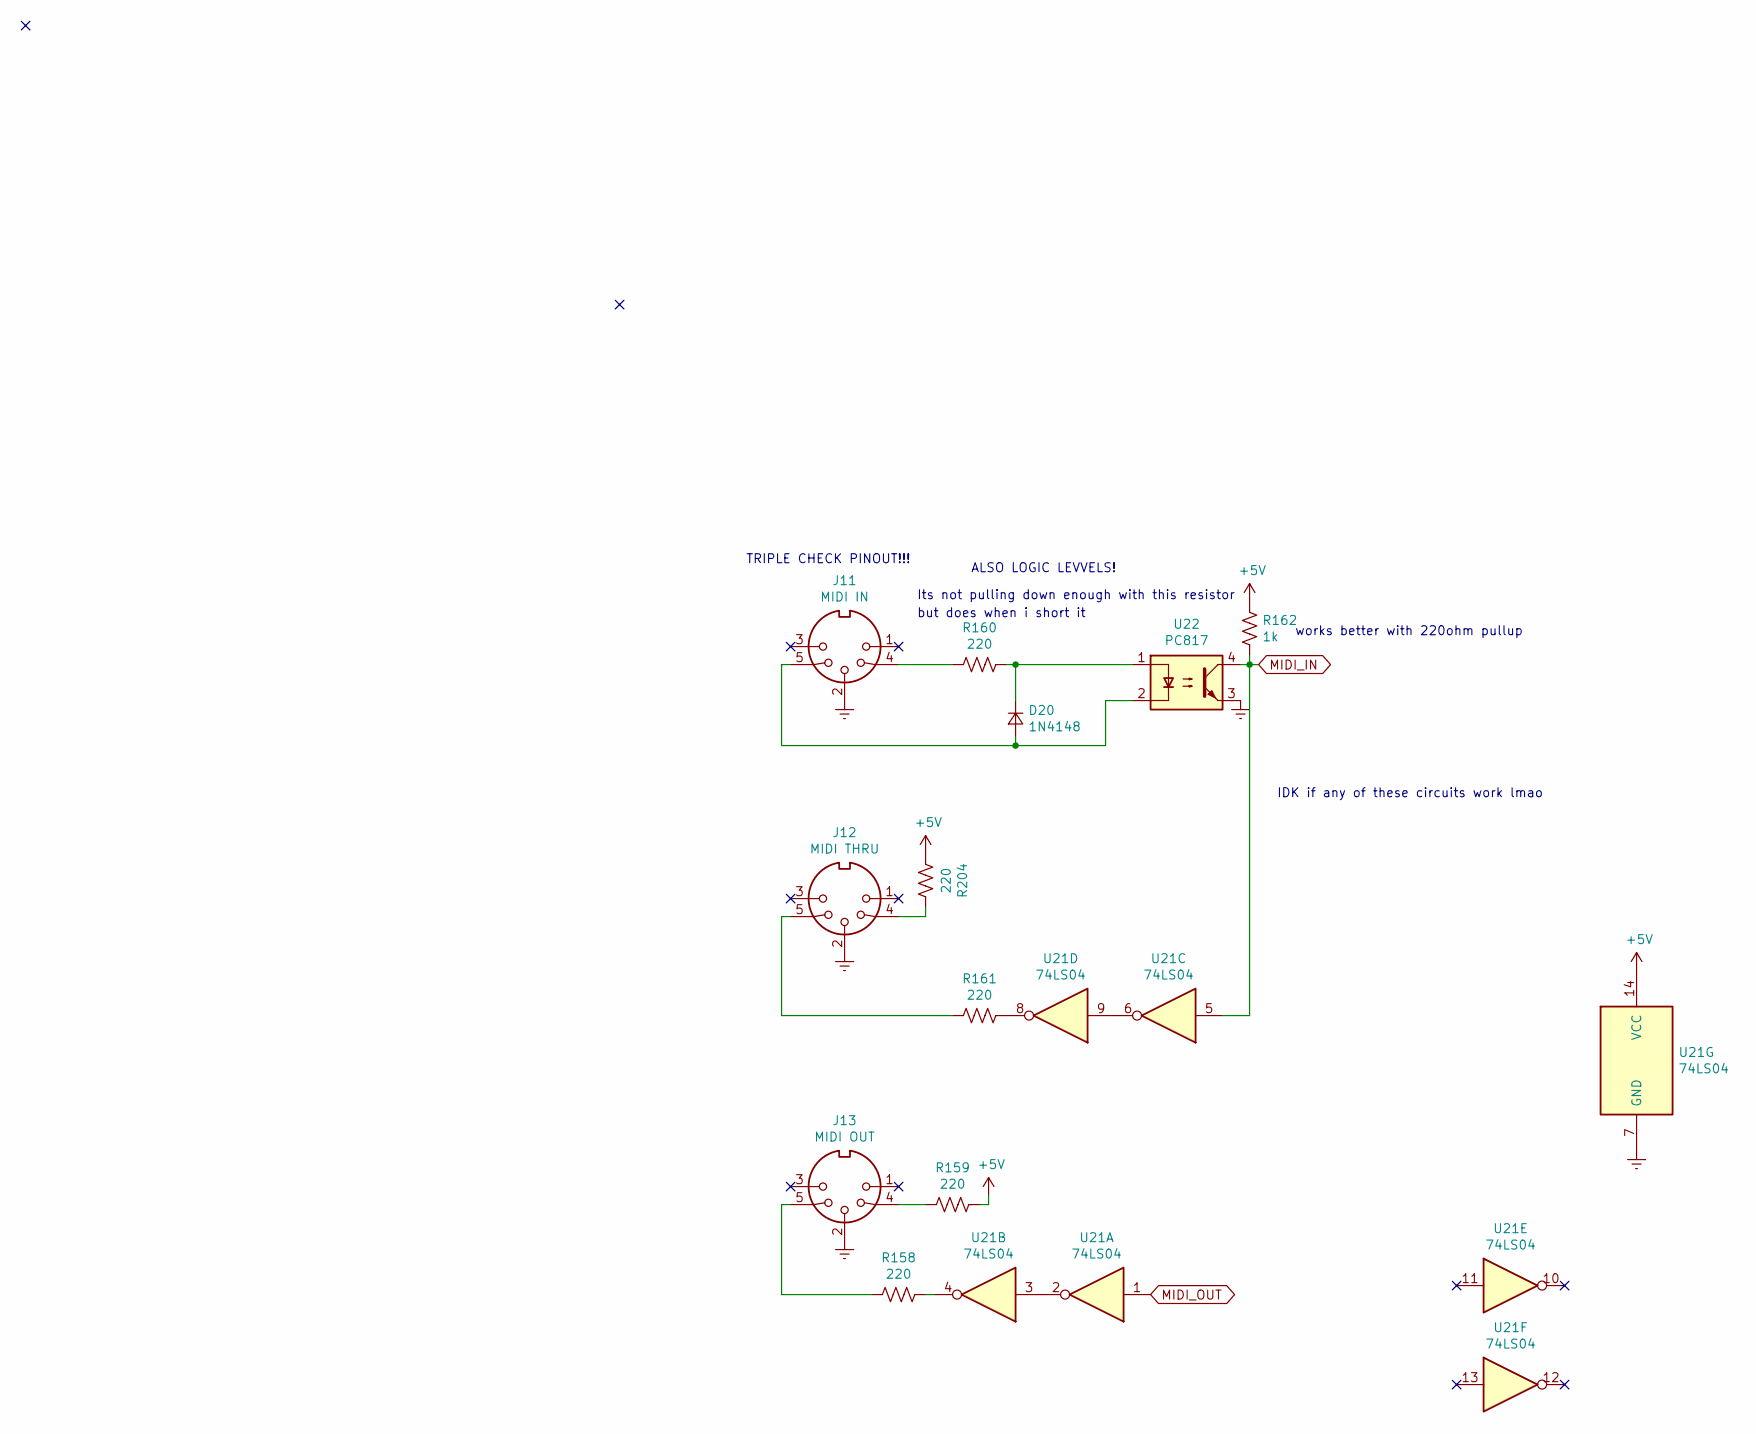
[picture p27: schematic MIDI.sch]

Parts:
D20: 1N4148; D_SOD-123
J11: MIDI IN; DIN5_MIDI
J12: MIDI THRU; DIN5_MIDI
J13: MIDI OUT; DIN5_MIDI
R158, R159, R160, R161, R204: 220; R_0603_1608Metric_Pad1.05x0.95mm_HandSolder
R162: 1k; R_0603_1608Metric_Pad1.05x0.95mm_HandSolder
U21: 74LS04; SOIC-14_3.9x8.7mm_P1.27mm
U22: PC817; DIP-4_W7.62mm

Connections:
+5V: R159.1, R162.2, R204.2, U21.14 (VCC); also elsewhere on the board
Earth: J11.2, J12.2, J13.2, U21.7 (GND), U22.3; also elsewhere on the board
MIDI_IN: R162.1, U21.5, U22.4; also elsewhere on the board
MIDI_OUT: U21.1; also elsewhere on the board
unnamed: D20.1 (K), R160.1, U22.1
unnamed: D20.2 (A), J11.5, U22.2
unnamed: J11.4, R160.2
unnamed: J12.4, R204.1
unnamed: J12.5, R161.2
unnamed: J13.4, R159.2
unnamed: J13.5, R158.2
unnamed: R158.1, U21.4
unnamed: R161.1, U21.8
unnamed: U21.2, U21.3
unnamed: U21.6, U21.9

Notes on the sheet:
TRIPLE CHECK PINOUT!!!
IDK if any of these circuits work lmao
ALSO LOGIC LEVVELS!
Its not pulling down enough with this resistor
but does when i short it
works better with 220ohm pullup
