masonandrewmann/drum_machine/harware_design/DrumMachineControlBoard/DrumMachineControlBoard.kicad_pcb

## KiCad design harware_design/DrumMachineControlBoard/DrumMachineControlBoard.kicad_pcb (continued)

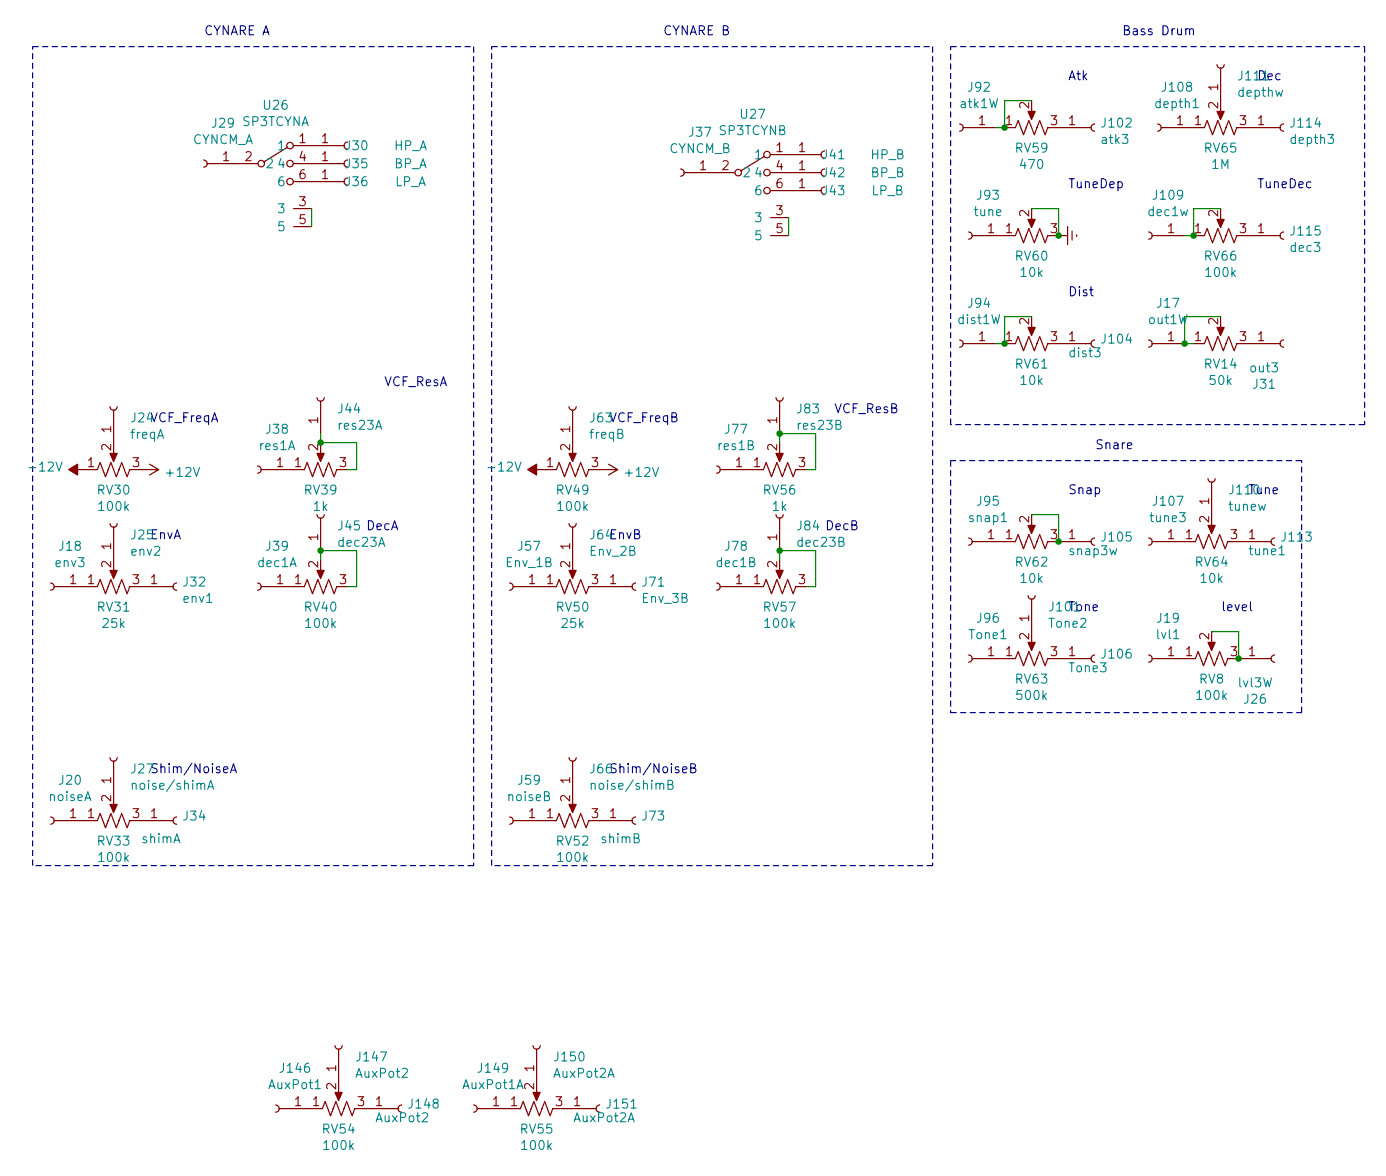
[picture p28: schematic ExternalPots.sch]

Parts:
J17: out1W; SolderWirePad_1x01_Drill1mm
J18: env3; SolderWirePad_1x01_Drill1mm
J19: lvl1; SolderWirePad_1x01_Drill1mm
J20: noiseA; SolderWirePad_1x01_Drill1mm
J24: freqA; SolderWirePad_1x01_Drill1mm
J25: env2; SolderWirePad_1x01_Drill1mm
J26: lvl3W; SolderWirePad_1x01_Drill1mm
J27: noise/shimA; SolderWirePad_1x01_Drill1mm
J29: CYNCM_A; SolderWirePad_1x01_Drill1mm
J30: HP_A; SolderWirePad_1x01_Drill1mm
J31: out3; SolderWirePad_1x01_Drill1mm
J32: env1; SolderWirePad_1x01_Drill1mm
J34: shimA; SolderWirePad_1x01_Drill1mm
J35: BP_A; SolderWirePad_1x01_Drill1mm
J36: LP_A; SolderWirePad_1x01_Drill1mm
J37: CYNCM_B; SolderWirePad_1x01_Drill1mm
J38: res1A; SolderWirePad_1x01_Drill1mm
J39: dec1A; SolderWirePad_1x01_Drill1mm
J41: HP_B; SolderWirePad_1x01_Drill1mm
J42: BP_B; SolderWirePad_1x01_Drill1mm
J43: LP_B; SolderWirePad_1x01_Drill1mm
J44: res23A; SolderWirePad_1x01_Drill1mm
J45: dec23A; SolderWirePad_1x01_Drill1mm
J57: Env_1B; SolderWirePad_1x01_Drill1mm
J59: noiseB; SolderWirePad_1x01_Drill1mm
J63: freqB; SolderWirePad_1x01_Drill1mm
J64: Env_2B; SolderWirePad_1x01_Drill1mm
J66: noise/shimB; SolderWirePad_1x01_Drill1mm
J71: Env_3B; SolderWirePad_1x01_Drill1mm
J73: shimB; SolderWirePad_1x01_Drill1mm
J77: res1B; SolderWirePad_1x01_Drill1mm
J78: dec1B; SolderWirePad_1x01_Drill1mm
J83: res23B; SolderWirePad_1x01_Drill1mm
J84: dec23B; SolderWirePad_1x01_Drill1mm
J92: atk1W; SolderWirePad_1x01_Drill1mm
J93: tune; SolderWirePad_1x01_Drill1mm
J94: dist1W; SolderWirePad_1x01_Drill1mm
J95: snap1; SolderWirePad_1x01_Drill1mm
J96: Tone1; SolderWirePad_1x01_Drill1mm
J101: Tone2; SolderWirePad_1x01_Drill1mm
J102: atk3; SolderWirePad_1x01_Drill1mm
J104: dist3; SolderWirePad_1x01_Drill1mm
J105: snap3w; SolderWirePad_1x01_Drill1mm
J106: Tone3; SolderWirePad_1x01_Drill1mm
J107: tune3; SolderWirePad_1x01_Drill1mm
J108: depth1; SolderWirePad_1x01_Drill1mm
J109: dec1w; SolderWirePad_1x01_Drill1mm
J110: tunew; SolderWirePad_1x01_Drill1mm
J111: depthw; SolderWirePad_1x01_Drill1mm
J113: tune1; SolderWirePad_1x01_Drill1mm
J114: depth3; SolderWirePad_1x01_Drill1mm
J115: dec3; SolderWirePad_1x01_Drill1mm
J146: AuxPot1; SolderWirePad_1x01_Drill1mm
J147, J148: AuxPot2; SolderWirePad_1x01_Drill1mm
J149: AuxPot1A; SolderWirePad_1x01_Drill1mm
J150, J151: AuxPot2A; SolderWirePad_1x01_Drill1mm
RV8, RV30, RV33, RV40, RV49, RV52, RV54, RV55, RV57, RV66: 100k; masonsPotentiometer_Alpha_RD901F-40-00D_Single_Vertical
RV14: 50k; masonsPotentiometer_Alpha_RD901F-40-00D_Single_Vertical
RV31, RV50: 25k; masonsPotentiometer_Alpha_RD901F-40-00D_Single_Vertical
RV39, RV56: 1k; masonsPotentiometer_Alpha_RD901F-40-00D_Single_Vertical
RV59: 470; Amphenol_Trimpot
RV60, RV61, RV62, RV64: 10k; masonsPotentiometer_Alpha_RD901F-40-00D_Single_Vertical
RV63: 500k; masonsPotentiometer_Alpha_RD901F-40-00D_Single_Vertical
RV65: 1M; masonsPotentiometer_Alpha_RD901F-40-00D_Single_Vertical
U26: SP3TCYNA; two-pole-switch
U27: SP3TCYNB; two-pole-switch

Connections:
+12V: RV30.3, RV49.3; also elsewhere on the board
-12V: RV30.1, RV49.1; also elsewhere on the board
Earth: RV60.2, RV60.3; also elsewhere on the board
unnamed: J17.1, RV14.1, RV14.2
unnamed: J18.1, RV31.1
unnamed: J19.1, RV8.1
unnamed: J20.1, RV33.1
unnamed: J24.1, RV30.2
unnamed: J25.1, RV31.2
unnamed: J26.1, RV8.2, RV8.3
unnamed: J27.1, RV33.2
unnamed: J29.1, U26.2
unnamed: J30.1, U26.1
unnamed: J31.1, RV14.3
unnamed: J32.1, RV31.3
unnamed: J34.1, RV33.3
unnamed: J35.1, U26.4
unnamed: J36.1, U26.6
unnamed: J37.1, U27.2
unnamed: J38.1, RV39.1
unnamed: J39.1, RV40.1
unnamed: J41.1, U27.1
unnamed: J42.1, U27.4
unnamed: J43.1, U27.6
unnamed: J44.1, RV39.2, RV39.3
unnamed: J45.1, RV40.2, RV40.3
unnamed: J57.1, RV50.1
unnamed: J59.1, RV52.1
unnamed: J63.1, RV49.2
unnamed: J64.1, RV50.2
unnamed: J66.1, RV52.2
unnamed: J71.1, RV50.3
unnamed: J73.1, RV52.3
unnamed: J77.1, RV56.1
unnamed: J78.1, RV57.1
unnamed: J83.1, RV56.2, RV56.3
unnamed: J84.1, RV57.2, RV57.3
unnamed: J92.1, RV59.1, RV59.2
unnamed: J93.1, RV60.1
unnamed: J94.1, RV61.1, RV61.2
unnamed: J95.1, RV62.1
unnamed: J96.1, RV63.1
unnamed: J101.1, RV63.2
unnamed: J102.1, RV59.3
unnamed: J104.1, RV61.3
unnamed: J105.1, RV62.2, RV62.3
unnamed: J106.1, RV63.3
unnamed: J107.1, RV64.1
unnamed: J108.1, RV65.1
unnamed: J109.1, RV66.1, RV66.2
unnamed: J110.1, RV64.2
unnamed: J111.1, RV65.2
unnamed: J113.1, RV64.3
unnamed: J114.1, RV65.3
unnamed: J115.1, RV66.3
unnamed: J146.1, RV54.1
unnamed: J147.1, RV54.2
unnamed: J148.1, RV54.3
unnamed: J149.1, RV55.1
unnamed: J150.1, RV55.2
unnamed: J151.1, RV55.3
unnamed: U26.3, U26.5
unnamed: U27.3, U27.5

Notes on the sheet:
VCF_FreqA
VCF_ResA
EnvA
DecA
Shim/NoiseA
CYNARE A
VCF_FreqB
VCF_ResB
EnvB
DecB
Shim/NoiseB
CYNARE B
Atk
Dec
TuneDep
TuneDec
Dist
Bass Drum
Snap
Tune
Tone
Snare
level

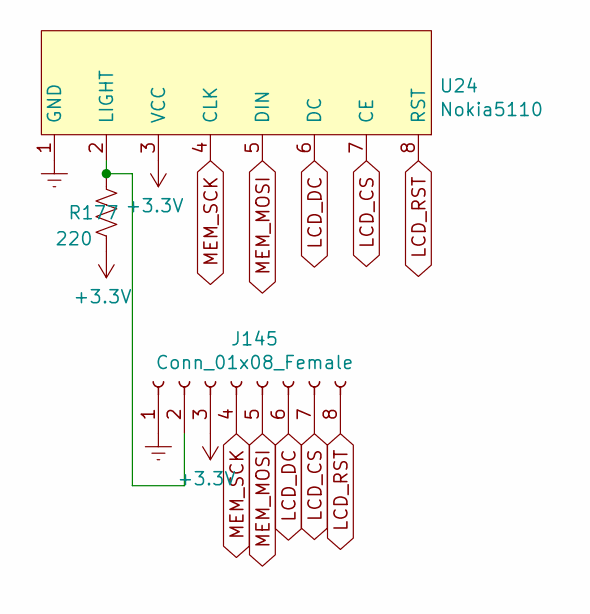
[picture p29: schematic LCD.sch]

Parts:
J145: Conn_01x08_Female; PinSocket_1x08_P2.54mm_Vertical
R177: 220; R_0603_1608Metric_Pad1.05x0.95mm_HandSolder
U24: Nokia5110; Nokia5110Breakout

Connections:
+3V3: J145.3, R177.2, U24.3 (VCC); also elsewhere on the board
Earth: J145.1, U24.1 (GND); also elsewhere on the board
LCD_CS: J145.7, U24.7 (CE); also elsewhere on the board
LCD_DC: J145.6, U24.6 (DC); also elsewhere on the board
LCD_RST: J145.8, U24.8 (RST); also elsewhere on the board
MEM_MOSI: J145.5, U24.5 (DIN)
MEM_SCK: J145.4, U24.4 (CLK); also elsewhere on the board
unnamed: J145.2, R177.1, U24.2 (LIGHT)

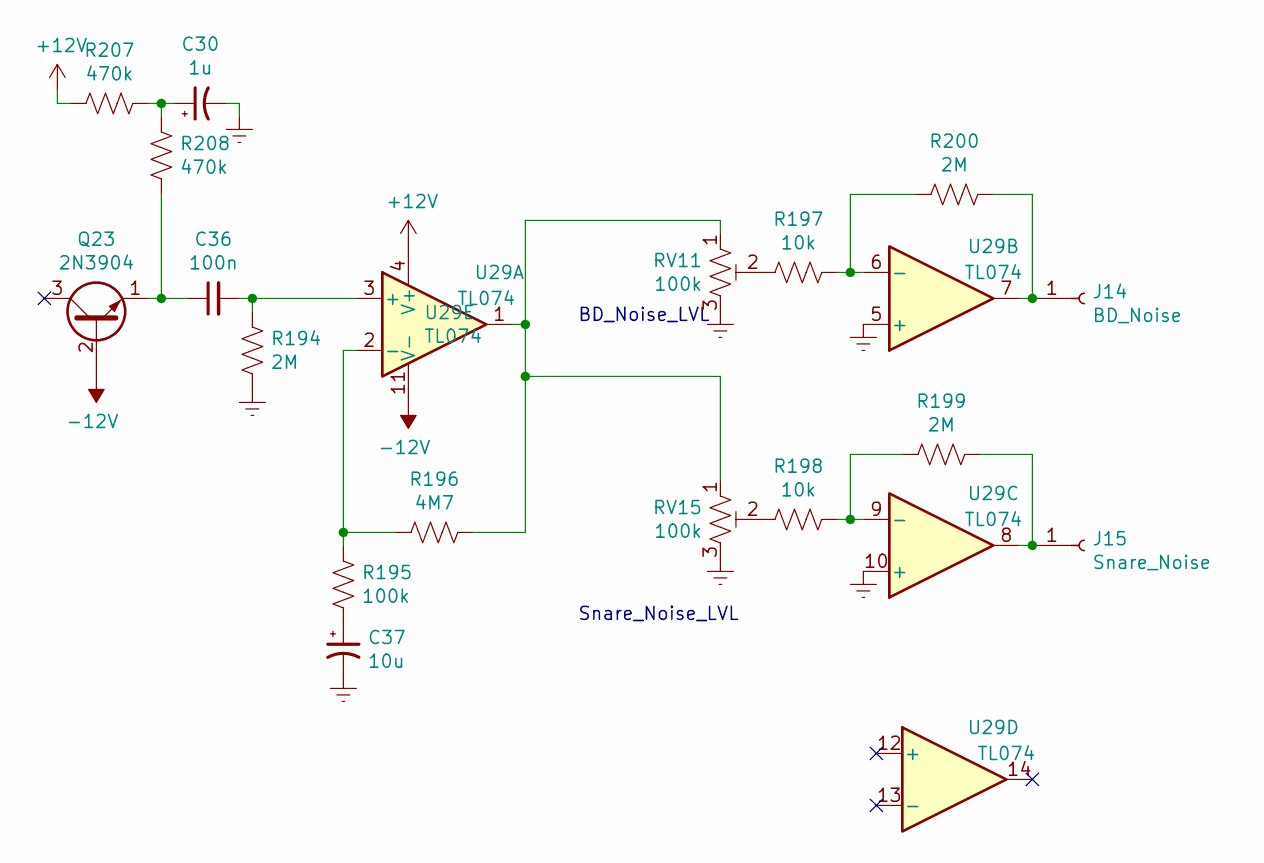
[picture p30: schematic Noise.sch]

Parts:
C30: 1u; CP_Elec_4x4.5
C36: 100n; C_0603_1608Metric_Pad1.05x0.95mm_HandSolder
C37: 10u; CP_Elec_5x5.3
J14: BD_Noise; SolderWirePad_1x01_Drill1mm
J15: Snare_Noise; SolderWirePad_1x01_Drill1mm
Q23: 2N3904; TO-92_Inline_Wide
R194: 2M; R_0603_1608Metric_Pad1.05x0.95mm_HandSolder
R195: 100k; R_0603_1608Metric_Pad1.05x0.95mm_HandSolder
R196: 4M7; R_0603_1608Metric_Pad1.05x0.95mm_HandSolder
R197, R198: 10k; R_0603_1608Metric_Pad1.05x0.95mm_HandSolder
R199, R200: 2M; R_Axial_DIN0207_L6.3mm_D2.5mm_P7.62mm_Horizontal
R207, R208: 470k; R_0603_1608Metric_Pad1.05x0.95mm_HandSolder
RV11, RV15: 100k; Potentiometer_Runtron_RM-065_Vertical
U29: TL074; SOIC-14_3.9x8.7mm_P1.27mm

Connections:
+12V: R207.2, U29.4 (V+); also elsewhere on the board
-12V: Q23.2 (B), U29.11 (V-); also elsewhere on the board
Earth: C30.2, C37.2, R194.2, RV11.3, RV15.3, U29.5 (+), U29.10 (+); also elsewhere on the board
unnamed: C30.1, R207.1, R208.1
unnamed: C36.1, Q23.1 (E), R208.2
unnamed: C36.2, R194.1, U29.3 (+)
unnamed: C37.1, R195.1
unnamed: J14.1, R200.1, U29.7
unnamed: J15.1, R199.1, U29.8
unnamed: R195.2, R196.2, U29.2 (-)
unnamed: R196.1, RV11.1, RV15.1, U29.1
unnamed: R197.1, R200.2, U29.6 (-)
unnamed: R197.2, RV11.2
unnamed: R198.1, R199.2, U29.9 (-)
unnamed: R198.2, RV15.2

Notes on the sheet:
BD_Noise_LVL
Snare_Noise_LVL

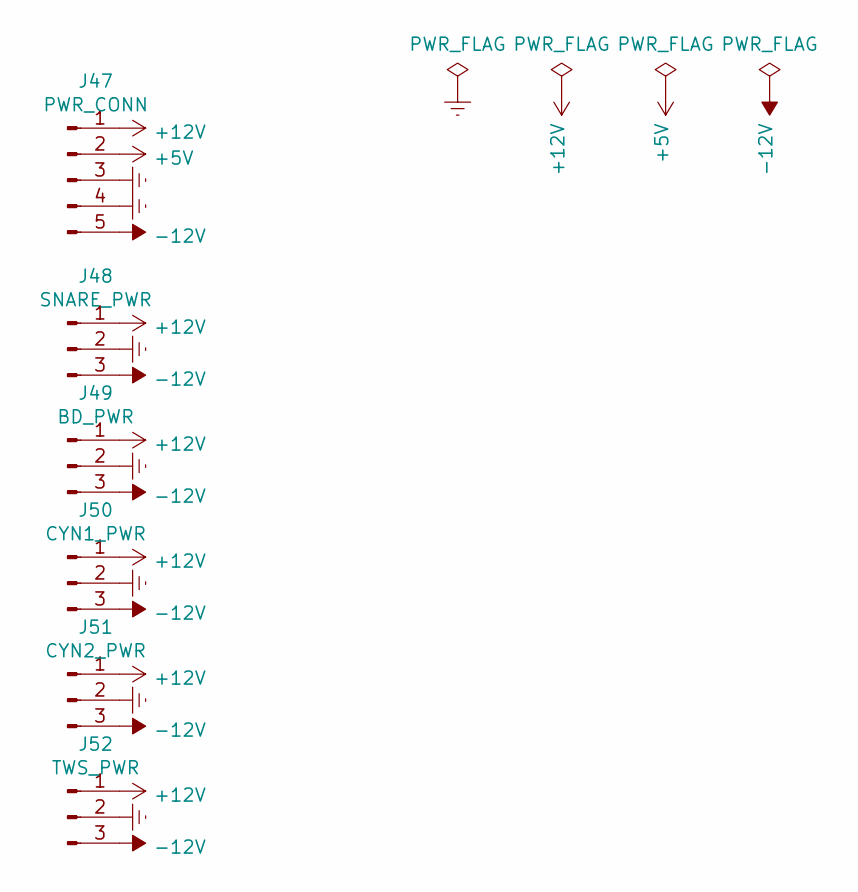
[picture p31: schematic power_conns.sch]

Parts:
J47: PWR_CONN; JST_XH_B5B-XH-A_1x05_P2.50mm_Vertical
J48: SNARE_PWR; JST_XH_B3B-XH-A_1x03_P2.50mm_Vertical
J49: BD_PWR; JST_XH_B3B-XH-A_1x03_P2.50mm_Vertical
J50: CYN1_PWR; JST_XH_B3B-XH-A_1x03_P2.50mm_Vertical
J51: CYN2_PWR; JST_XH_B3B-XH-A_1x03_P2.50mm_Vertical
J52: TWS_PWR; JST_XH_B3B-XH-A_1x03_P2.50mm_Vertical

Connections:
+5V: J47.2; also elsewhere on the board
+12V: J47.1, J48.1, J49.1, J50.1, J51.1, J52.1; also elsewhere on the board
-12V: J47.5, J48.3, J49.3, J50.3, J51.3, J52.3; also elsewhere on the board
Earth: J47.3, J47.4, J48.2, J49.2, J50.2, J51.2, J52.2; also elsewhere on the board

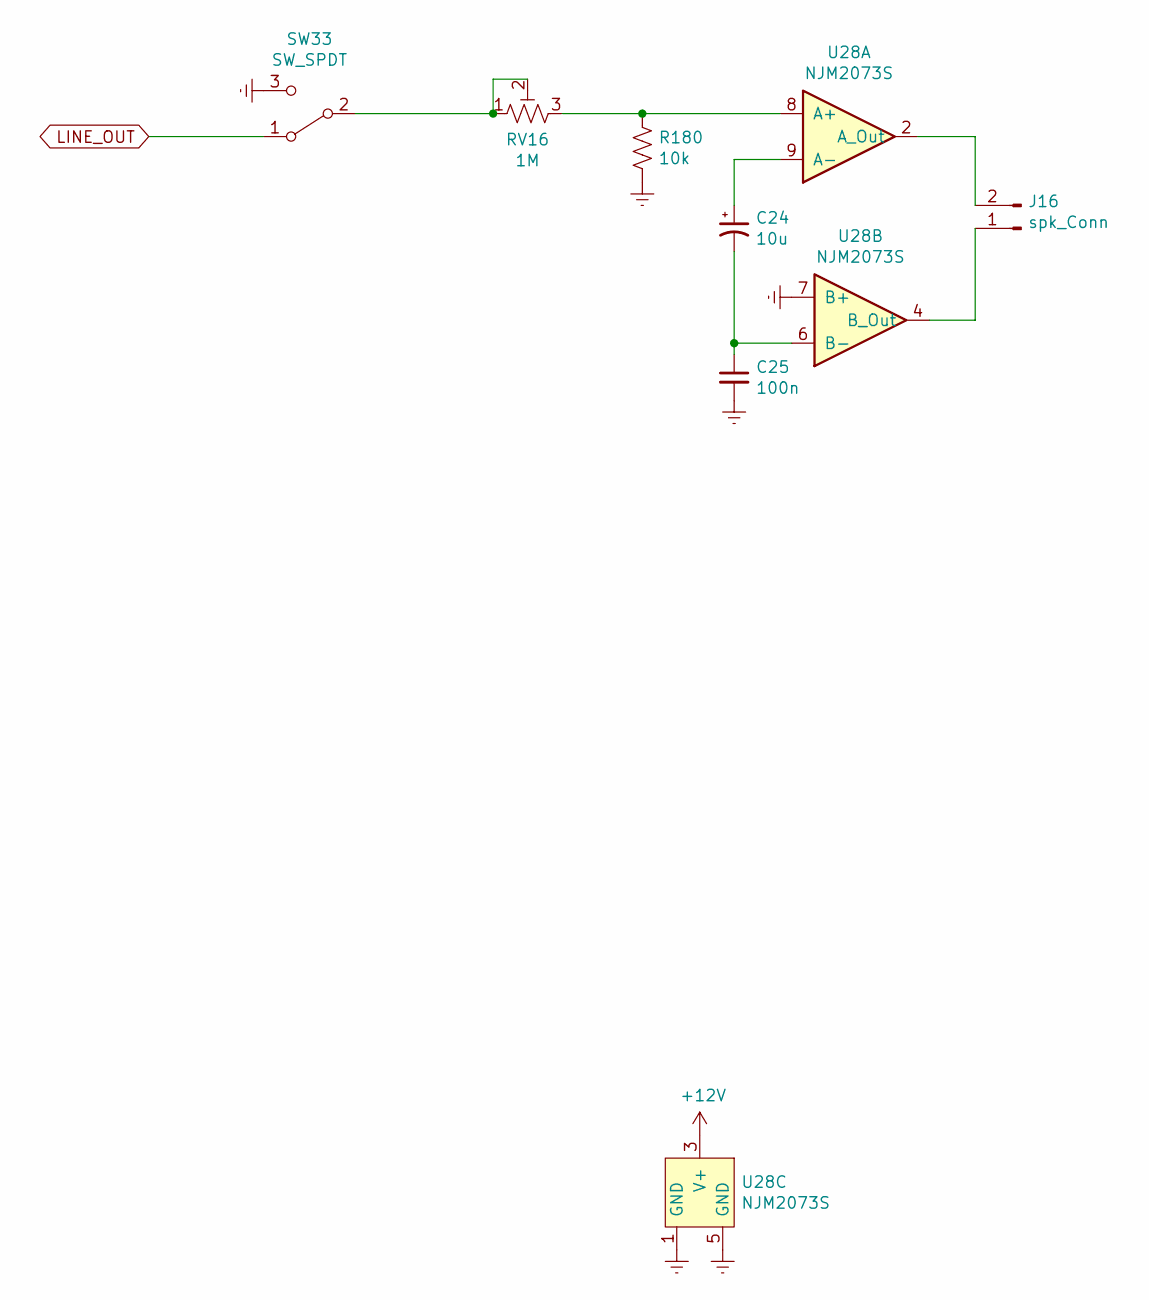
[picture p32: schematic SpeakerAmp.sch]

Parts:
C24: 10u; CP_Elec_5x5.3
C25: 100n; C_0603_1608Metric_Pad1.05x0.95mm_HandSolder
J16: spk_Conn; JST_XH_B2B-XH-A_1x02_P2.50mm_Vertical
R180: 10k; R_0603_1608Metric_Pad1.05x0.95mm_HandSolder
RV16: 1M; Potentiometer_Runtron_RM-065_Vertical
SW33: SW_SPDT; one-pole-switch
U28: NJM2073S; SIP-9_21.54x3mm_P2.54mm

Connections:
+12V: U28.3 (V+); also elsewhere on the board
Earth: C25.2, R180.1, SW33.3 (C), U28.1 (GND), U28.5 (GND), U28.7 (B+); also elsewhere on the board
LINE_OUT: SW33.1 (A); also elsewhere on the board
unnamed: C24.1, U28.9 (A-)
unnamed: C24.2, C25.1, U28.6 (B-)
unnamed: J16.1, U28.4 (B_Out)
unnamed: J16.2, U28.2 (A_Out)
unnamed: R180.2, RV16.3, U28.8 (A+)
unnamed: RV16.1, RV16.2, SW33.2 (B)

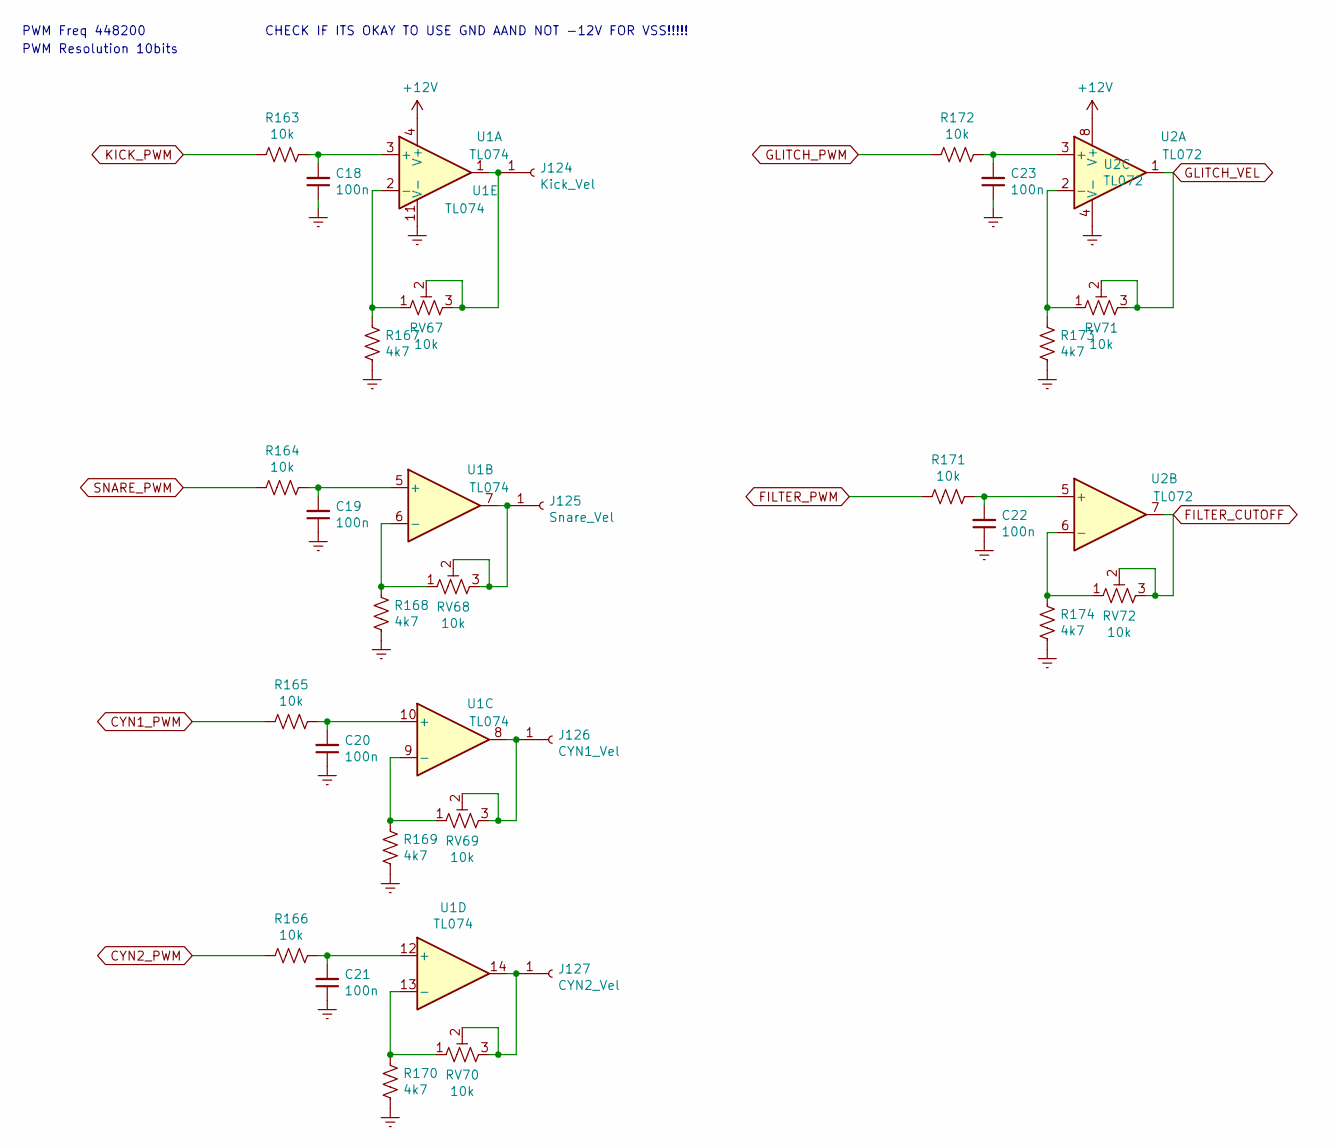
[picture p33: schematic PWM Out.sch]

Parts:
C18, C19, C20, C21, C22, C23: 100n; C_0603_1608Metric_Pad1.05x0.95mm_HandSolder
J124: Kick_Vel; SolderWirePad_1x01_Drill1mm
J125: Snare_Vel; SolderWirePad_1x01_Drill1mm
J126: CYN1_Vel; SolderWirePad_1x01_Drill1mm
J127: CYN2_Vel; SolderWirePad_1x01_Drill1mm
R163, R164, R165, R166, R171, R172: 10k; R_0603_1608Metric_Pad1.05x0.95mm_HandSolder
R167, R168, R169, R170, R173, R174: 4k7; R_0603_1608Metric_Pad1.05x0.95mm_HandSolder
RV67, RV68, RV69, RV70, RV71, RV72: 10k; Potentiometer_Runtron_RM-065_Vertical
U1: TL074; SOIC-14_3.9x8.7mm_P1.27mm
U2: TL072; SOIC-8_3.9x4.9mm_P1.27mm

Connections:
+12V: U1.4 (V+), U2.8 (V+); also elsewhere on the board
CYN1_PWM: R165.2; also elsewhere on the board
CYN2_PWM: R166.2; also elsewhere on the board
Earth: C18.1, C19.1, C20.1, C21.1, C22.1, C23.1, R167.1, R168.1, R169.1, R170.1, R173.1, R174.1, U1.11 (V-), U2.4 (V-); also elsewhere on the board
FILTER_CUTOFF: RV72.2, RV72.3, U2.7; also elsewhere on the board
FILTER_PWM: R171.2; also elsewhere on the board
GLITCH_PWM: R172.2; also elsewhere on the board
GLITCH_VEL: RV71.2, RV71.3, U2.1; also elsewhere on the board
KICK_PWM: R163.2; also elsewhere on the board
unnamed: C18.2, R163.1, U1.3 (+)
unnamed: C19.2, R164.1, U1.5 (+)
unnamed: C20.2, R165.1, U1.10 (+)
unnamed: C21.2, R166.1, U1.12 (+)
unnamed: C22.2, R171.1, U2.5 (+)
unnamed: C23.2, R172.1, U2.3 (+)
unnamed: J124.1, RV67.2, RV67.3, U1.1
unnamed: J125.1, RV68.2, RV68.3, U1.7
unnamed: J126.1, RV69.2, RV69.3, U1.8
unnamed: J127.1, RV70.2, RV70.3, U1.14
unnamed: R167.2, RV67.1, U1.2 (-)
unnamed: R168.2, RV68.1, U1.6 (-)
unnamed: R169.2, RV69.1, U1.9 (-)
unnamed: R170.2, RV70.1, U1.13 (-)
unnamed: R173.2, RV71.1, U2.2 (-)
unnamed: R174.2, RV72.1, U2.6 (-)
SNARE_PWM: R164.2; also elsewhere on the board

Notes on the sheet:
PWM Freq 448200
PWM Resolution 10bits
CHECK IF ITS OKAY TO USE GND AAND NOT -12V FOR VSS!!!!!

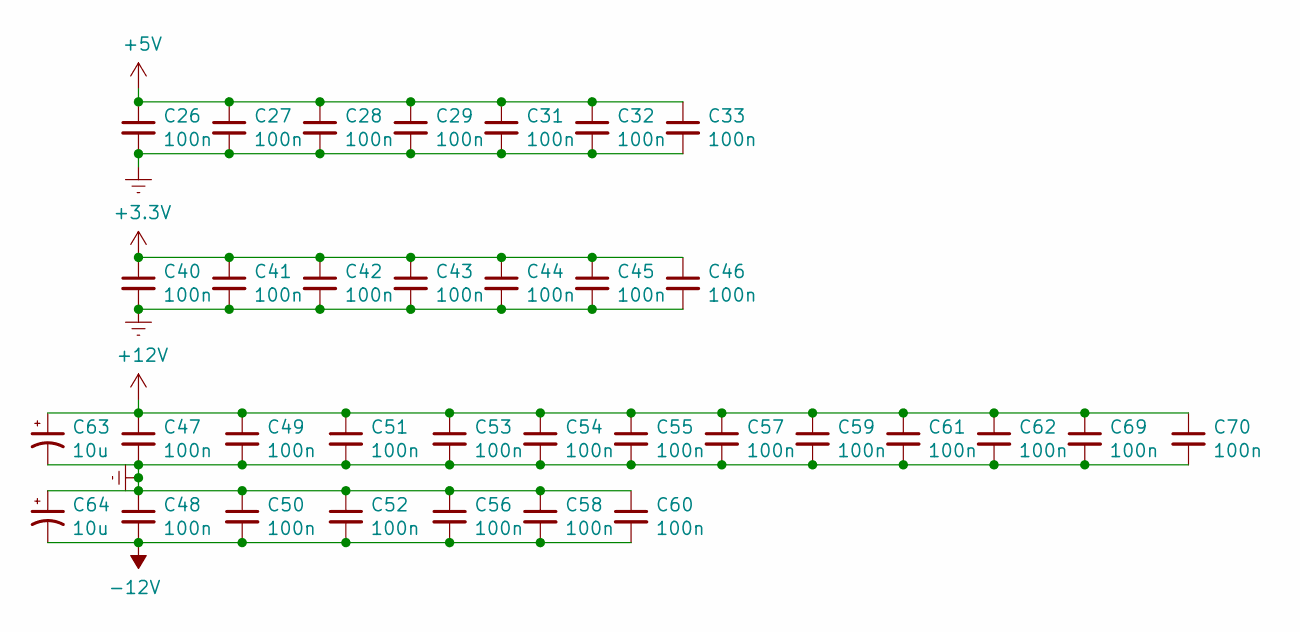
[picture p34: schematic Decoupling.sch]

Parts:
C26, C27, C28, C29, C31, C32, C33, C40, C41, C42, C43, C44, C45, C46, C47, C48, C49, C50, C51, C52, C53, C54, C55, C56, C57, C58, C59, C60, C61, C62, C69, C70: 100n; C_0603_1608Metric_Pad1.05x0.95mm_HandSolder
C63, C64: 10u; CP_Elec_5x5.3

Connections:
+3V3: C40.1, C41.1, C42.1, C43.1, C44.1, C45.1, C46.1; also elsewhere on the board
+5V: C26.1, C27.1, C28.1, C29.1, C31.1, C32.1, C33.1; also elsewhere on the board
+12V: C47.1, C49.1, C51.1, C53.1, C54.1, C55.1, C57.1, C59.1, C61.1, C62.1, C63.1, C69.1, C70.1; also elsewhere on the board
-12V: C48.2, C50.2, C52.2, C56.2, C58.2, C60.2, C64.2; also elsewhere on the board
Earth: C26.2, C27.2, C28.2, C29.2, C31.2, C32.2, C33.2, C40.2, C41.2, C42.2, C43.2, C44.2, C45.2, C46.2, C47.2, C48.1, C49.2, C50.1, C51.2, C52.1, C53.2, C54.2, C55.2, C56.1, C57.2, C58.1, C59.2, C60.1, C61.2, C62.2, C63.2, C64.1, C69.2, C70.2; also elsewhere on the board

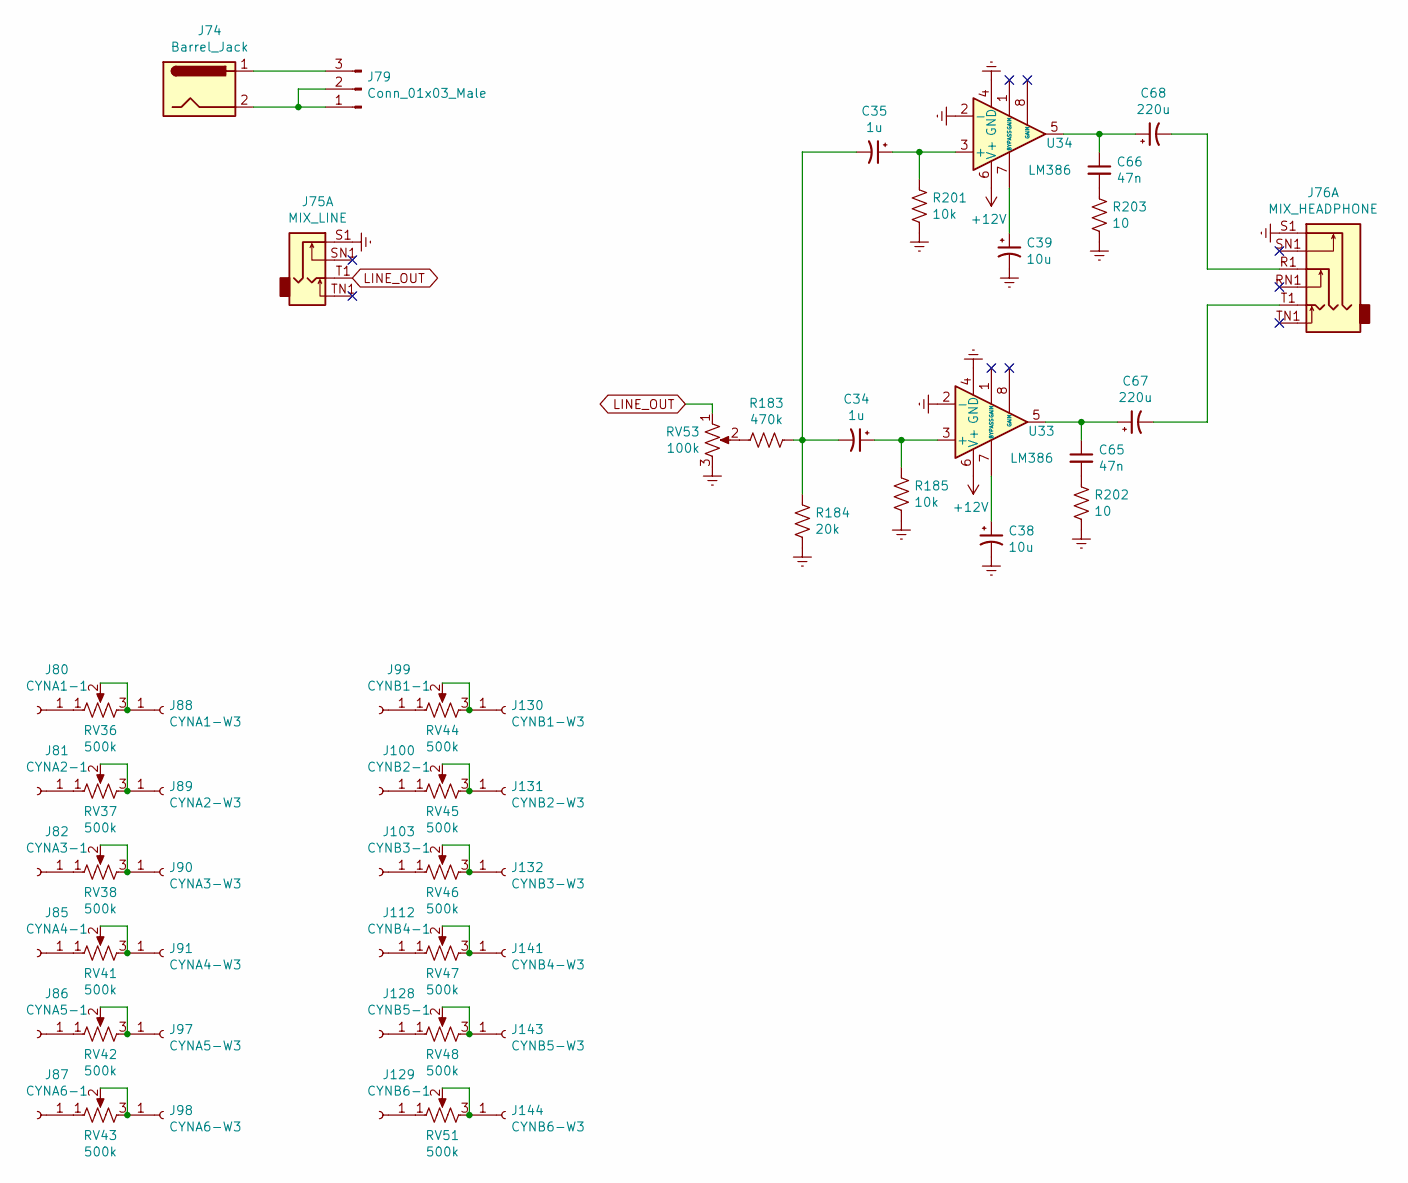
[picture p35: schematic JackPanel.sch]

Parts:
C34, C35: 1u; CP_Elec_4x4.5
C38, C39: 10u; CP_Elec_5x5.3
C65, C66: 47n; C_0603_1608Metric_Pad1.05x0.95mm_HandSolder
C67, C68: 220u; CP_Radial_D5.0mm_P2.0mm_Bigger_Holes
J74: Barrel_Jack; BarrelJack_Horizontal
J75: MIX_LINE; NMJ4HFD2
J76: MIX_HEADPHONE; NRJ6HH-AU
J79: Conn_01x03_Male; JST_XH_B3B-XH-A_1x03_P2.50mm_Vertical
J80: CYNA1-1; SolderWirePad_1x01_Drill1mm
J81: CYNA2-1; SolderWirePad_1x01_Drill1mm
J82: CYNA3-1; SolderWirePad_1x01_Drill1mm
J85: CYNA4-1; SolderWirePad_1x01_Drill1mm
J86: CYNA5-1; SolderWirePad_1x01_Drill1mm
J87: CYNA6-1; SolderWirePad_1x01_Drill1mm
J88: CYNA1-W3; SolderWirePad_1x01_Drill1mm
J89: CYNA2-W3; SolderWirePad_1x01_Drill1mm
J90: CYNA3-W3; SolderWirePad_1x01_Drill1mm
J91: CYNA4-W3; SolderWirePad_1x01_Drill1mm
J97: CYNA5-W3; SolderWirePad_1x01_Drill1mm
J98: CYNA6-W3; SolderWirePad_1x01_Drill1mm
J99: CYNB1-1; SolderWirePad_1x01_Drill1mm
J100: CYNB2-1; SolderWirePad_1x01_Drill1mm
J103: CYNB3-1; SolderWirePad_1x01_Drill1mm
J112: CYNB4-1; SolderWirePad_1x01_Drill1mm
J128: CYNB5-1; SolderWirePad_1x01_Drill1mm
J129: CYNB6-1; SolderWirePad_1x01_Drill1mm
J130: CYNB1-W3; SolderWirePad_1x01_Drill1mm
J131: CYNB2-W3; SolderWirePad_1x01_Drill1mm
J132: CYNB3-W3; SolderWirePad_1x01_Drill1mm
J141: CYNB4-W3; SolderWirePad_1x01_Drill1mm
J143: CYNB5-W3; SolderWirePad_1x01_Drill1mm
J144: CYNB6-W3; SolderWirePad_1x01_Drill1mm
R183: 470k; R_0603_1608Metric_Pad1.05x0.95mm_HandSolder
R184: 20k; R_0603_1608Metric_Pad1.05x0.95mm_HandSolder
R185, R201: 10k; R_0603_1608Metric_Pad1.05x0.95mm_HandSolder
R202, R203: 10; R_0603_1608Metric_Pad1.05x0.95mm_HandSolder
RV36, RV37, RV38, RV41, RV42, RV43, RV44, RV45, RV46, RV47, RV48, RV51: 500k; masonsPotentiometer_Alpha_RD901F-40-00D_Single_Vertical
RV53: 100k; masonsPotentiometer_Alpha_RD901F-40-00D_Single_Vertical
U33, U34: LM386; DIP-8_W7.62mm_Socket

Connections:
+12V: U33.6 (V+), U34.6 (V+); also elsewhere on the board
Earth: C38.2, C39.2, J75.S1, J76.S1, R184.1, R185.2, R201.2, R202.2, R203.2, RV53.3, U33.2 (-), U33.4 (GND), U34.2 (-), U34.4 (GND); also elsewhere on the board
LINE_OUT: J75.T1, RV53.1; also elsewhere on the board
unnamed: C34.1, R185.1, U33.3 (+)
unnamed: C34.2, C35.2, R183.1, R184.2
unnamed: C35.1, R201.1, U34.3 (+)
unnamed: C38.1, U33.7 (BYPASS)
unnamed: C39.1, U34.7 (BYPASS)
unnamed: C65.1, C67.1, U33.5
unnamed: C65.2, R202.1
unnamed: C66.1, C68.1, U34.5
unnamed: C66.2, R203.1
unnamed: C67.2, J76.T1
unnamed: C68.2, J76.R1
unnamed: J74.1, J79.3
unnamed: J74.2, J79.1, J79.2
unnamed: J80.1, RV36.1
unnamed: J81.1, RV37.1
unnamed: J82.1, RV38.1
unnamed: J85.1, RV41.1
unnamed: J86.1, RV42.1
unnamed: J87.1, RV43.1
unnamed: J88.1, RV36.2, RV36.3
unnamed: J89.1, RV37.2, RV37.3
unnamed: J90.1, RV38.2, RV38.3
unnamed: J91.1, RV41.2, RV41.3
unnamed: J97.1, RV42.2, RV42.3
unnamed: J98.1, RV43.2, RV43.3
unnamed: J99.1, RV44.1
unnamed: J100.1, RV45.1
unnamed: J103.1, RV46.1
unnamed: J112.1, RV47.1
unnamed: J128.1, RV48.1
unnamed: J129.1, RV51.1
unnamed: J130.1, RV44.2, RV44.3
unnamed: J131.1, RV45.2, RV45.3
unnamed: J132.1, RV46.2, RV46.3
unnamed: J141.1, RV47.2, RV47.3
unnamed: J143.1, RV48.2, RV48.3
unnamed: J144.1, RV51.2, RV51.3
unnamed: R183.2, RV53.2

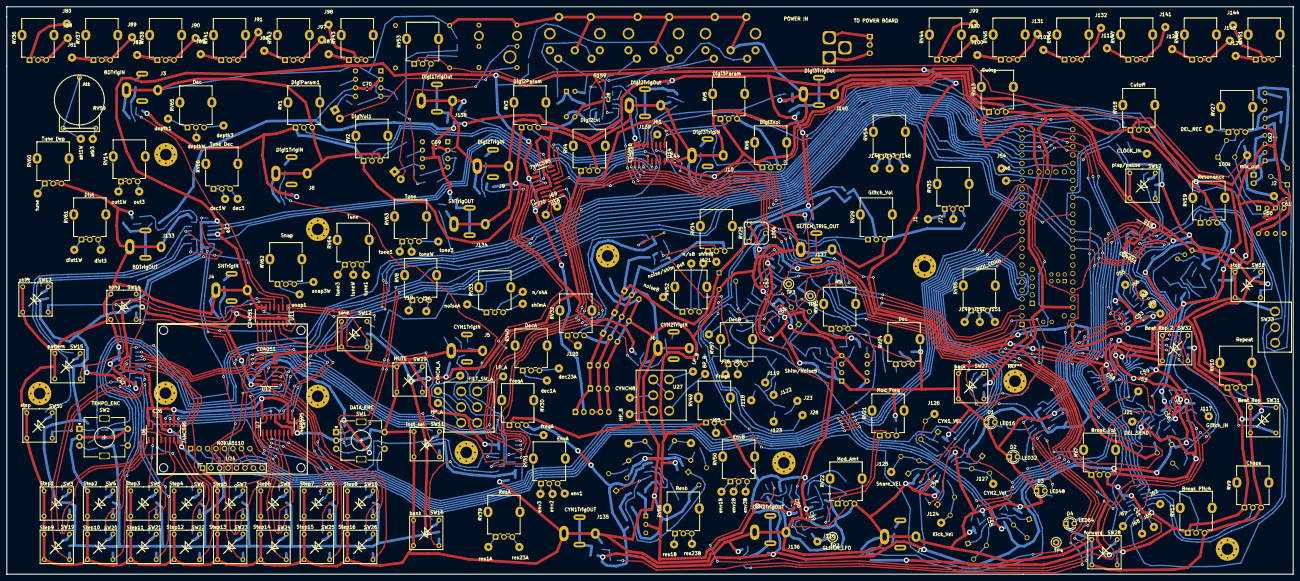
[picture p36: board DrumMachineControlBoard.kicad_pcb from above]

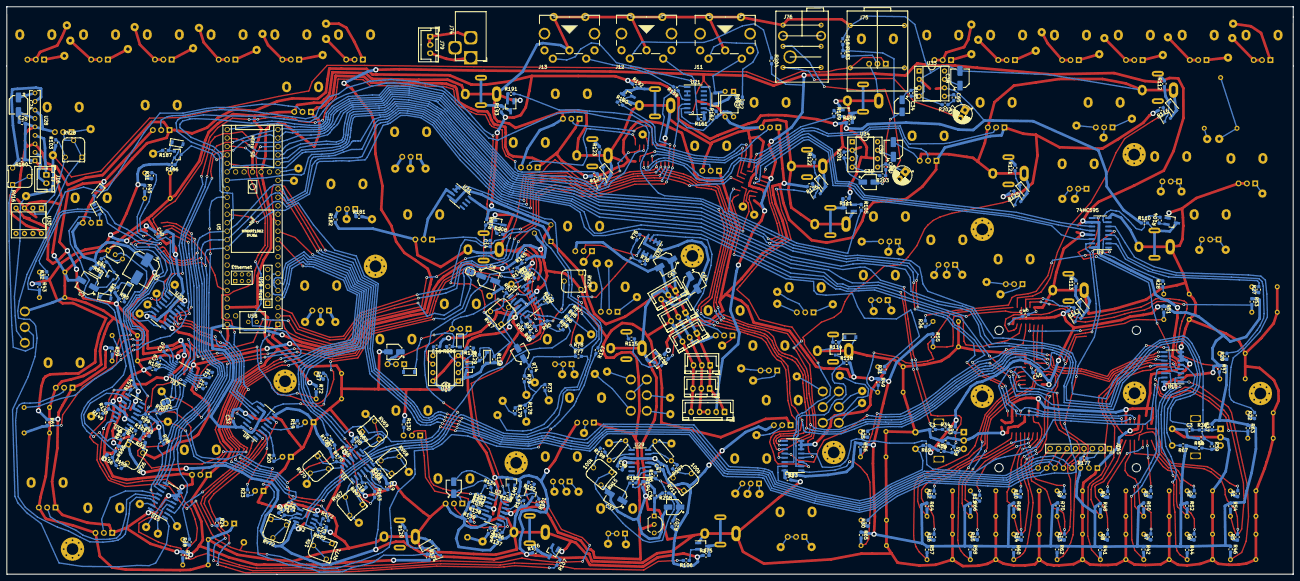
[picture p37: board DrumMachineControlBoard.kicad_pcb from below]

Board: 2 copper layers, 385.8 x 170.2 mm, 616 parts (348 on the bottom side), 459 nets.
