masonandrewmann/drum_machine/harware_design/ALTERNATEDrumMachinePower/ALTERNATEDrumMachinePower.kicad_pcb

## KiCad design harware_design/ALTERNATEDrumMachinePower/ALTERNATEDrumMachinePower.kicad_pcb (2022-11-15)

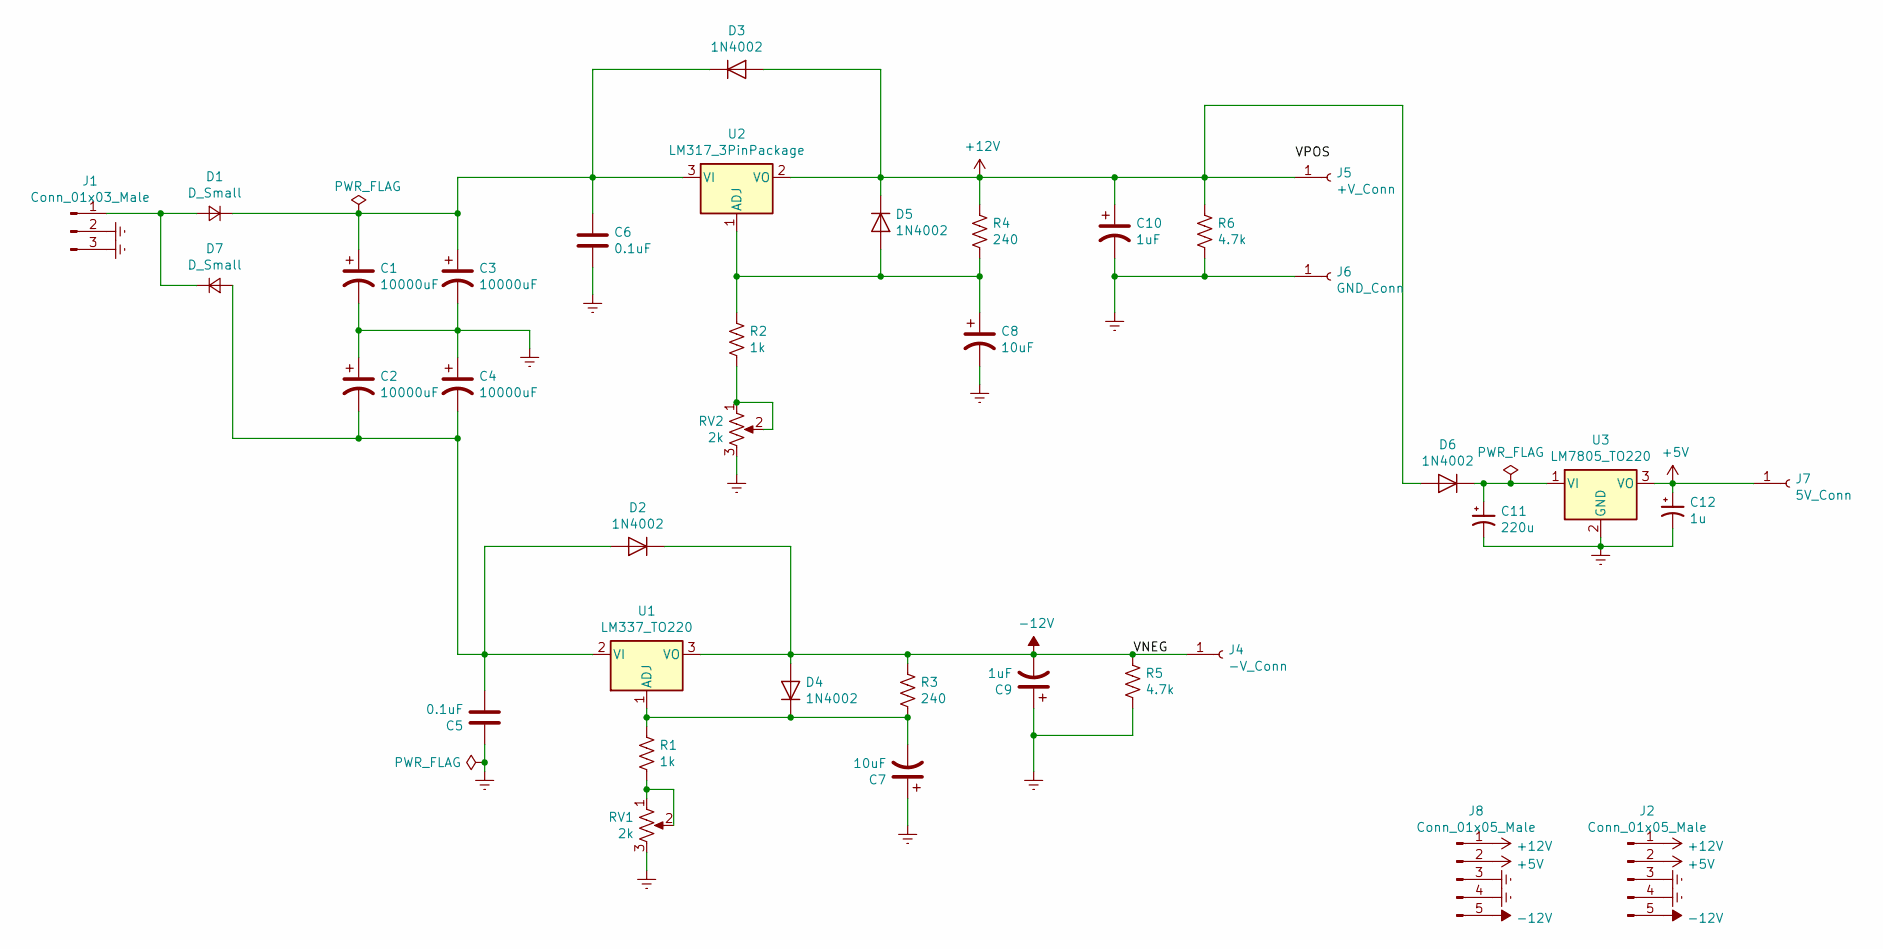
[picture p38: schematic ALTERNATEDrumMachinePower.sch, LM337/LM317 Adj. Voltage Power Supply]

Parts:
C1, C2, C3, C4: 10000uF; CP_Radial_D30.0mm_P10.00mm_SnapIn
C5, C6: 0.1uF; C_Rect_L7.0mm_W2.5mm_P5.00mm
C7, C8: 10uF; CP_Radial_D5.0mm_P2.0mm_Bigger_Holes
C9, C10: 1uF; CP_Radial_D5.0mm_P2.0mm_Bigger_Holes
C11: 220u; CP_Radial_D5.0mm_P2.0mm_Bigger_Holes
C12: 1u; CP_Radial_D5.0mm_P2.0mm_Bigger_Holes
D1, D7: D_Small; D_DO-41_SOD81_P10.16mm_Horizontal
D2, D3, D4, D5, D6: 1N4002; D_DO-41_SOD81_P10.16mm_Horizontal
J1: Conn_01x03_Male; JST_XH_B3B-XH-A_1x03_P2.50mm_Vertical
J2, J8: Conn_01x05_Male; JST_XH_B5B-XH-A_1x05_P2.50mm_Vertical
J4: -V_Conn; Pin_D1.1mm_L10.2mm_W3.5mm_Flat
J5: +V_Conn; Pin_D1.1mm_L10.2mm_W3.5mm_Flat
J6: GND_Conn; Pin_D1.1mm_L10.2mm_W3.5mm_Flat
J7: 5V_Conn; Pin_D1.1mm_L10.2mm_W3.5mm_Flat
R1, R2: 1k; R_Axial_DIN0207_L6.3mm_D2.5mm_P7.62mm_Horizontal
R3, R4: 240; R_Axial_DIN0207_L6.3mm_D2.5mm_P7.62mm_Horizontal
R5, R6: 4.7k; R_Axial_DIN0207_L6.3mm_D2.5mm_P7.62mm_Horizontal
RV1, RV2: 2k; Potentiometer_Runtron_RM-065_Vertical
U1: LM337_TO220; TO-220-3_Vertical
U2: LM317_3PinPackage; TO-220-3_Vertical
U3: LM7805_TO220; TO-220-3_Vertical

Connections:
+5V: C12.1, J2.2, J7.1, J8.2, U3.3 (VO)
+12V: C10.1, D3.2 (A), D5.1 (K), D6.2 (A), J2.1, J5.1, J8.1, R4.1, R6.1, U2.2 (VO)
-12V: C9.2, D2.1 (K), D4.2 (A), J2.5, J4.1, J8.5, R3.1, R5.1, U1.3 (VO)
Earth: C1.2, C2.1, C3.2, C4.1, C5.1, C6.2, C7.1, C8.2, C9.1, C10.2, C11.2, C12.2, J1.2, J1.3, J2.3, J2.4, J6.1, J8.3, J8.4, R5.2, R6.2, RV1.3, RV2.3, U3.2 (GND)
unnamed: C1.1, C3.1, C6.1, D1.1 (K), D3.1 (K), U2.3 (VI)
unnamed: C2.2, C4.2, C5.2, D2.2 (A), D7.2 (A), U1.2 (VI)
unnamed: C7.2, D4.1 (K), R1.1, R3.2, U1.1 (ADJ)
unnamed: C8.1, D5.2 (A), R2.1, R4.2, U2.1 (ADJ)
unnamed: C11.1, D6.1 (K), U3.1 (VI)
unnamed: D1.2 (A), D7.1 (K), J1.1
unnamed: R1.2, RV1.1, RV1.2
unnamed: R2.2, RV2.1, RV2.2
