masonandrewmann/drum_machine/harware_design/ALTERNATEDrumMachinePower/ALTERNATEDrumMachinePower.kicad_pcb

## KiCad design harware_design/ALTERNATEDrumMachinePower/ALTERNATEDrumMachinePower.kicad_pcb (continued)

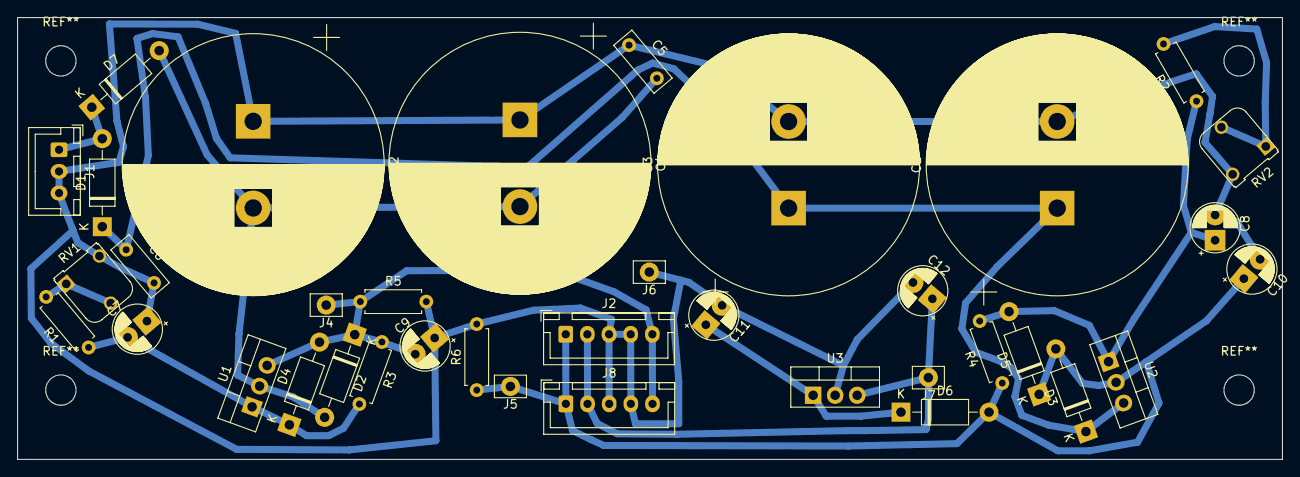
[picture p39: board ALTERNATEDrumMachinePower.kicad_pcb from above]

Board: 2 copper layers, 146.0 x 51.0 mm, 37 parts (0 on the bottom side), 12 nets.
