masonandrewmann/drum_machine/software_design/drum_machine/Pattern.h

class Pattern
{
public:
  int32_t pattern[24][64] = {
      // array of active steps for each instrument
      {0, 0, 0, 0, 0, 0, 0, 0, 0, 0, 0, 0, 0, 0, 0, 0, 0, 0, 0, 0, 0, 0, 0, 0, 0, 0, 0, 0, 0, 0, 0, 0, 0, 0, 0, 0, 0, 0, 0, 0, 0, 0, 0, 0, 0, 0, 0, 0, 0, 0, 0, 0, 0, 0, 0, 0, 0, 0, 0, 0, 0, 0, 0, 0}, // 0 - BD
      {0, 0, 0, 0, 0, 0, 0, 0, 0, 0, 0, 0, 0, 0, 0, 0, 0, 0, 0, 0, 0, 0, 0, 0, 0, 0, 0, 0, 0, 0, 0, 0, 0, 0, 0, 0, 0, 0, 0, 0, 0, 0, 0, 0, 0, 0, 0, 0, 0, 0, 0, 0, 0, 0, 0, 0, 0, 0, 0, 0, 0, 0, 0, 0}, // 1 - S
      {0, 0, 0, 0, 0, 0, 0, 0, 0, 0, 0, 0, 0, 0, 0, 0, 0, 0, 0, 0, 0, 0, 0, 0, 0, 0, 0, 0, 0, 0, 0, 0, 0, 0, 0, 0, 0, 0, 0, 0, 0, 0, 0, 0, 0, 0, 0, 0, 0, 0, 0, 0, 0, 0, 0, 0, 0, 0, 0, 0, 0, 0, 0, 0}, // 2 - CYN1
      {0, 0, 0, 0, 0, 0, 0, 0, 0, 0, 0, 0, 0, 0, 0, 0, 0, 0, 0, 0, 0, 0, 0, 0, 0, 0, 0, 0, 0, 0, 0, 0, 0, 0, 0, 0, 0, 0, 0, 0, 0, 0, 0, 0, 0, 0, 0, 0, 0, 0, 0, 0, 0, 0, 0, 0, 0, 0, 0, 0, 0, 0, 0, 0}, // 3 - CYN2
      {0, 0, 0, 0, 0, 0, 0, 0, 0, 0, 0, 0, 0, 0, 0, 0, 0, 0, 0, 0, 0, 0, 0, 0, 0, 0, 0, 0, 0, 0, 0, 0, 0, 0, 0, 0, 0, 0, 0, 0, 0, 0, 0, 0, 0, 0, 0, 0, 0, 0, 0, 0, 0, 0, 0, 0, 0, 0, 0, 0, 0, 0, 0, 0}, // 4 - GLITCH
      {0, 0, 0, 0, 0, 0, 0, 0, 0, 0, 0, 0, 0, 0, 0, 0, 0, 0, 0, 0, 0, 0, 0, 0, 0, 0, 0, 0, 0, 0, 0, 0, 0, 0, 0, 0, 0, 0, 0, 0, 0, 0, 0, 0, 0, 0, 0, 0, 0, 0, 0, 0, 0, 0, 0, 0, 0, 0, 0, 0, 0, 0, 0, 0}, // 5 - DIGI1
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
      {0, 0, 0, 0, 0, 0, 0, 0, 0, 0, 0, 0, 0, 0, 0, 0, 0, 0, 0, 0, 0, 0, 0, 0, 0, 0, 0, 0, 0, 0, 0, 0, 0, 0, 0, 0, 0, 0, 0, 0, 0, 0, 0, 0, 0, 0, 0, 0, 0, 0, 0, 0, 0, 0, 0, 0, 0, 0, 0, 0, 0, 0, 0, 0}, // 30 - organ notes 2 p1
      {0, 0, 0, 0, 0, 0, 0, 0, 0, 0, 0, 0, 0, 0, 0, 0, 0, 0, 0, 0, 0, 0, 0, 0, 0, 0, 0, 0, 0, 0, 0, 0, 0, 0, 0, 0, 0, 0, 0, 0, 0, 0, 0, 0, 0, 0, 0, 0, 0, 0, 0, 0, 0, 0, 0, 0, 0, 0, 0, 0, 0, 0, 0, 0}, // 31 - organ notes 2 p2
      {0, 0, 0, 0, 0, 0, 0, 0, 0, 0, 0, 0, 0, 0, 0, 0, 0, 0, 0, 0, 0, 0, 0, 0, 0, 0, 0, 0, 0, 0, 0, 0, 0, 0, 0, 0, 0, 0, 0, 0, 0, 0, 0, 0, 0, 0, 0, 0, 0, 0, 0, 0, 0, 0, 0, 0, 0, 0, 0, 0, 0, 0, 0, 0}, // 32 - organ notes 3 p1
      {0, 0, 0, 0, 0, 0, 0, 0, 0, 0, 0, 0, 0, 0, 0, 0, 0, 0, 0, 0, 0, 0, 0, 0, 0, 0, 0, 0, 0, 0, 0, 0, 0, 0, 0, 0, 0, 0, 0, 0, 0, 0, 0, 0, 0, 0, 0, 0, 0, 0, 0, 0, 0, 0, 0, 0, 0, 0, 0, 0, 0, 0, 0, 0}, // 33 - organ notes 3 p2
      {0, 0, 0, 0, 0, 0, 0, 0, 0, 0, 0, 0, 0, 0, 0, 0, 0, 0, 0, 0, 0, 0, 0, 0, 0, 0, 0, 0, 0, 0, 0, 0, 0, 0, 0, 0, 0, 0, 0, 0, 0, 0, 0, 0, 0, 0, 0, 0, 0, 0, 0, 0, 0, 0, 0, 0, 0, 0, 0, 0, 0, 0, 0, 0}, // 34 - organ notes 4 p1
      {0, 0, 0, 0, 0, 0, 0, 0, 0, 0, 0, 0, 0, 0, 0, 0, 0, 0, 0, 0, 0, 0, 0, 0, 0, 0, 0, 0, 0, 0, 0, 0, 0, 0, 0, 0, 0, 0, 0, 0, 0, 0, 0, 0, 0, 0, 0, 0, 0, 0, 0, 0, 0, 0, 0, 0, 0, 0, 0, 0, 0, 0, 0, 0}, // 35 - organ notes 4 p2
      {0, 0, 0, 0, 0, 0, 0, 0, 0, 0, 0, 0, 0, 0, 0, 0, 0, 0, 0, 0, 0, 0, 0, 0, 0, 0, 0, 0, 0, 0, 0, 0, 0, 0, 0, 0, 0, 0, 0, 0, 0, 0, 0, 0, 0, 0, 0, 0, 0, 0, 0, 0, 0, 0, 0, 0, 0, 0, 0, 0, 0, 0, 0, 0}, // 36 - organ notes 5 p1
      {0, 0, 0, 0, 0, 0, 0, 0, 0, 0, 0, 0, 0, 0, 0, 0, 0, 0, 0, 0, 0, 0, 0, 0, 0, 0, 0, 0, 0, 0, 0, 0, 0, 0, 0, 0, 0, 0, 0, 0, 0, 0, 0, 0, 0, 0, 0, 0, 0, 0, 0, 0, 0, 0, 0, 0, 0, 0, 0, 0, 0, 0, 0, 0}  // 37 - organ notes 5 p2

  };

  float settings[64] = {120, 0, 16, 0, 0, 0, 0, 0, 0, 0, 0, 0, 0, 0, 0, 0, 0, 0, 0, 0, 0, 0, 0, 0, 0, 0, 0, 0, 0, 0, 0, 0, 0, 0, 0, 0, 0, 0, 0, 0, 0, 0, 0, 0, 0, 0, 0, 0, 0, 0, 0, 0, 0, 0, 0, 0, 0, 0, 0, 0, 0, 0, 0, 0}; // array of global settings for pattern
  // [0] tempo
  // [1] kit number
  // [2] pattern length
  // [3]
  // [4]
  // [5]
  // [6]
  // [7]
  // [8]
  // [9]
  // [10]
  // [11]
  // [12]
  // [13]
  // [14]
  // [15]
  //...
  // [48-63] pattern name in ascii

  char name[17] = "                \0";

  const int sdChipSelect = BUILTIN_SDCARD;
  const int flashChipSelect = 6;
  Pattern()
  {
  }

  ///**************************************************************************************************
  // * Function readFromSD
  // * -------------------------------------------------------------------------------------------------
  // * Overview: reads pattern from CSV on SD card
  // * Input:
  // *      const char* path: path of CSV to read on SD card
  // * Output: Nothing
  // **************************************************************************************************/
  void readFromSD(const char *path) // READS PATTERN FROM CSV ON SD CARD
  {
    // format for drum pattern: data types of each column in CSV
    CSV_Parser cp(/*format*/ "LfLfLfLfLfLfLLLfLLLfLLLfffLfffLfffLfffLfffLfffLfffLffffLfffLfffLfffLfffLfffLfffLfffLfff", /*has_header*/ true, /*delimiter*/ ',');

    if (cp.readSDfile(path))
    {
      // copy steps to internal memory
      memcpy(pattern[0], (int32_t *)cp["kk"], 256);
//      int32_t *numm = (int32_t*)cp["s"];
//      for (int i = 0; i < 16; i++){
//        pattern[0][i] = numbers[i];
//      }
      memcpy(pattern[1], (int32_t *)cp["s"], 256);
      memcpy(pattern[2], (int32_t *)cp["c1"], 256);
      memcpy(pattern[3], (int32_t *)cp["c2"], 256);
      memcpy(pattern[4], (int32_t *)cp["g"], 256);
      memcpy(pattern[5], (int32_t *)cp["d1"], 256);
      memcpy(pattern[6], (int32_t *)cp["d2"], 256);
      memcpy(pattern[7], (int32_t *)cp["d3"], 256);
      memcpy(pattern[8], (int32_t *)cp["s1"], 256);
      memcpy(pattern[9], (int32_t *)cp["s2"], 256);
      memcpy(pattern[10], (int32_t *)cp["s3"], 256);
      memcpy(pattern[11], (int32_t *)cp["s4"], 256);
      memcpy(pattern[12], (int32_t *)cp["s5"], 256);
      memcpy(pattern[13], (int32_t *)cp["s6"], 256);
      memcpy(pattern[14], (int32_t *)cp["s7"], 256);
      memcpy(pattern[15], (int32_t *)cp["s8"], 256);
      memcpy(pattern[16], (int32_t *)cp["oc"], 256);
      memcpy(pattern[17], (int32_t *)cp["gc"], 256);
      memcpy(pattern[18], (int32_t *)cp["go"], 256);
      memcpy(pattern[19], (int32_t *)cp["on"], 256);
      memcpy(pattern[20], (int32_t *)cp["on2"], 256);
      memcpy(pattern[21], (int32_t *)cp["on3"], 256);
      memcpy(pattern[22], (int32_t *)cp["on4"], 256);
      memcpy(pattern[23], (int32_t *)cp["on5"], 256);

      // copy velocities to internal memory
      memcpy(velocity[0], (float *)cp["kv"], 256);
      memcpy(velocity[1], (float *)cp["sv"], 256);
      memcpy(velocity[2], (float *)cp["c1v"], 256);
      memcpy(velocity[3], (float *)cp["c2v"], 256);
      memcpy(velocity[4], (float *)cp["gv"], 256);
      memcpy(velocity[5], (float *)cp["d1v"], 256);
      memcpy(velocity[6], (float *)cp["d2v"], 256);
      memcpy(velocity[7], (float *)cp["d3v"], 256);
      memcpy(velocity[8], (float *)cp["s1v"], 256);
      memcpy(velocity[9], (float *)cp["s2v"], 256);
      memcpy(velocity[10], (float *)cp["s3v"], 256);
      memcpy(velocity[11], (float *)cp["s4v"], 256);
      memcpy(velocity[12], (float *)cp["s5v"], 256);
      memcpy(velocity[13], (float *)cp["s6v"], 256);
      memcpy(velocity[14], (float *)cp["s7v"], 256);
      memcpy(velocity[15], (float *)cp["s8v"], 256);
      memcpy(velocity[16], (float *)cp["ocv"], 256);
      memcpy(velocity[17], (float *)cp["gcv"], 256);
      memcpy(velocity[18], (float *)cp["gov"], 256);
      memcpy(velocity[19], (float *)cp["onv"], 256);
      memcpy(velocity[20], (float *)cp["on2v"], 256);
      memcpy(velocity[21], (float *)cp["on3v"], 256);
      memcpy(velocity[22], (float *)cp["on4v"], 256);
      memcpy(velocity[23], (float *)cp["on5v"], 256);
      
      // copy parameters to internal memory
      memcpy(parameter[0], (float *)cp["d1p"], 256);
      memcpy(parameter[1], (float *)cp["d1pp"], 256);
      memcpy(parameter[2], (float *)cp["d2p"], 256);
      memcpy(parameter[3], (float *)cp["d2pp"], 256);
      memcpy(parameter[4], (float *)cp["d3p"], 256);
      memcpy(parameter[5], (float *)cp["d3pp"], 256);
      memcpy(parameter[6], (float *)cp["s1p"], 256);
      memcpy(parameter[7], (float *)cp["s1pp"], 256);
      memcpy(parameter[8], (float *)cp["s2p"], 256);
      memcpy(parameter[9], (float *)cp["s2pp"], 256);
      memcpy(parameter[10], (float *)cp["s3p"], 256);
      memcpy(parameter[11], (float *)cp["s3pp"], 256);
      memcpy(parameter[12], (float *)cp["s4p"], 256);
      memcpy(parameter[13], (float *)cp["s4pp"], 256);
      memcpy(parameter[14], (float *)cp["s5p"], 256);
      memcpy(parameter[15], (float *)cp["s5pp"], 256);
      memcpy(parameter[16], (float *)cp["s6p"], 256);
      memcpy(parameter[17], (float *)cp["s6pp"], 256);
      memcpy(parameter[18], (float *)cp["s7p"], 256);
      memcpy(parameter[19], (float *)cp["s7pp"], 256);
      memcpy(parameter[20], (float *)cp["s8p"], 256);
      memcpy(parameter[21], (float *)cp["s8pp"], 256);
      memcpy(parameter[22], (float *)cp["ocp1"], 256);
      memcpy(parameter[23], (float *)cp["ocp2"], 256);
      memcpy(parameter[24], (float *)cp["gcp1"], 256);
      memcpy(parameter[25], (float *)cp["gcp2"], 256);
      memcpy(parameter[26], (float *)cp["gop1"], 256);
      memcpy(parameter[27], (float *)cp["gop2"], 256);
      memcpy(parameter[28], (float *)cp["onp1"], 256);
      memcpy(parameter[29], (float *)cp["onp2"], 256);
      memcpy(parameter[30], (float *)cp["on2p1"], 256);
      memcpy(parameter[31], (float *)cp["on2p2"], 256);
      memcpy(parameter[32], (float *)cp["on3p1"], 256);
      memcpy(parameter[33], (float *)cp["on3p2"], 256);
      memcpy(parameter[34], (float *)cp["on4p1"], 256);
      memcpy(parameter[35], (float *)cp["on4p2"], 256);
      memcpy(parameter[36], (float *)cp["on5p1"], 256);
      memcpy(parameter[37], (float *)cp["on5p2"], 256);

      // copy settings to internal memory
      memcpy(settings, (float *)cp["sett"], 256);
      int ind = 0;
      for (int i = 48; i < 64; i++){
        if (settings[i] == 0){
          name[ind] = ' ';
        } else {
          name[ind] = settings[i];
        }

        ind += 1;
      }
//      name[0] = 'k';
      name[16] = '\0';
//      Serial.println(name);
      
    } else {
      Serial.println("Pattern not found");
    }
  }

  ///**************************************************************************************************
  // * Function printPattern
  // * -------------------------------------------------------------------------------------------------
  // * Overview: prints pattern to Serial port
  // * Input: Nothingg
  // * Output: Nothing
  // **************************************************************************************************/
  void printPattern()
  { // PRINTS PATTERN TO SERIAL MONITOR
    //      //print out the pattern
    Serial.println(name);
    for (int i = 0; i < 64; i++)
    {
      for (int j = 0; j < 24; j++)
      {
        Serial.print(pattern[j][i]);
        Serial.print(" ");
      }
      Serial.println(" ");
    }

    // print out the velocities
    for (int i = 0; i < 64; i++)
    {
      for (int j = 0; j < 24; j++)
      {
        Serial.print(velocity[j][i]);
        Serial.print(" ");
      }
      Serial.println(" ");
    }
    // print out the digital voice parameters
    for (int i = 0; i < 64; i++)
    {
      for (int j = 0; j < 38; j++)
      {
        Serial.print(parameter[j][i]);
        Serial.print(" ");
      }
      Serial.println(" ");
    }

    // print out settings
    for (int i = 0; i < 64; i++)
    {
      Serial.print(settings[i]);
      Serial.print(" ");
    }
    Serial.println(" ");
  }

  ///**************************************************************************************************
  // * Function writePatternToSD
  // * -------------------------------------------------------------------------------------------------
  // * Overview: Writes a Pattern object to a CSV file on SD card
  // * Input:
  //          path: path on SD card to write pattern to
  // * Output:
  // **************************************************************************************************/
  void writePatternToSD(const char *path)
  {
    //move name to settings array
    int ind = 0;
      for (int i = 48; i < 64; i++){
        if(name[ind] == ' '){
          settings[i] = 0;
        } else {
          settings[i] = name[ind];
        }
        ind += 1;
      }
      
    // clear out old data file
    if (SD.exists(path))
    {
//      Serial.println("Removing old csv");
      SD.remove(path);
//      Serial.println("Done");
    }

    // create new file
    File myFile = SD.open(path, FILE_WRITE);
    if (myFile)
    {
//      Serial.println("Writing headers to new CSV"); // writing header row to CSV
      myFile.println("kk,kv,s,sv,c1,c1v,c2,c2v,g,gv,d1,d1v,d1p,d1pp,d2,d2v,d2p,d2pp,d3,d3v,d3p,d3pp,s1,s1v,s1p,s1pp,s2,s2v,s2p,s2pp,s3,s3v,s3p,s3pp,s4,s4v,s4p,s4pp,s5,s5v,s5p,s5pp,s6,s6v,s6p,s6pp,s7,s7v,s7p,s7pp,s8,s8v,s8p,s8pp,sett,oc,ocv,ocp1,ocp2,gc,gcv,gcp1,gcp2,go,gov,gop1,gop2,on,onv,onp1,onp2,on2,on2v,on2p1,on2p2,on3,on3v,on3p1,on3p2,on4,on4v,on4p1,on4p2,on5,on5v,on5p1,on5p2");
//      Serial.println("Headers written");

      // writing all pattern data to CSV
      for (int i = 0; i < 64; i++)
      {
        myFile.print(pattern[0][i]); // KICK
        myFile.print(",");
        myFile.print(velocity[0][i]);
        myFile.print(",");

        myFile.print(pattern[1][i]); // SNARE
        myFile.print(",");
        myFile.print(velocity[1][i]);
        myFile.print(",");

        myFile.print(pattern[2][i]); // CYNARE 1
        myFile.print(",");
        myFile.print(velocity[2][i]);
        myFile.print(",");

        myFile.print(pattern[3][i]); // CCYNARE 2
        myFile.print(",");
        myFile.print(velocity[3][i]);
        myFile.print(",");

        myFile.print(pattern[4][i]); // GLITCH
        myFile.print(",");
        myFile.print(velocity[4][i]);
        myFile.print(",");

        myFile.print(pattern[5][i]); // DIGITAL VOICE 1
        myFile.print(",");
        myFile.print(velocity[5][i]);
        myFile.print(",");
        myFile.print(parameter[0][i]);
        myFile.print(",");
        myFile.print(parameter[1][i]);
        myFile.print(",");

        myFile.print(pattern[6][i]); // DIGITAL VOICE 2
        myFile.print(",");
        myFile.print(velocity[6][i]);
        myFile.print(",");
        myFile.print(parameter[2][i]);
        myFile.print(",");
        myFile.print(parameter[3][i]);
        myFile.print(",");

        myFile.print(pattern[7][i]); // DIGITAL VOICE 3
        myFile.print(",");
        myFile.print(velocity[7][i]);
        myFile.print(",");
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

        myFile.print(pattern[21][i]); // Organ notes 3
        myFile.print(",");
        myFile.print(velocity[21][i]);
        myFile.print(",");
        myFile.print(parameter[32][i]);
        myFile.print(",");
        myFile.print(parameter[33][i]);
        myFile.print(",");

        myFile.print(pattern[22][i]); // Organ notes 4
        myFile.print(",");
        myFile.print(velocity[22][i]);
        myFile.print(",");
        myFile.print(parameter[34][i]);
        myFile.print(",");
        myFile.print(parameter[35][i]);
        myFile.print(",");

        myFile.print(pattern[23][i]); // Organ notes 5
        myFile.print(",");
        myFile.print(velocity[23][i]);
        myFile.print(",");
        myFile.print(parameter[36][i]);
        myFile.print(",");
        myFile.println(parameter[37][i]);
      }
      myFile.close();
    }
  }

  ///**************************************************************************************************
  // * Function clearPattern
  // * -------------------------------------------------------------------------------------------------
  // * Overview: clears pattern by deactivating all steps and setting volume, and parameters to neutral values
  // *           tempo is set to 120 BPM
  // * Input: Nothing
  // * Output: Nothing
  // **************************************************************************************************/
  void clearPattern()
  {
    for (int i = 0; i < 64; i++)
    {
      for (int j = 0; j < 24; j++)
      {
        pattern[j][i] = 0;
        velocity[j][i] = 1;
      }

      for (int j = 0; j < 38; j++)
      {
        parameter[j][i] = 1;
      }
      parameter[7][i] = 100; // setting sample lengths to 100
      parameter[9][i] = 100;
      parameter[11][i] = 100;
      parameter[13][i] = 100;
      parameter[15][i] = 100;
      parameter[17][i] = 100;
      parameter[19][i] = 100;
      parameter[21][i] = 100;
      parameter[22][i] = 0; // setting chord types to major
      parameter[24][i] = 0;
      parameter[26][i] = 0;
      
      settings[i] = 0;
    }
    settings[0] = 120; // set tempo to 120 BPM
    settings[2] = 16; // set pattern length to 16
  }
};
