masonandrewmann/drum_machine/software_design/drum_machine/flashloader.h

/* Audio Library for Teensy
 * Copyright (c) 2021, Nic Newdigate
 *
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
 * THE SOFTWARE IS PROVIDED "AS IS", WITHOUT WARRANTY OF ANY KIND, EXPRESS OR
 * IMPLIED, INCLUDING BUT NOT LIMITED TO THE WARRANTIES OF MERCHANTABILITY,
 * FITNESS FOR A PARTICULAR PURPOSE AND NONINFRINGEMENT. IN NO EVENT SHALL THE
 * AUTHORS OR COPYRIGHT HOLDERS BE LIABLE FOR ANY CLAIM, DAMAGES OR OTHER
 * LIABILITY, WHETHER IN AN ACTION OF CONTRACT, TORT OR OTHERWISE, ARISING FROM,
 * OUT OF OR IN CONNECTION WITH THE SOFTWARE OR THE USE OR OTHER DEALINGS IN
 * THE SOFTWARE.
 */

#ifndef TEENSY_SAMPLE_FLASHLOADER_FLASHLOADER_H
#define TEENSY_SAMPLE_FLASHLOADER_FLASHLOADER_H

#include <Arduino.h>
#include <SD.h>

extern "C" uint8_t external_psram_size;

namespace newdigate {

    const uint32_t flashloader_default_sd_buffersize = 4 * 1024;
    const uint32_t flash_offset = 0x10000;
    const uint32_t audio_offset = 7000000; // add 5 megabyte offset for non-audio sample variables, may need to increase if patterns etc get real big

    struct audiosample {
        int16_t *sampledata;
        uint32_t samplesize;
    };

    class flashloader {
    public:

        flashloader() {
            uint8_t size = external_psram_size;
            _bytesavailable = size * 1048576 - flash_offset;
            memory_begin = (uint32_t *)(0x70000000 + flash_offset + audio_offset); //last hex number is me trying to add an offset to account for pattern storage
            memory_end = (uint32_t *)(0x70000000 + flash_offset + _bytesavailable);
            Serial.printf("SerialFlash for samples: %d\n", _bytesavailable);
        }

        uint32_t _bytesavailable=0;
        audiosample * loadSample(const char *filename );
        uint32_t *memory_begin, *memory_end;
        uint32_t _head = 0;
    };
};
#endif
