masonandrewmann/drum_machine/software_design/tests/simpleTriggerTest/simpleTriggerTest.ino

void setup() {
  // put your setup code here, to run once:
  pinMode(12, OUTPUT);
  Serial.begin(9600);
}

void loop() {
  // put your main code here, to run repeatedly:
  digitalWrite(12, HIGH);
  delay(1000);

  digitalWrite(12, LOW);
  delay(50);

//  Serial.println(digitalRead(4));
//  delay(10);
  
}
