masonandrewmann/drum_machine/software_design/tests/LCD_TEST/LCD_anim_test/frames.h

static unsigned char frame1[] = {
 0x00,0x00,0x00,0x00,0x00,0x00,0x00,0x00,0x00,0x00,0xf0,0x00,
 0x00,0x00,0x00,0x00,0x00,0x00,0x00,0x00,0x00,0xf0,0x00,0x00,
 0x00,0x00,0x00,0x00,0x00,0x00,0x00,0x00,0xf0,0x00,0x00,0x00,
 0x00,0x00,0x00,0x00,0x00,0x00,0x00,0xf0,0x00,0x00,0x00,0x00,
 0x00,0x00,0x00,0x00,0x00,0x00,0xf0,0x00,0x00,0x00,0x00,0x00,
 0x00,0x00,0x00,0x00,0x00,0xf0,0x00,0x00,0x00,0x00,0x00,0x00,
 0x00,0x00,0x00,0x00,0xf0,0x00,0x00,0x00,0x00,0x00,0x00,0x00,
 0x00,0x00,0x00,0xf0,0x00,0x00,0x00,0x00,0x00,0x00,0x00,0x00,
 0x00,0x00,0xf0,0x00,0x00,0x00,0x00,0x00,0x00,0x00,0x00,0x00,
 0x00,0xf0,0x00,0x00,0x00,0x00,0x30,0x00,0x00,0x00,0x00,0x00,
 0xf0,0x00,0x00,0x01,0x00,0x38,0x00,0x00,0x00,0x00,0x00,0xf0,
 0x00,0x00,0x03,0x00,0x3e,0x00,0x00,0x00,0x00,0x00,0xf0,0x00,
 0x00,0x0f,0x80,0x11,0x00,0x00,0x00,0x00,0x00,0xf0,0x00,0x00,
 0x3a,0xe0,0x10,0x00,0x00,0x00,0x00,0x00,0xf0,0x00,0x00,0xe2,
 0x30,0x18,0x00,0x00,0x00,0x00,0x00,0xf0,0x00,0x00,0x84,0x0b,
 0x0c,0x00,0x00,0x00,0x00,0x00,0xf0,0x00,0x00,0x04,0x06,0x0c,
 0x00,0x00,0x00,0x00,0x00,0xf0,0x00,0x00,0x04,0x00,0x0c,0x00,
 0x00,0x00,0x00,0x00,0xf0,0x00,0x00,0x08,0x00,0x06,0x00,0x00,
 0x00,0x00,0x00,0xf0,0x00,0x00,0x08,0x00,0x06,0x00,0x00,0x00,
 0x00,0x00,0xf0,0x00,0x00,0x08,0x00,0x0c,0x00,0x00,0x00,0x00,
 0x00,0xf0,0x00,0x00,0x08,0x00,0x38,0x00,0x00,0x00,0x00,0x00,
 0xf0,0x00,0x00,0x10,0x00,0x60,0x00,0x00,0x00,0x00,0x00,0xf0,
 0x00,0x00,0x18,0x00,0xc0,0x01,0x00,0x00,0x00,0x00,0xf0,0x00,
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
  0x00, 0x00, 0x00, 0x00, 0x00, 0x00, 0x00, 0x00, 0x00, 0x00, 0x00, 0x00,
  0x00, 0x00, 0x00, 0x00, 0x00, 0x00, 0x00, 0x00, 0x00, 0x00, 0x00, 0x00,
  0x00, 0x00, 0x00, 0x00, 0x00, 0x00, 0x00, 0x00, 0x00, 0x00, 0x00, 0x00,
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
};
