masonandrewmann/drum_machine/(commit log)

2023-01-11 big update, basic drum sequencing is working here
    [AnalogIn.sch, ButtonInput.sch, Decoupling.sch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]
2023-01-13 basics working
    [DrumMachineControlBoard.kicad_pcb, PXXX__TEST2__DrumMachineControlBoard-brd_.dxf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]
2023-01-25 pattern saving works
    [DrumMachineControlBoard.kicad_pcb]
2023-01-31 before trying QSPI sample playback
2023-02-01 samples playing from SPI RAM
    [BassDrum_TR909-B_Mask.dxf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]
2023-02-01 some reorganizing
    [1.CSV, 10.CSV, 11.CSV, 12.CSV, 13.CSV, 14.CSV, 15.CSV, 16.CSV]
2023-02-01 cleaned up pattern chaining
2023-02-02 sample voice parameters are saved to SD per pattern
2023-02-02 fixed pattern save bug
    [Pattern.h]
2023-02-02 sd patterns updated
    [1.CSV, 10.CSV, 11.CSV, 12.CSV, 13.CSV, 14.CSV, 15.CSV, 16.CSV]
2023-02-03 swing implemented
    [1.CSV, 10.CSV, 11.CSV, 12.CSV, 13.CSV, 14.CSV, 15.CSV, 16.CSV]
2023-02-14 press tempo encoder to view tempo
2023-02-15 cleaned up kit switching and fixed some silly little glitches
    [Pattern.h, drum_machine.ino]
2023-02-16 added two chord sample voices
2023-02-17 added melody voice
    [1.CSV, 10.CSV, 11.CSV, 12.CSV, 13.CSV, 14.CSV, 15.CSV, 16.CSV]
2023-02-17 swapped some samples and expanded pattern object
    [Pattern.h, drum_machine.ino]
2023-02-17 implemented 5 more sample note voices
2023-02-17 first attempt at long patterns, its not workinggit add . memory problems i think
    [Pattern.h, drum_machine.ino]
2023-02-17 fixed some silly memory usage stuff, modified start mem in flashloader.h
    [drum_machine.ino, flashloader.cpp, flashloader.h]
2023-02-18 up to date but theres some crazy distortion going on with the samples
2023-02-21 fixed sprintf omtimizer error and added copy paste and clear to patterns
    [Pattern.h, drum_machine.ino]
2023-02-23 updated SD backup
    [1.CSV, 10.CSV, 11.CSV, 12.CSV, 13.CSV, 14.CSV, 15.CSV, 16.CSV]
